akaalias/airloom/docs/designer_log.md

# Designer rounds (headless Claude)

## generation 0 (opening)
*model: claude-haiku-4-5-20251001, claude-sonnet-5*
- `89ffb906b148` — Storm-hardened stiff bruiser: wide thick arms, long wheelbase and thick carbon plates trade mass for structural robustness, targeting the storm scenario that dominates worst-case fitness.
- `7792e42599f3` — Long low-disk-loading arms at exact stock sweep with a safely-oversized plate footprint and carbon construction, targeting hot_thin efficiency without touching the plate-web failure zone.
- `59b9a52c15fa` — Compact, wide, stiff-armed storm-hardened design with a modest sweep shift and generous deck_gap/plate scale margin to clear the prior rotor-to-deck failure.
- `9f8cb660ef38` — Narrow low-drag arms with a tilted battery to cut frontal area for cold_headwind/crosswind, keeping sweep change modest and deck_gap raised for safety margin.
- `9be55419299a` — Heavy-duty ASA build with thick plates and wide arms near stock sweep for maximum stiffness/durability robustness in storm gusts, accepting a mass penalty.
- ~~rejected pre-flight (plate web too thin (plate_main 1.25 mm, stock 1.90 mm))~~ — Low-drag speed racer: long slender waisted arms and minimal-frontal-area carbon-plate build at stock sweeps to hold bolt registration while chasing the lowest steady-cruise Wh/km.
- ~~rejected pre-flight (plate web too thin (plate_main 1.07 mm, stock 1.90 mm))~~ — Ultralight hot/thin-air specialist: short thin arms and PLA+ at the minimum viable plate thickness to cut absolute mass for low-density-air scenarios.
- ~~rejected pre-flight (rotor too close to deck/battery)~~ — Wide-sweep compact X hypothesis: pushes both sweeps ~6-7 deg past stock for a tighter crosswind silhouette, growing the deck plates to protect the tongue bolts, printed in tough PA12-CF.
- ~~rejected pre-flight (plate web too thin (plate_main 1.07 mm, stock 1.90 mm))~~ — Cold-headwind glider: near-minimum sweeps (kept just off the exact minimum to dodge tongue collision) with narrow waisted arms and a steep battery wedge to minimize frontal area into a headwind, printed PETG.

## generation 3 (periodic)
*model: claude-haiku-4-5-20251001, claude-sonnet-5*
- `edbeb4914449` — Moderate-stiffness storm specialist: wider/thicker arms with less waist-narrowing and tough PA12-CF material plus generous deck_gap, betting that structural robustness (not raw mass-adding bulk like earlier failed 'storm-hardened' attempts) trims the worst-case storm penalty.
- `a76a6566ac11` — Wider front/rear sweep for a broader stance to help crosswind/storm stability, paired with generously enlarged (not merely stock) plate scales and deck_gap to safely clear the tongue-bolt and web-crush failures seen at extreme sweep.
- `4ac6230067c7` — Near-stock sweep (small deltas, clear of the tongue-collision minimum) with plate scales pushed well above the 0.95 web-crush threshold and a thicker printed PLA+ build to test a tougher, mass-tolerant alternative to carbon.
- ~~rejected pre-flight (arm tongue bolts miss the main plate)~~ — Sweep-diverged crosswind hypothesis: push rotor azimuth well past stock (front 40, rear 48) with plate scales raised ~0.15 per the coupling rule to protect the FC-stack webs, testing an unexplored rotor-placement regime for crosswind/storm gains.
- ~~rejected pre-flight (plate web too thin (plate_main 1.43 mm, stock 1.90 mm))~~ — Ultra-light short-wheelbase design: shrink arm length and deck_gap to their safe minimums with stock sweeps (avoiding the plate-web/tongue failure zone) and thinner plates, betting mass reduction beats the elites' 114-116 g on hot_thin.

## generation 6 (periodic)
*model: claude-haiku-4-5-20251001, claude-sonnet-5*
- `7b8317ed444b` — Storm-stiffness specialist: a moderately wider stance (5 deg beyond stock both sweeps, plate scales raised per the sweep-deviation rule) with less waist-narrowing and thicker arms/plates than the elites for gust stiffness, while staying on lightweight carbon to avoid the mass penalty that sank earlier 'storm bruiser' attempts.
- `ed5a193d02ea` — Storm-hardened stiff-arm design with arm_length_scale raised to 1.20 (vs the failed 0.88) to restore rotor tip clearance at a near-stock sweep, plus generous plate margins to guard the tongue-bolt/web-crush zones.
- `0744daafc6e2` — Wide-stance crosswind/storm specialist that pushes both sweeps ~6-7 deg past stock for a broader footprint, with plate_length/width_scale raised well past 1.0 (per the ~0.1-per-5-deg rule) to keep the tongue bolts seated and the plate webs thick.
- ~~rejected pre-flight (rotor disks overlap (tip clearance))~~ — Compact minimal-mass frame: shortens the wheelbase and thins arm/plate stock well below the elite cluster to shed frame mass for hot_thin/cruise efficiency, betting that the elites' long-arm strategy has more mass to give up than disk-loading penalty to pay at stock sweep.
- ~~rejected pre-flight (plate web too thin (plate_main 1.44 mm, stock 1.90 mm))~~ — Low-drag headwind/crosswind specialist: minimum arm width and waist plus an aggressive near-max battery tilt at exactly stock sweep to cut frontal/cross-sectional area, targeting the wind-facing scenarios rather than mass.

## generation 9 (periodic)
*model: claude-haiku-4-5-20251001, claude-sonnet-5*
- `8d9fd4a01c9a` — Push arm_length_scale near its max (lowers disk loading) with thin low-drag arms and deliberately cut plate_thickness_scale to 0.75 (below any elite) to shed mass for hot_thin/crosswind, keeping sweep essentially at stock so plate scales need no compensation.
- `01f642b698ee` — Isolate the effect of a genuinely wide stance (front/rear sweep pushed well past stock) from the thick-arm mass penalty that sank earlier wide-stance attempts, by pairing it with thin floor-waist arms and plate scales raised generously to keep the tongue bolts and webs safely clear.
- `2ab37da5aded` — Replaces the failed vector by raising deck_gap well past the elite range (0.034 vs 0.028) and restoring a stiffer plate_thickness_scale (1.1 vs the failed 0.9) to push the rotor disk clear of the deck/battery stack while keeping near-stock sweeps and carbon construction.
- ~~rejected pre-flight (rotor too close to deck/battery)~~ — Test whether a tough printed material (PA12-CF) at the minimum viable plate thickness can match carbon's efficiency on a lean, near-stock-sweep frame, unlike prior bulky printed-material attempts that added unnecessary mass.

## generation 12 (periodic)
*model: claude-haiku-4-5-20251001, claude-sonnet-5*
- `af1499695456` — Isolate the untested battery_wedge_deg dimension (all elites sit at 0.0) by tilting the battery 12 deg to cut frontal area for cold_headwind/crosswind, otherwise cloning the elite recipe's proven arm/plate/material values exactly.
- `ddf19b536a16` — Re-test extreme arm_length_scale (1.35 max, lower disk loading) at stock sweep, this time with plate_length/width_scale raised to 1.00/1.03 (above the elite's barely-passing 0.97/1.00) to keep the tongue-bolt web safely above the 1.90mm stock/80% floor.
- `17da73c894cb` — Re-test the raised deck_gap (0.036, well past the 0.023 FC-stack minimum) for extra rotor/deck clearance margin, again pairing stock sweep with plate_length/width_scale at 1.00/1.03 to avoid the web-crush failure that killed the prior attempt at 0.96/0.96.
- ~~rejected pre-flight (plate web too thin (plate_main 1.25 mm, stock 1.90 mm))~~ — Push arm_length_scale to its true maximum (1.35, beyond any elite's ~1.30) to further lower disk loading and hover power, while keeping arms at floor width/waist/thickness, sweeps at exact stock (zero plate-scale compensation needed), and floor plate thickness/carbon to stay in the proven low-mass recipe.
- ~~rejected pre-flight (plate web too thin (plate_main 1.25 mm, stock 1.90 mm))~~ — Isolate deck_gap as a storm-clearance lever by raising it to 0.036 (well past the elite ~0.026 and the FC-stack minimum) while holding plate_thickness_scale at the floor and sweeps at exact stock, unlike the earlier failed deck_gap attempt that confounded the effect with added plate mass.

## generation 13 (pivot)
*model: claude-haiku-4-5-20251001, claude-sonnet-5*
- `e28f02892326` — Abandon the elite family's tight-deck-gap/no-wedge/floor-thickness trait: push deck_gap near its max for maximum rotor/deck clearance, tilt the battery near its max to cut frontal area, and raise plate_thickness_scale well above the floor for a stiffer core, while holding sweep at stock and arms moderate so none of these three untested dimensions gets confounded with a sweep or mass penalty.
- `197c23808897` — Compact stiff-arm storm specialist replacing the failed short-arm attempt: arm_length_scale raised from the failed 0.78 to 1.2 (within the tip-clearance-safe range the elites themselves use) while keeping the fat, thick, low-narrowing arms and thicker plates that trade mass for storm stiffness the elite family has abandoned.
- `3844ac93fc4c` — Wide-stance crosswind/storm pivot replacing the failed extreme-sweep attempt: sweep deltas trimmed from 11.6/14 deg to a safer 6.6/8 deg past stock and plate_length/width_scale pushed to 1.10/1.15 (well beyond the ~0.1-per-5-deg rule) to keep the tongue bolts seated on the main plate.
- ~~rejected pre-flight (rotor disks overlap (tip clearance))~~ — Abandon the elite family's max-arm-length/thin-everything trait entirely: shrink to near-minimum arm length for higher disk loading but restore arm width/waist/thickness toward the middle of the range for real structural stiffness, testing whether a compact stiff core beats the plateaued long-thin-arm minimalism on storm without paying its usual mass tax.
- ~~rejected pre-flight (arm tongue bolts miss the main plate)~~ — Abandon the elite family's stock-sweep constraint: push both sweeps far beyond stock for a genuinely wide stance (unlike prior failed wide-stance attempts that piled on thick arms), while keeping arms thin/light for low drag/mass and raising plate_length/width_scale well past the web-crush floor so the tongue bolts and webs stay safely seated, isolating stance-width benefit from the mass penalty t

## generation 14 (pivot)
*model: claude-haiku-4-5-20251001, claude-sonnet-5*
- `03a2ffd572b3` — The elite family has converged on a minimum-mass/minimum-drag recipe (thin floor-thickness arms, near-stock sweep, tight deck gap, carbon) that has exhausted every free-mass knob without denting the storm/crosswind penalty, so this pivot abandons near-stock sweep for a genuinely wide stance (front 40, rear 48 deg) with plate scales grown per the sweep-deviation rule to test whether real aerodynami
- `19c8d0829c1b` — Every elite uses material near 0.0 (pure carbon) because prior non-carbon attempts bundled the material switch with a heavy 'storm bruiser' stance that ate the mass budget, so this pivot isolates the material axis alone -- keep the proven elite-shaped long-arm, low-drag, near-stock-sweep geometry intact but swap to PET-CF (0.40) with plate_thickness_scale raised to 0.90 to meet the printed-materia
- `e8b475371bd4` — Re-test the untested battery_wedge_deg=14 frontal-area-reduction dimension, fixing the rotor-tip-clearance failure by raising arm_length_scale from the failed 0.9 to a safe 1.2 while leaving sweep, plate scales and material untouched so only the battery tilt is isolated.
- ~~rejected pre-flight (rotor disks overlap (tip clearance))~~ — Every elite sits at arm_length_scale ~1.3 (low disk loading, long low-drag arms) with battery_wedge_deg untouched at 0, so this pivot flips both traits at once -- a compact, higher-disk-loading frame (arm_length_scale 0.90) paired with an aggressive 14 deg battery tilt to slash frontal area -- isolating whether a shorter/lighter airframe plus real drag-shedding tilt beats the long-arm family on co

## generation 15 (pivot)
*model: claude-haiku-4-5-20251001, claude-sonnet-5*
- `470c4fea7616` — Every elite also sits at the plate_thickness_scale floor (0.7-0.76) with a tight deck_gap (0.025-0.026) -- deck/standoff stiffness and rotor-to-deck clearance under gust loading have never been tested independently of arm geometry or a mass-adding stance change, so this pivot keeps the elite's low-drag floor-thin arms and stock sweep untouched but pushes plate_thickness_scale near its max and deck
- `a55c3afad400` — Storm-stiffness pivot away from the elite family's thin/minimum-mass arms (wide arm_width=1.4, no waist narrowing, thick arm_thickness=0.007, carbon) that failed only on rotor/deck clearance -- fixed by raising deck_gap from the failed 0.027 to 0.04, well clear of the stack.
- `4e66ffd73fcf` — Re-isolate the untested tough ASA material (0.75) against the all-carbon elite family, keeping the same generous arm geometry as the failed attempt but raising deck_gap to 0.042 and trimming plate_thickness_scale to 0.85 (still above the printed-material 0.8 floor) to clear the deck/battery stack.
- ~~rejected pre-flight (rotor too close to deck/battery)~~ — The elite family shares thin/narrow/floor-thickness arms (width 0.75-0.86, waist 0.55, thickness 0.004) with near-stock sweep -- storm has stayed pinned at 4.82-4.84 Wh/km across all of them despite every other scenario improving, suggesting arm flex under gust loading (not mass or drag) is now the binding constraint on storm; this isolates pure arm structural stiffness (max width, max waist/no-na
- ~~rejected pre-flight (rotor too close to deck/battery)~~ — Every elite and every prior material pivot has stayed at material~0.0 (carbon) because past non-carbon attempts bundled the switch with a heavy wide-stance or thin-arm combo that failed on tip deflection or web thickness; this isolates a genuinely tougher thermoplastic (PETG, 0.75) at stock sweep and elite-like plate scale, with arm width/waist pulled back from the elite's drag-optimized extremes 

## generation 16 (pivot)
*model: claude-haiku-4-5-20251001, claude-sonnet-5*
- `a072202cd3c9` — Every elite sits at the arm_waist_scale floor (0.55, maximum mid-shaft narrowing) paired with minimum width -- this pivot decouples the two, isolating waist taper as its own stiffness lever by raising arm_waist_scale to 1.10 (near-constant arm width along the shaft, no pinch point to flex/resonate under storm gusts) while keeping arm_width_scale, arm_thickness, sweep and plate geometry at the elit
- `cadb6dac34da` — Prior material pivots away from carbon always failed validity (arm tip deflection / plate-web-too-thin) because they kept the elite's thin-waist thin-arm shape unchanged for a lower-modulus polymer -- this pivot properly compensates by isolating PETG (damped, tough) with arm_thickness raised to 0.0065 and arm_waist_scale relaxed to 0.80 to prevent tip deflection, and plate_thickness_scale set to 1
- `f25111665ee7` — Replaces the failed 14-deg rear-sweep pivot: trims the deviation to 10 deg past stock and grows plate_length/width_scale to 1.22/1.25 (above the prior 1.15/1.2 that let the tongue bolts miss the main plate) while keeping the same lean thin-arm carbon build to isolate wide-stance stiffness from mass penalties.
- ~~rejected pre-flight (arm tongue bolts miss the main plate)~~ — The elite family has converged on a symmetric near-stock, minimum-everything (thin waist, thin width, floor thickness) stance that has plateaued on storm/crosswind; this pivot keeps the elite's low-mass thin arms but pushes rear_sweep_deg alone to a genuinely wide 50 deg (asymmetric DeadCat stance) with plate scales grown per the sweep-deviation rule, testing whether real aerodynamic/yaw-stability

## generation 17 (pivot)
*model: claude-haiku-4-5-20251001, claude-sonnet-5*
- `83f19dec5965` — Isolate pure aerodynamic stance from the mass penalty that sank every prior wide-sweep attempt: push both sweeps well past stock (front +12, rear +14) with plate scales grown generously (1.28/1.24) to keep the tongue bolts safely seated, while leaving the elite's thin floor-mass carbon arms completely untouched.
- `232aae2975ed` — Every prior storm-stiffness pivot added mass to the arms and made the aggregate worse, so instead stiffen the deck/standoff core (deck_gap raised to 0.040, plate_thickness_scale raised to 1.25) while keeping the proven thin-arm, stock-sweep, low-drag geometry completely unchanged, isolating core stiffness from arm stiffness for the first time.
- `41f6a5857003` — Same PLA+ stiff-arm/thick-plate pivot as the failed design, but with deck_gap raised from 0.028 to 0.04 since the thicker plate_thickness_scale=1.0 stack consumes more of the standoff and starved rotor-to-deck clearance at the smaller gap.
- ~~rejected pre-flight (rotor too close to deck/battery)~~ — Every non-carbon material pivot so far failed validity because it kept the elite's thin-waist, thin-arm, floor-thickness shape unchanged for a lower-modulus polymer; this pivot properly commits to PLA+ (damped, tough) with arm_thickness raised to 0.0065, arm_waist relaxed to 0.85, arm_width to 0.85 and plate_thickness_scale to 1.0, giving real margin above the printed-material floors instead of ch

## generation 18 (pivot)
*model: claude-haiku-4-5-20251001, claude-sonnet-5*
- `7adc86c167f8` — Stake out a genuinely wide-stance aero region by combining far-from-stock sweeps (front 43, rear 52, plate scales grown per the 0.1-per-5-deg rule) with an untested 8-deg battery wedge, isolating a combined frontal/side-profile reduction strategy for crosswind and cold_headwind that no prior single-axis sweep or wedge pivot tested together.
- `d8d770d5f10a` — Switch away from carbon to a tough, damped ASA build (material 0.9) with thickness, width and waist properly compensated (arm_thickness 0.006, waist relaxed to 0.85 to remove a pinch-point resonance node, plate_thickness_scale 1.0) to test whether damage tolerance under gust loading can genuinely cut the storm penalty that dominates the fitness function, unlike prior uncompensated material pivots 
- ~~rejected pre-flight (rotor disks overlap (tip clearance))~~ — Abandon the elite's long-thin-arm minimum-mass trait entirely by shrinking arm_length_scale to the compact end of the range (0.82) with moderately increased width/waist/thickness for tip stiffness at the shorter span, testing whether a tighter, stiffer disk-loading regime beats the long-arm low-drag strategy.
- ~~rejected pre-flight (rotor too close to deck/battery)~~ — Fixes the rotor-tip-overlap failure by raising arm_length_scale from the failed 0.82 to 1.0 (still well short of the elite's 1.27-1.31) while keeping the same stiffer wide-waist, thicker-shaft storm-specialist geometry untouched, testing a moderate-length stiff arm as a genuine pivot from the elite's thin-minimal-mass family.

## generation 19 (pivot)
*model: claude-haiku-4-5-20251001, claude-sonnet-5*
- `624da8bb96ab` — The elite family shares a floor-thickness, minimum-mass build where every attempt to add stiffness got starved by mass penalty — so isolate the opposite extreme (near-max arm width/waist/thickness plus near-max plate thickness, sweep held at stock and deck_gap generously raised for stack clearance) to see whether real structural stiffness ever pays off for storm once mass is not being traded piece
- `0e35d1c372f5` — Same combined wide-stance-plus-battery-wedge frontal-area pivot as the failed design, but grow plate_length/width_scale to 1.28/1.24 -- the pairing already proven to keep the tongue bolts seated at this exact +12.6/+14 deg sweep deviation -- instead of the too-thin 1.22/1.18 that let them miss the main plate.
- ~~rejected pre-flight (arm tongue bolts miss the main plate)~~ — Every elite sits at near-stock sweep because wide-sweep attempts keep getting offset by the plate-scale mass they require, so push sweep far past stock (front +10.6, rear +14 deg, matching the ratio of the one prior VALID wide-sweep design) combined with a near-max battery wedge and the elite's leanest arm dimensions to isolate pure frontal/side-profile reduction from any stiffness-driven mass con
- ~~rejected pre-flight (rotor disks overlap (tip clearance))~~ — Every elite also shares a near-maximum arm_length_scale (1.26-1.31) that has never been abandoned, so test a genuinely short-wheelbase/high-disk-loading stance (~30% shorter arms than any elite) with only moderate width/waist since a shorter beam needs less material to resist bending, staying at stock sweep and floor plate thickness to isolate the wheelbase axis from every other trait.
- ~~rejected pre-flight (rotor too close to deck/battery)~~ — Same contrarian pivot testing moderate arm width/waist (0.95/0.70) against the elite family's minimum-width-and-waist recipe, but raise arm_length_scale from the failed 0.92 to 1.08 to restore rotor-tip clearance while staying well below the elites' near-max 1.27-1.31 arm length.

## generation 20 (pivot)
*model: claude-haiku-4-5-20251001, claude-sonnet-5*
- `216648201249` — The elite family's floor-thickness/min-width/min-waist arms have exhausted every mass-reduction lever without denting the storm penalty; combine the two previously-isolated promising stiffness levers -- waist decoupling (arm_waist_scale=1.2, no pinch point, scored 6.630 alone) and deck/core stiffening (plate_thickness_scale=1.35, deck_gap=0.040, scored 6.504 alone) -- into one genuinely stiff-arm,
- `f45e862cd6b3` — Battery wedge is the only frontal-area lever that ever came close to the elite in isolation (wedge=14 scored 6.371) while every symmetric sweep-widening attempt lost to its own plate-mass penalty, so push wedge to its true max (15) and pair it with an asymmetric tight-nose/wide-tail sweep (front at the 30 deg floor, rear opened to 46) to shift the aerodynamic center for storm/crosswind stability i
- `cc53cd9d248e` — Every material pivot away from carbon has failed validity because it kept the elite's thin-shell dimensions unchanged; properly compensate PA12-CF's higher density and lower stiffness this time (arm_thickness raised to 0.006 to fix the repeated pa12_cf tip-deflection failure, plate_thickness_scale raised to 1.0, well above the 0.8 printed-material floor) to cleanly test whether its damage toleranc

## generation 21 (pivot)
*model: claude-haiku-4-5-20251001, claude-sonnet-5*
- `5e6a89c82c1d` — Battery wedge and deck_gap have each been isolated before (both landing worse than elite alone) but never combined; this pivot pushes both to near their maxima together -- generous deck_gap (0.043) giving the max battery tilt (15 deg) safe rotor/battery clearance -- with moderate (not elite-extreme) arm_length_scale (1.15) and stock sweep, testing whether the clearance-vs-wedge interaction unlocks
- `8b5de20a6d4e` — Same genuine wide/thick/no-pinch arm stiffness test as the failed design, but the short arm_length_scale=0.85 was shrinking motor separation enough to overlap rotor disks, so arm_length_scale is raised to 1.1 for safe tip clearance, and sweep is nudged off the tongue-collision-prone minimum (front 38/rear 44, with plate scales grown 0.1 to match) instead of sitting right near the 33/38 near-minimu
- ~~rejected pre-flight (arm tongue bolts miss the main plate)~~ — The elite family's shared trait is long arms (1.27-1.31) near stock sweep; this pivot goes to the opposite extreme -- short arm_length_scale (0.80) to cut arm mass -- compensating the resulting rotor-tip-clearance risk with far-wider-than-stock sweep (47/58 deg) and plate scales grown per the 0.1-per-5-deg rule, testing a genuinely compact-frame region no elite has explored.
- ~~rejected pre-flight (rotor disks overlap (tip clearance))~~ — Every prior max-stiffness attempt (wide width/waist/thickness) confounded the stiffness gain with the elite's long-arm mass and triggered arm-resonance-with-rotor-1P failures, so this pivot pairs near-max arm width/waist/thickness with a much SHORTER arm (0.85) instead -- shifting the natural frequency away from 1P while keeping total mass in check -- isolating real structural stiffness for the fi
- ~~rejected pre-flight (rotor too close to deck/battery)~~ — Same short-arm, wide-sweep frontal/side-profile pivot as the failed design, but trimmed to the proven-safe 43/52 deg sweep pairing (validated at plate 1.28/1.24 in a prior generation) and the waist relaxed from the max-pinch 0.55 to 0.65 so the root tongue geometry isn't over-narrowed at the more extreme rotation.

## generation 22 (pivot)
*model: claude-haiku-4-5-20251001, claude-sonnet-5*
- `8eef9a028a5b` — Prior wide-sweep-plus-wedge attempts always paired a tight front with a wide rear; the reverse asymmetry (wide front, tight rear) shifting the aero center forward, combined with max battery wedge, has never been tested and could better address crosswind/cold_headwind while keeping the proven thin-mass carbon arms untouched.
- `6e14487e2184` — Every previous ASA/PA12-CF/PET-CF/PETG pivot under-compensated on only one axis (thickness alone) and failed validity or scored worse; this fully compensates a tough, damped ASA build simultaneously across arm_thickness (near-max), waist (relaxed to remove the pinch-point resonance node), shortened arm_length (less moment arm), and plate_thickness (well above the printed floor) to give damage-tole
- `245f65ba6586` — Same short-arm, high-disk-loading pivot away from the elite family's long-arm floor-mass shape, but the rotor/deck clearance failure is fixed by raising deck_gap from 0.026 to 0.038 (well clear of the FC/battery stack) with a small plate-scale margin bump for the moderate sweep spread.
- ~~rejected pre-flight (rotor too close to deck/battery)~~ — Every elite sits at max arm_length_scale (1.26-1.31, near-maximum wheelbase/disk loading) — the opposite short-wheelbase, high-disk-loading region has never been validly tested with the elite's proven thin-shell mass floor, so this isolates wheelbase/moment-arm length as its own axis, moderating sweep off the collision-prone minimum for tongue clearance.

## generation 24 (periodic)
*model: claude-haiku-4-5-20251001, claude-sonnet-5*
- `a5e052287a6b` — Decouple root stiffness from tip drag by moderately widening only the arm root (arm_width_scale=0.95) while keeping the waist at the proven floor (0.55) for a tapered thick-root/thin-tip profile -- every prior stiffness pivot widened width AND waist together and always lost, so this isolates root-only reinforcement against storm gust torque without the uniform-width mass/drag penalty.
- `720187ca68c8` — Layer a mild, previously-untested plate_thickness_scale bump (0.85, well below the 1.25-1.35 extremes that always lost to mass penalty) onto elite frame 83's exact proven geometry, isolating whether a small core-stiffness increment trims the storm penalty without the mass cost that sank every prior aggressive core-stiffening attempt.
- `b5fd89cd1e22` — Same short-arm, high-disk-loading pivot as the failed design, but raise arm_length_scale from 0.76 to 0.83 (still shorter than every current elite's floor of 0.884) to restore rotor-tip clearance at this sweep, keeping width/waist/thickness/sweep/plate/deck_gap/material identical to isolate exactly how short the arms can go before disk overlap trumps mass savings.
- ~~rejected pre-flight (rotor disks overlap (tip clearance))~~ — Push arm_length_scale to the true genome floor (0.76), well below any elite's tested minimum (0.884), at the exact sweep/deck_gap combo already proven safe by elite frame 84 -- the g22 short-arm pivot to 6.172 hinted lower disk loading keeps paying off, so isolate the extreme low end cleanly.

## generation 26 (pivot)
*model: claude-haiku-4-5-20251001, claude-sonnet-5*
- `d1bffb1194ce` — The entire elite family shares maximal arm_length compression (0.83-0.92, far below the 1.35 ceiling) - every mass lever has been squeezed on that axis but disk-loading itself has never been isolated, so push arm_length_scale to 1.30 (longer arms only increase rotor separation, so tip-overlap risk drops rather than rises) while holding every other gene at the proven floor-mass carbon values to tes
- `6125754bf985` — Every prior waist pivot bundled the waist change with a root-width increase and always lost to the combined mass penalty or triggered resonance; this isolates the mid-shaft taper alone by keeping arm_width_scale at the elite floor (0.75) and removing the pinch (arm_waist_scale raised to 1.00, well short of the 1.2+ combos that previously failed) with only a token thickness nudge for safety, testin
- `8cfdbc772b8d` — Every material pivot away from carbon has failed validity or scored worse because each only over-compensated one axis at a time; this abandons carbon outright for PET-CF (material=0.40) while applying every lesson learned at once - thickness raised well past every previous tip-deflection failure point (0.007), waist relaxed to remove the pinch resonance node (0.85), width nudged up for margin (0.8

## generation 27 (pivot)
*model: claude-haiku-4-5-20251001, claude-sonnet-5*
- `71f4f5ad9388` — The entire elite family shares narrow near-stock sweep (36/42) paired with short arms (0.83-0.92) -- a minimum-frontal-profile, minimum-disk-loading compromise that has plateaued storm at 4.72-4.75; this pivot commits fully to the opposite side of that tradeoff by combining short arms (0.85, near the validated tip-clearance floor) with a genuinely wide splayed sweep (front 44, rear 50, plate scale
- `1b9800417e5c` — Long arm_length has only ever been tested bundled with a waist change and elite-adjacent sweep (scored worse at 6.358), never paired with genuinely tight, near-floor sweep on both axes -- this isolates true low-disk-loading, minimum-frontal-profile geometry by pushing arm_length to 1.32 while pulling sweep close to the stock minimum (32/36, with a small buffer off the true 30/34 floor to avoid ton
- `38fcbadb6e41` — Every prior material pivot bolted single-axis compensation (thickness alone, or thickness+waist) onto the elite's short-arm/near-stock-sweep carbon shape and always lost; this instead rebuilds proportions from scratch around untested PETG (material 0.75) with arms genuinely elongated (1.05, cutting disk loading) plus simultaneously widened (0.85) and de-pinched (waist 0.85) for real stiffness marg

## generation 28 (pivot)
*model: claude-haiku-4-5-20251001, claude-sonnet-5*
- `ff31eeb40243` — Every prior tough-material pivot (ASA/PA12-CF/PET-CF/PETG) kept the elite's short, near-stock-sweep arm proportions and either under-compensated or still lost, so this pivot pairs a fully committed ASA build (material 0.9, arm_thickness well past every past tip-deflection failure point, waist and width both relaxed, plate_thickness_scale at a full 1.0 margin above the printed-material floor) with 
- `029bbd037a82` — Same long-arm low-disk-loading pivot as the failed design, but instead of pairing it with a wide 42/48 sweep that missed the main plate, hold sweep at the proven-valid 36/42 elite pairing (already validated with arm_length_scale=1.30 in frame d1bffb11) and only modestly grow plate scale (1.05/1.05) to buffer the wider/de-pinched root against the width and waist stiffness increase.
- `b154ee088551` — Same max-battery-wedge frontal-area reduction test at near-stock sweep, but raise arm_length_scale from 0.85 to 1.15 (past the previously-validated clearance fix of 1.1) to restore rotor tip separation instead of letting the short arms overlap.
- ~~rejected pre-flight (arm tongue bolts miss the main plate)~~ — The elite family has plateaued because every gene sits at its mass/drag floor (short arms, floor width/waist, floor plate thickness) with zero stiffness margin against storm's gust loading, so this pivot commits to genuinely long arms (1.30, which past tests confirm increases rather than decreases rotor-tip clearance) combined -- for the first time -- with a real width/waist stiffness bump and a w
- ~~rejected pre-flight (rotor disks overlap (tip clearance))~~ — Battery wedge has only ever been tested bundled with a widened or asymmetric sweep, confounding whether the tilt itself helps; this pivot isolates the wedge's true effect by pushing it to its max (15 deg) while holding sweep near the floor (but off the exact tongue-collision minimum) and arms at the proven floor-mass, floor-width shape, with deck_gap raised generously to give the max-tilt battery 

## generation 29 (pivot)
*model: claude-haiku-4-5-20251001, claude-sonnet-5*
- `ec9339002012` — The entire elite family sits at zero battery wedge with short 0.83-0.92 arms, so the two frontal-area/induced-power levers that each hit ~6.35-6.37 in isolation have never been combined; pair long arms (1.30, previously validated for tip clearance at stock sweep) with max battery wedge (15) and the wedge-clearance deck_gap (0.043) to test whether lower disk loading plus reduced frontal area jointl
- `093c1d4d8456` — Every prior PA12-CF/PET-CF/ASA/PETG pivot stacked its material compensation onto longer or wider arms and always lost to the combined mass penalty; keep the arm at the validated short, low-moment floor (0.85) with only a moderate width/waist/thickness bump and the minimum printed-material plate floor (0.9) to test whether a genuinely short-arm PA12-CF build is the missing configuration that makes 
- `3edd371fb561` — Same splayed-sweep, short-arm frontal-area pivot, but pull both sweeps back 2 deg and add far more plate-scale margin (1.22/1.20 vs 1.15/1.12) plus trim arm_width to 0.82 to shrink the tongue footprint, since the prior attempt's margin wasn't enough to keep the tongue bolts on the main plate.
- ~~rejected pre-flight (arm tongue bolts miss the main plate)~~ — Wide splayed sweep (front 44/rear 50) has only ever been tested with floor-width arms and lost to torsional penalties in storm/crosswind; this pairs the same validated wide-sweep, tip-clearance-safe short arm (0.85) with root-only width reinforcement (0.90, waist left at the floor taper) and enough plate growth to keep the tongue bolts on the plate, isolating whether targeted root stiffness finall

## generation 30 (pivot)
*model: claude-haiku-4-5-20251001, claude-sonnet-5*
- `9f871c62ad20` — Every current elite shares floor-mass arm width/waist/thickness bundled with short arms; this pivot fully commits to the opposite corner - long arms for low disk loading plus genuinely reinforced width/waist/thickness for real gust stiffness, at the proven-safe 36/42 sweep pairing, to test whether authentic structural margin (not just arm-length) is what unlocks past the storm plateau.
- `61158ead8b8c` — Combine long-arm low disk loading with max battery wedge and max deck_gap for frontal-area reduction, plus a real deck-stiffness bump - an aero+clearance+stiffness combo never tested together (prior wedge+arm-length tests kept plate_thickness at the floor), at the same proven 36/42 sweep pairing.
- `815bffc7f216` — Every material pivot away from carbon so far paired its compensation with the elite's short-arm shape and lost; this pairs long arms (lower disk loading, more distributed load path) with real thickness/width margin for genuine PETG toughness, testing whether the material only wins in a different geometric family.
- ~~rejected pre-flight (arm tongue bolts miss the main plate)~~ — Every elite shares a near-symmetric tight sweep (36/42) that minimizes frontal area uniformly on both axes; this pivots to a genuinely untested nose-tight/tail-wide asymmetry (33 front, 54 rear) to cut frontal cross-section right at the nose where headwind/crosswind bite hardest, while letting the rear arms splay wide (clear of the flight-facing profile) for prop clearance, with plate scales grown
- ~~rejected pre-flight (arm tongue bolts miss the main plate)~~ — Long arm_length (low disk loading) and wide sweep (reduced rotor interference) have each been isolated and each lost narrowly on their own, but never combined with adequate plate-scale margin; this stacks arm_length_scale=1.30 with a genuinely wide symmetric 42/48 sweep and plate scales sized for that spread to test whether the aero/interference gains of both levers together finally outweigh their
- ~~rejected pre-flight (arm tongue bolts miss the main plate)~~ — The elite family's arm_length_scale floor (0.83) was set by rotor-tip/deck collisions, but the deck_gap used there (0.04) is well short of the 0.045 max, so it's unproven whether the binding constraint was tip overlap or deck clearance; this pivot pushes deck_gap near its ceiling (0.044) to free the deck-collision constraint and tests a shorter arm_length_scale (0.78) than any valid prior design, 

## generation 31 (pivot)
*model: claude-haiku-4-5-20251001, claude-sonnet-5*
- `15ac485d0093` — The entire elite family shares a short-arm/high-disk-loading, zero-wedge, near-stock-sweep floor-mass build that keeps storm at 4.72+; this pivot abandons short arms for a genuinely low-disk-loading long-arm geometry (1.28, validated valid territory) while simultaneously pulling both sweeps to their tightest safe margin (32/37) for minimum frontal profile and adding max battery wedge (15deg) with 
- `8180dd9759e5` — Every previous material pivot bolted heavy over-compensation (max thickness, relaxed waist, wider width) onto a material change and always lost to the mass penalty; this instead pairs PET-CF (material 0.40) with the elite's proven low-stress short-arm geometry and only minimal thickness/width/waist nudges above the printed-material validity floor, testing whether toughness alone -- without brute s
- `cbb51c89c940` — Real structural stiffness margin (width+waist+thickness raised together) and battery-wedge frontal-area reduction have each been isolated separately and both lost to a single-axis mass penalty, but never combined at the proven short-arm/stock-sweep baseline; this pivot stacks a genuine (not extreme) stiffness bump with max wedge and max deck_gap to test whether jointly attacking storm's structural

## generation 32 (pivot)
*model: claude-haiku-4-5-20251001, claude-sonnet-5*
- `396bda910391` — Isolate pure deck/stack rigidity by committing real plate_thickness_scale (1.2, still carbon) and max deck_gap while holding every arm gene at the proven elite floor and stock sweep pairing -- every prior stiffness pivot bundled arm width/waist increases with the thickness bump and lost to the combined mass penalty, so this tests whether deck stiffness alone, not arm stiffness, is what storm actua
- `e355e5e9089c` — Every prior tough-material pivot (ASA/PA12-CF/PET-CF) has been tested at zero battery wedge and every wedge pivot has been tested only with long arms, so this combines a validated ASA build (material=0.9, thickness/waist/width well past prior tip-deflection failure points, plate_thickness_scale=1.0 margin) with max battery wedge and its validated clearance deck_gap, at the safe stock-adjacent 36/4
- ~~rejected pre-flight (arm tongue bolts miss the main plate)~~ — Combine long-arm low disk loading with a wide splayed sweep for reduced frontal profile, while holding width/waist/thickness/material at the absolute floor-mass values -- every prior long-arm test paired it with stiffness/wedge additions (mass penalty) and every prior wide-splay test paired it with short arms only, so this is the first genuinely floor-mass long-arm+splay combination, testing wheth
- ~~rejected pre-flight (rotor disks overlap (tip clearance))~~ — Invert the elite family's front<rear sweep asymmetry (front pushed wide, rear tucked near stock) at the validated short-arm floor-mass geometry -- every prior sweep pivot moved both sweeps in the same direction together, so this isolates whether front-loaded splay (an untested asymmetry direction) changes gust/crosswind response without the mass cost of a symmetric wide splay.
- ~~rejected pre-flight (arm tongue bolts miss the main plate)~~ — Real structural margin (width+waist+thickness raised together) has only ever been tested bundled with battery wedge, never in isolation; this isolates genuine stiffness reinforcement against storm gust torque at carbon floor mass, paired with only a modest +2deg sweep splay beyond the elite's 36/42 (well inside the safe stock-buffer with proportional plate growth) and a slight arm-length bump for 

## generation 33 (pivot)
*model: claude-haiku-4-5-20251001, claude-sonnet-5*
- `17af4a9ef561` — Every past battery-wedge test bundled the frontal-area cut with longer arms or a material swap and lost to that confound; this applies max battery_wedge (15deg) with the wedge-clearance deck_gap (0.043) directly onto the otherwise-untouched elite floor-mass short-arm carbon baseline to finally isolate whether frontal-area reduction alone beats 6.144.
- `569ca6a7ac96` — Isolate a modest (not extreme) arm-length increase alone at the exact validated elite baseline — every prior long-arm pivot jumped straight to 1.28-1.32 and lost to the mass/moment penalty, so this tests whether a mild disk-loading reduction (1.08, still well clear of tip-overlap since longer arms only add separation) pays off without that penalty.
- `ad807299c4ea` — Isolate a moderate battery wedge alone on the exact validated elite geometry with a touch more deck_gap for wedge clearance — every prior wedge test bundled it with long arms or extra plate thickness, so this checks whether frontal-area reduction pays off on its own without that compounded mass cost.
- ~~rejected pre-flight (rotor disks overlap (tip clearance))~~ — Every past pivot only ever tested arm_length_scale longer than the elite's 0.83-0.92 band (all of which lost on induced power), never shorter; this pushes to 0.78 -- below any previously tested value -- at otherwise-identical elite floor-mass geometry to test whether further mass reduction beats the higher disk loading.
- ~~rejected pre-flight (rotor too close to deck/battery)~~ — Deck_gap has sat at 0.04-0.043 in every elite and pivot to date purely as wedge-clearance overhead, but its own mass/drag cost in isolation has never been tested; pull it to 0.028 (just above the 0.023 FC-stack floor, well clear of the 'rotor too close to deck' failure margin) at otherwise-identical elite geometry with zero wedge to isolate the standoff-length lever alone.

## generation 34 (pivot)
*model: claude-haiku-4-5-20251001, claude-sonnet-5, claude-sonnet-5*
- `32e907f6be9c` — Every symmetric wide-sweep pivot has failed either on tongue-bolt geometry or fitness, but decoupled front/rear sweep has never been tried; this keeps the front tight near true stock (32 deg, avoiding frontal-area cost) while opening only the rear sweep (48 deg) for better rear-rotor separation, with generous plate growth (1.28/1.20, well beyond the 1.15/1.13 that previously still failed at 42/48)
- `c76d7cceb5c2` — Every past pivot pushed a lever to its floor or its extreme (min-mass elite vs. maxed-out width/waist/thickness/wedge attempts) and all the extremes lost, but a uniformly moderate build across arm length, width, waist, thickness, plate margin and wedge has never been tested as a combination -- this isolates whether real-but-restrained margin on every axis at once (rather than one axis pushed hard)
- `6d24a438dc8f` — Every prior long-arm pivot kept the elite's off-stock 36/42 sweep and lost to the added mass/moment penalty; this instead pairs a moderate arm-length increase (1.15, for lower disk loading) with the true stock sweep (31.4/36) rather than the elite's swept-forward geometry, keeping width/waist/thickness and plate scale at the floor-mass carbon baseline to test whether stock sweep removes the tongue
- ~~rejected pre-flight (arm tongue bolts miss the main plate)~~ — Every prior short-arm test stopped at 0.83-0.92, never approaching the true 0.75 floor; this pushes arm_length_scale to 0.76 (below all tested elites) while opening both sweeps modestly (38/44 vs the elite's 36/42) to preserve rotor tip clearance at the shorter arm, isolating whether there is still uncaptured mass savings below the elite's tested floor.
- ~~rejected pre-flight (arm tongue bolts miss the main plate)~~ — PA12-CF has only ever been paired with either the elite's short-arm floor-thickness shape or bundled with arm-length changes; this instead pairs a moderate (not extreme) PA12-CF reinforcement with a genuinely wide splayed stance (front 42/rear 48, plate scale grown to match) to test whether toughness plus a wider structural footprint -- rather than toughness plus arm length -- is the missing combi
- ~~rejected pre-flight (plate web too thin (plate_main 1.43 mm, stock 1.90 mm))~~ — Max battery wedge has only ever been tested with long arms or extra plate thickness, and tight sweep has only been tested bundled with long arms too; this stacks max wedge (15deg) with a tight, near-stock sweep (32/37) at the validated 0.87 elite arm length to attack frontal area from wedge and silhouette simultaneously without the long-arm mass penalty that sank every prior wedge pivot.

## generation 36 (pivot)
*model: claude-haiku-4-5-20251001, claude-sonnet-5*
- `ca88346c95ae` — Every past printed-material pivot bundled the switch with heavy over-compensation (max thickness, relaxed waist/width) and lost to the mass penalty, or with long arms; this instead pairs PA12-CF (material 0.25) with the elite's exact floor-mass short-arm geometry and only the minimum thickness/width/waist margin needed to clear the pa12_cf deflection floor and the 1.6 mm plate-web requirement, iso
- ~~rejected pre-flight (plate web too thin (plate_main 1.43 mm, stock 1.90 mm))~~ — Every elite already sits near-floor on width/waist/thickness/material/wedge but still carries arm_length_scale=0.83 and 36/42 sweep with 1.02 plate scale; this pushes arm_length to near its true floor (0.76) paired with true-stock sweep (32/37, minimizing deviation) so plate scale can also drop toward its validity floor (0.97/0.97), testing the genuinely minimum-mass corner that no prior pivot has
- ~~rejected pre-flight (rotor disks overlap (tip clearance))~~ — Decoupled front/rear sweep and max battery wedge have each been tested alone (6.243 and 6.229 respectively) but never combined; pairing a tight front sweep (32 deg, minimal frontal profile) with a wide rear sweep (50 deg, better rear rotor separation) and full 15 deg wedge -- with plate scale grown enough (1.25/1.18) to keep the rear tongue bolts valid -- tests whether frontal-area and rear-separa
- ~~rejected pre-flight (rotor disks overlap (tip clearance))~~ — Retry the below-elite-footprint pivot (arm_length 0.76, tight sweep, plate 0.97) that failed on web thickness by keeping arm_length near-floor (0.80) and tight near-stock sweep (32/37), but restoring plate_length/width_scale to the elite-safe 1.02 so the FC-stack webs stay above the stock minimum instead of being crushed.
- ~~rejected pre-flight (arm tongue bolts miss the main plate)~~ — Retry the max-wedge plus wide-rear-sweep frontal-area pivot that overlapped rotor disks despite generous plate growth (tip clearance is an arm-geometry constraint, not a plate-size one) by pulling rear sweep back from 50 to 44 and growing arm_length_scale to 1.00 for genuine tip separation, while keeping width/waist/thickness at the floor and wedge maxed for the frontal-area cut.

## generation 39 (periodic)
*model: claude-haiku-4-5-20251001, claude-sonnet-5*
- `a07db56c3819` — The only material pivot that has ever matched the elite (PA12-CF at the exact floor-mass short-arm geometry, g36 ca88346c, 6.113) has never been repeated with ASA -- every ASA test so far bundled it with long arms, max wedge, or heavy over-reinforcement and lost badly (6.68-7.39); this isolates ASA at the identical proven floor-mass geometry with only the minimal arm-thickness and plate-thickness 
- `949d42134462` — Every past max-deck_gap or minimum-arm-width test was confounded with battery wedge, long arms, or full waist relaxation; this pushes arm_width_scale to its absolute floor (0.75, maximum root drag/mass cut) with a compensating waist bump for tip stiffness and pairs it with max deck_gap (0.045) for unobstructed prop wash under the deck -- a joint minimum-frontal-arm-section plus max-clearance combo
- `ba3335941d8f` — Retry the decoupled-rear-sweep widening (front held at 36 near-stock, rear now only +3 deg past the validated 42-deg elite rather than +4 past it, at 46) with plate_length_scale and plate_width_scale both raised well past the elite's 1.03 baseline (to 1.15) so the tongue bolts stay clear of the main plate edge this time.
- ~~rejected pre-flight (arm tongue bolts miss the main plate)~~ — Every prior decoupled-sweep test used a large delta (32/48) that broke tongue-bolt plate geometry or lost on fitness, and every sweep change has kept the front/rear pair locked together; this widens only the rear sweep by a modest 4 deg beyond the elite's 42 (for better rear-rotor wake separation in storm/crosswind) while holding the front at the proven 36, with just enough plate-scale growth on t

## generation 42 (periodic)
*model: claude-haiku-4-5-20251001, claude-sonnet-5*
- `dbcbc5511a2c` — Every past arm_waist change was bundled with width/thickness bumps for stiffness or with wedge/long-arm pivots and lost, so this isolates a genuine further mid-shaft narrowing (0.58->0.48) at the exact elite floor-mass geometry, with only a minimal thickness bump (0.0042->0.0046) to cover the pa12_cf deflection floor, to test whether mid-arm drag cut alone pays off without a confounding lever.
- `95e920477f01` — The pa12_cf elite family only won by being lighter than carbon at a thickness margin forced up to the printed-material 0.8 floor, but carbon plate has no such floor and is stiffer per unit thickness, so this switches to carbon (material 0.08) at the identical elite geometry while cutting plate_thickness_scale to 0.62 and arm_thickness to 0.0038 to test whether carbon's higher stiffness lets it und
- `ef6352398ebc` — Same PA12-CF short-arm/36-42-sweep design as the failed attempt, but restore plate_length_scale/plate_width_scale to the validated ~1.03/1.02 elite range instead of shrinking them to 0.97/0.96, since the failure was a too-thin main-plate web from under-scaled plates, not the arm or material genes.
- ~~rejected pre-flight (plate web too thin (plate_main 1.25 mm, stock 1.90 mm))~~ — Every previous plate-scale test only ever raised plate_length/width_scale for margin or sweep clearance, never lowered it, but the elite's sweep is only mildly off-stock (4.6/6.1 deg) so this pushes plate_length_scale/plate_width_scale down toward the ~0.95 web-crush floor (0.97/0.96) at the unchanged elite arm and sweep geometry to directly test whether the extra plate margin the elite carries is

## generation 43 (pivot)
*model: claude-haiku-4-5-20251001, claude-sonnet-5*
- `2870779c5946` — Every prior long-arm pivot paired the lower disk loading with either a printed-material thickness floor or extra width/waist stiffness margin and lost to the combined mass tax, but carbon's superior stiffness-per-mass has never been paired with genuinely long arms and truly minimal thickness/plate mass, testing whether it lets long arms finally pay off.
- `52d0f02aaee2` — Every past max-wedge test held sweep near stock and every open-rear-sweep test used minimal-margin materials, so this stacks max battery wedge (frontal-area cut) with a genuinely opened rear sweep (prop-wash separation for storm gusts) and tough ASA with real plate stiffness, none of which has been combined before.
- `b060e8d5d1be` — Every past stiffness pivot bundled width AND thickness increases together, conflating frontal-drag-adding width with drag-neutral through-thickness bending stiffness, so this isolates a thin-narrow-but-maximally-thick carbon arm cross-section (min width, low waist, max thickness) to test whether out-of-plane stiffness alone -- without added frontal profile -- cracks the storm plateau.

## generation 44 (pivot)
*model: claude-haiku-4-5-20251001, claude-sonnet-5*
- `044e16447b73` — The plateau is built entirely on floor-mass PA12-CF short arms (0.79-0.81) with minimal stiffness margin -- storm is stuck at 4.63-4.64 across every elite variant, so this pivots to carbon (no printed-material thickness floor) with genuinely long arms (1.22, lower disk loading and more prop-wash separation) plus real width/waist/thickness stiffness margin and a moderate 8deg wedge, at the proven-s
- `5bc6b43ed5d9` — Every past stiffness pivot either isolated one axis (thickness alone failed on arm resonance) or bundled stiffness with a mass-cutting confound and lost; this abandons mass optimization entirely for a storm-hardened build -- wide arms (1.1), minimal waist narrowing (1.1), thick shafts (0.0075) and thick ASA plates (1.1x) at stock geometry and zero wedge -- to test whether committing real structura
- `72423ad99024` — Max battery wedge has only ever been tested with short printed-material arms or bundled with sweep changes that broke tongue geometry; this instead pairs carbon (dodging the printed-material floor to keep mass low) with a genuinely narrow arm cross-section (0.6 width, real drag cut) and a longer arm (1.1) at the untouched stock sweep, stacking frontal-area reduction from both the wedge and the arm
- ~~rejected pre-flight (plate web too thin (plate_main 1.44 mm, stock 1.90 mm))~~ — Every prior aero pivot attacked frontal area (wedge) or mass separately at the elite's short-arm geometry, but never combined max wedge with a genuinely narrower side profile (plate_width_scale near the web-crush floor) on unlimited-thickness carbon, so this tests whether cutting BOTH frontal and side silhouette at once -- rather than cutting mass -- is what storm and crosswind actually want.
- ~~rejected pre-flight (arm tongue bolts miss the main plate)~~ — Past long-arm pivots (up to 1.28) always lost to the mass/moment penalty while still carrying pa12_cf's thickness floor or extra width/waist margin, and past wide-rear-sweep pivots never used carbon's floor-free thin plates, so this pushes arm length further (1.25) with asymmetric sweep for rear-rotor wake separation on a genuinely thin carbon build with the plate growth the wide sweep actually re
- ~~rejected pre-flight (arm tongue bolts miss the main plate)~~ — Every past tough-material pivot bundled the switch with either the elite's minimal-margin short-arm geometry (and failed deflection checks) or a maximalist every-lever-up build (and lost to combined mass), so this pairs ASA's stress headroom with a genuinely opened symmetric sweep for real rotor-wake separation and the plate growth it needs, while keeping arm length short and wedge at zero to isol

## generation 45 (pivot)
*model: claude-haiku-4-5-20251001, claude-sonnet-5*
- `f7d5fe1f41a0` — Every elite is built on floor-mass PA12-CF short arms with zero battery wedge, and storm is stuck at 4.63-4.64 across the entire family; this abandons that trait entirely for carbon (no printed-material thickness floor) at true stock sweep/plate scale with real width/waist/thickness stiffness margin, generous deck_gap for wedge clearance, and a moderate 10deg wedge to finally cut frontal area on a
- `052b89f9a696` — PETG has never been validly flown (every prior attempt used a different tough material or insufficient stiffness margin and hit arm tip deflection), and max battery wedge has never been paired with a genuinely reinforced arm cross-section at safe stock geometry; this isolates full 15deg wedge frontal-area cut with PETG at true stock sweep/plate scale, thick arm shafts and above-floor plate thickne
- `a8588e061d40` — Every decoupled-sweep pivot so far only opened the rear for prop-wash separation; this instead widens only the front sweep (for better front-rotor separation against gusts/crosswind) while holding rear near stock, pairs it with carbon so plate/arm mass stays low despite the much larger plate growth (1.25/1.18, well beyond the 1.13/1.12 that already failed on tongue bolts at a smaller sweep offset)
- ~~rejected pre-flight (plates too thin for cf_plate (1.0 < 1.2 mm))~~ — Every carbon test so far only partially escaped PA12-CF's forced 0.8 thickness floor (stopping at plate=0.62/arm=0.0038, losing by 0.08), so this pushes plate_thickness_scale and arm_thickness all the way to their true carbon-enabled floor at the identical validated elite geometry, to see if the full stiffness-per-mass advantage finally overtakes the printed-material plateau -- since storm is batt
- ~~rejected pre-flight (rotor too close to deck/battery)~~ — Deck_gap has only ever been tested at its maximum (bundled with minimum arm width) or left at the elite's ~0.0385 -- reducing the standoff length alone, isolated on the exact validated elite geometry, cuts hardware mass through a completely untested lever rather than another arm/material/sweep tweak, while staying comfortably clear of both the FC-stack and rotor-clearance failure floors.
- ~~rejected pre-flight (arm tongue bolts miss the main plate)~~ — Every past rear-sweep-opening attempt (for better rear-rotor prop-wash separation) paid the plate-growth mass tax on top of PA12-CF's forced 0.8 thickness floor and lost; carbon has no such floor, so this pairs the same rear-sweep opening (+4.5 deg past the elite, held safely by growing plate_length/width to 1.13/1.12) with carbon at only a moderate thickness cut, isolating whether removing the pr

## generation 46 (pivot)
*model: claude-haiku-4-5-20251001, claude-sonnet-5*
- `c74adfc408f7` — Every past wide-sweep test paired the extra rotor separation with either long arms or insufficient plate growth and lost; this keeps the elite's short, floor-mass wheelbase (0.80) but genuinely opens both front and rear sweep together (43/50, well past the elite's 35.5/42.7) with carbon and plate scales grown to the proven-safe 1.28/1.22 to test whether storm-scenario prop-wash separation pays off
- `eaa63dd47dd7` — PET-CF has only ever been tried with insufficient margin and failed on arm tip deflection every time -- this transplants the exact proven PA12-CF floor-mass elite geometry to PET-CF with a genuine stiffness margin (arm_thickness 0.0048, plate_thickness_scale 0.85, both above the printed-material floor) to test whether this untested material family beats PA12-CF's density/stiffness trade at the sam
- ~~rejected pre-flight (arm tongue bolts miss the main plate)~~ — Every prior pivot kept arm_length_scale at or above the elite's 0.79-0.81 mass floor -- this pushes genuinely below it (0.78) paired with carbon's floor-free thinness (plate 0.60, no printed-material 0.8 tax) to test whether an even lower wheelbase/mass regime pays off, with a small sweep bump (37/43.5) purely for rotor-tip clearance safety at the shorter arm.
- ~~rejected pre-flight (rotor too close to deck/battery)~~ — Same narrow-arm carbon isolation as the failed vector (0.78 length, 0.7 width, 0.55 waist, 37/43.5 sweep) but with plate_length_scale/plate_width_scale grown to 1.10/1.08 (per the ~0.1-per-5deg coupling rule) so the tongue bolts land back on the main plate instead of missing its edge.

## generation 46 (pivot)
*model: claude-haiku-4-5-20251001, claude-sonnet-5*
- ~~rejected pre-flight (plate web too thin (plate_main 1.43 mm, stock 1.90 mm))~~ — Every pa12_cf elite sits at the forced 0.8 printed-material thickness floor while the one carbon variant tried (g42 95e92047, 6.104) only pushed plate_thickness_scale to 0.62 and kept the elite's 1.03/1.01 plate footprint -- this pushes carbon further along its own (unfloored) thickness axis and shrinks the plate footprint toward the 0.95 web-crush limit, since carbon needs neither the print floor
- ~~rejected pre-flight (plates too thin for cf_plate (1.1 < 1.2 mm))~~ — Every long-arm pivot so far went to extreme arm_length_scale (1.1-1.22) and paid a heavy mass tax that lost badly; this instead tests a genuinely moderate disk-loading cut (1.00) at true stock sweep (avoiding tongue-bolt risk and extra plate growth) with carbon's unfloored thin plates, to see if a smaller, cheaper step toward lower disk loading can finally out-trade the short-arm floor-mass family
- ~~rejected pre-flight (arm tongue bolts miss the main plate)~~ — Decoupled rear-sweep widening for prop-wash separation has only ever been tested at a modest +3 deg past the elite (ba333594, 6.195) and always with a printed material paying the thickness-floor tax; this opens the rear sweep much further (50 deg, +14 past true stock) while holding front near stock, grows the plates enough to keep tongue bolts seated, and uses carbon to absorb that extra plate mas
- ~~rejected pre-flight (rotor disks overlap (tip clearance))~~ — Every past pure-stiffness isolation either bundled thin/narrow arms with max thickness (triggering resonance) or paired real width/waist margin with long arms and wedge (mass tax); this isolates a moderate width/waist/thickness stiffness bump (0.90/0.85/0.0055) on carbon at near-stock short arms and stock-adjacent sweep (34/40, untouched plate scale) to test whether arm stiffness alone -- without 
- ~~rejected pre-flight (rotor disks overlap (tip clearance))~~ — Every past wedge+narrow-width combo paired it with longer arms or a printed-material mass floor and lost; this pairs max battery wedge (15deg, frontal-area cut) with a genuinely narrow arm (0.65 width) at the elite's floor-mass short-arm length and true stock sweep, using carbon with high waist retention (0.90) and a thicker shaft (0.006) to supply the stiffness margin narrow arms need without a m
- ~~rejected pre-flight (rotor disks overlap (tip clearance))~~ — The one prior asymmetric-sweep pivot that opened the rear sweep with adequately scaled plates (1.28/1.20) scored 6.441 but ran on a printed-mass-floor material; this repeats a properly scaled rear-only sweep opening (32/48, plate 1.22/1.15 per the +0.1-per-5-deg rule) on carbon instead, testing whether shedding the printed-material mass floor finally lets genuine rear-rotor separation pay off for 

## generation 47 (pivot)
*model: claude-haiku-4-5-20251001, claude-sonnet-5*
- `ba60c54f7292` — Every long-arm pivot so far paired moderate arm length with either extra stiffness overhead or a wedge confound and lost; this pushes arm length near its max for genuinely low disk loading, opens both sweeps for real rotor separation against storm gusts, and uses carbon (no printed-material thickness floor) with proportionally grown plates so the swept tongue bolts stay seated.
- `30ebf3478949` — Every ASA/PETG attempt used minimal stiffness margin at floor mass and failed on arm-tip deflection before the aero benefit could even be assessed, and every max-wedge test bundled it with long arms or narrow sweep changes; this isolates the full 15deg wedge frontal-area cut on ASA at moderate stock-ish geometry with genuine (not floor) width/thickness margin so the material can actually survive t
- ~~rejected pre-flight (plate web too thin (plate_main 1.43 mm, stock 1.90 mm))~~ — Every elite narrows the arm waist hard (~0.56) for mid-shaft drag cut with stiffness held at the ends; this instead goes to floor arm length with an even narrower width but an inverted, nearly-uncinched waist (stiffness distributed through the mid-shaft rather than tapered) on PET-CF, a printed material never tested at this floor-mass short-arm geometry.
- ~~rejected pre-flight (rotor disks overlap (tip clearance))~~ — Same pivot intent (floor-width, waist-stiffened arm paired with pet_cf near stock sweep) but with plate_length/width_scale raised from 0.97 to 1.05/1.04 so the pinned FC-stack holes leave a thick-enough main-plate web this time, since 0.97 crushed it to 1.43 mm against the 1.90 mm stock target.

## generation 48 (pivot)
*model: claude-haiku-4-5-20251001, claude-sonnet-5*
- `79ec1e75661b` — The entire elite family is floor-mass PA12-CF at short arms with minimal stiffness margin and storm is stuck at 4.62-4.64 across all of them; this abandons that trait for carbon (no printed-material thickness floor) at genuinely long arms with real width/thickness stiffness margin instead of a thickness-floor minimum, and holds sweep close to stock with zero wedge so long-arm disk-loading reductio
- `b799a97f0f2e` — Full battery wedge for frontal-area cut has only ever been validly flown on floor-margin printed materials that then failed arm tip deflection, or bundled with long arms/sweep changes; this pairs the full 15 deg wedge with carbon (dodging the printed-material thickness floor) and genuine, not minimal, arm/plate stiffness margin at near-stock sweep so the frame can actually survive long enough to t
- `f947db579640` — Same wide-arm/thick-shaft storm-hardened carbon build as the failed attempt, but with reduced sweep offsets (38/45 instead of 41/49) and correspondingly larger plate scales (1.2/1.18 instead of 1.15/1.15) so the swept tongue bolts stay seated on the main plate per the offset-to-plate-growth coupling.
- ~~rejected pre-flight (arm tongue bolts miss the main plate)~~ — Past decoupled-sweep pivots only ever opened one side while holding the other near stock; this opens both front and rear sweep well past stock together for genuine rotor-wash separation against storm gusts, grows the plates enough (1.15/1.15, beyond the ~0.1-per-5deg rule) to keep the tongue bolts seated at this much larger offset, and uses carbon plus a narrow low-waist arm cross-section to avoid

## generation 49 (pivot)
*model: claude-haiku-4-5-20251001, claude-sonnet-5*
- `83c3edff6103` — The entire elite family is PA12-CF held right at the printed-material thickness floor with minimal stiffness margin, so mass is already at its practical minimum for that material and storm sits flat at 4.62 regardless of small gene tweaks; this pivots to PET-CF (never validly flown per the failure histogram) at genuine, not floor, stiffness margin with true stock sweep and moderate arm length, iso
- `b5073af91061` — The rear-sweep-opening pivot failed prescreen because rear sweep 50deg (+14 past the 36deg stock reference) was paired with only 1.16/1.05 plate growth -- well under the ~0.1-per-5deg rule for a 14deg offset -- so this keeps the same storm-gust rear-separation idea but grows plate_length_scale/plate_width_scale to 1.28/1.18 to keep the tongue bolts seated, lengthens the arm to 1.05 (rather than sh
- `98d59d775c85` — The wide-arm/narrow-waist storm-hardened build failed prescreen on rotor disk overlap because it stacked short arm_length_scale (0.85) with max width (1.15) and an aggressive waist cut (0.45) at narrow sweep, so this keeps the genuinely-wide, real-stiffness ASA arm concept but lengthens the arm to 1.1 for disk clearance, eases width/waist to 1.05/0.6, and holds both sweeps near stock so no plate-s
- ~~rejected pre-flight (arm tongue bolts miss the main plate)~~ — Every past sweep pivot opened front and rear together, conflating cruise-drag effects with storm-specific rotor wake interactions; this decouples them by holding front sweep at true stock (for calm/headwind/thin-air efficiency) while opening only the rear to 50deg for rear-rotor wake separation in storm gusts, at moderate (not floor) PA12-CF stiffness margin with plate scales grown proportionally 
- ~~rejected pre-flight (rotor disks overlap (tip clearance))~~ — The elite arm cross-section is a uniform moderate width with moderate waist narrowing; no design has tested an hourglass shape -- a wide root for bolt/stiffness margin paired with an aggressively pinched mid-shaft waist for drag -- combined with a material tough enough (ASA) to carry it at genuine, non-floor margin, so this isolates that arm-shape axis at true stock sweep and zero wedge.

## generation 50 (pivot)
*model: claude-haiku-4-5-20251001, claude-sonnet-5*
- ~~rejected pre-flight (rotor disks overlap (tip clearance))~~ — Every ASA attempt so far bundled it with an extreme confound (full wedge, max width, or thickness-only isolation) and failed arm-tip deflection before the material's aero/mass benefit could be judged, so this flies ASA at short elite-like arms and near-stock sweep with genuine (not floor, not extreme) width/thickness margin and zero wedge to finally get a clean, valid read on whether ASA can compe
- ~~rejected pre-flight (plate web too thin (plate_main 1.08 mm, stock 1.90 mm))~~ — Deck_gap has sat frozen near 0.039 across every elite and every past proposal despite a 0.02-0.045 range, and plate aspect ratio has only ever been scaled symmetrically, so this holds the proven pa12_cf floor-mass short-arm geometry fixed but pushes deck_gap to near-max for prop-deck clearance and narrows plate_width_scale to its enforced floor (0.95) for a slimmer deck cross-section, isolating tw
- ~~rejected pre-flight (rotor disks overlap (tip clearance))~~ — Every carbon pivot so far either scraped floor thickness at elite-length arms (lost to under-margin, 6.10) or paired carbon's mass freedom with genuinely long arms that got progressively worse the longer they got (6.24 to 7.27 as length rose), so this tests the untried middle: carbon at arms shorter than the current elite with real, non-floor width/thickness stiffness margin and sweep pulled back 
- ~~rejected pre-flight (plates too thin for cf_plate (1.1 < 1.2 mm))~~ — The whole elite family (and every failed pivot) treated storm as the thing to harden against via extra mass/stiffness, but storm is pack-limited so frame changes barely move it -- this instead doubles down on the opposite, untried direction: push arm_length_scale to the short end (0.76, below the elite's 0.80) with carbon (no printed-material thickness floor) so both arm and plate mass fall well p
- ~~rejected pre-flight (rotor disks overlap (tip clearance))~~ — PET-CF at genuine (not floor) stiffness margin and true stock sweep was the closest a pivot has come to the PA12-CF elite (6.402), but it has never been paired with battery wedge; since storm won't punish the frontal-area cut and every past wedge test was confounded with carbon/ASA/long-arm changes, this isolates a moderate 6deg wedge on that near-miss recipe to see if it closes the gap on cold_he
- ~~rejected pre-flight (arm tongue bolts miss the main plate)~~ — Past sweep pivots always opened only one sweep or bundled both-open with a carbon/long-arm mass confound and lost by 800+; this isolates a genuinely opened front+rear sweep (40/48 vs the elite's 35.3/42.5) at the proven floor-mass PA12-CF geometry with plate scales grown per the offset-to-plate-growth rule, testing whether the wider prop-wash separation and smaller crosswind side-profile pay off o

## generation 51 (pivot)
*model: claude-haiku-4-5-20251001, claude-sonnet-5*
- `8b0b576d82a5` — Every long-arm pivot so far (g43/g44/g47/g48) switched to carbon to dodge the printed-material thickness floor and still lost by 0.2-1.3 Wh/km-agg, which points at carbon itself -- not the disk-loading lever -- as the losing variable, so this tests genuinely long arms (1.10, well beyond elite's 0.80) for lower induced power on PA12-CF, the material that's actually winning, with a moderate width/th
- `4981aebc08f0` — Both prescreen failures held arm_length_scale at the floor-mass 0.8 elite value while perturbing width/waist/sweep, so this pivots to genuinely long carbon arms (1.2, well clear of any tip-overlap margin) at true stock-ish sweep and zero wedge to isolate whether lower disk loading alone -- with no printed-material thickness floor -- beats the plateaued short-arm family.
- `ec33a483fc3f` — The failed batch tried sweep/width tweaks at short 0.8 arms and clipped rotor tip clearance, so this instead lengthens the arms to 1.05 for real radial margin while genuinely opening both sweeps for storm-gust rotor separation, growing plate_length/width by ~0.22 per the offset-to-plate-growth rule so the swept tongue bolts stay seated, on never-validly-flown PET-CF at real stiffness margin.
- ~~rejected pre-flight (rotor disks overlap (tip clearance))~~ — Storm is pack-limited (flat 4.60-4.64 across the entire elite family regardless of stiffness tweaks), so mass/drag cuts on the other five scenarios are the real lever, and no prior test has cleanly isolated a real drag-focused narrow arm from a stiffness confound: the one min-width+max-thickness attempt also minimized waist and hit rotor-1P resonance, so this keeps PA12-CF and near-stock sweep but
- ~~rejected pre-flight (rotor disks overlap (tip clearance))~~ — Every battery-wedge test has bundled the tilt with a material switch or long-arm/wide-sweep change and failed either structurally or on fitness, so no one has cleanly isolated a modest (not max) wedge plus a real opened front sweep for prop-wash separation against gusts on the proven-safe PA12-CF short-arm geometry, and since storm won't move much regardless (pack-limited), this bets the frontal-a

## generation 52 (pivot)
*model: claude-haiku-4-5-20251001, claude-sonnet-5*
- `e44921a649f0` — PLA+ has only ever been flown once (at insufficient margin, failing arm tip deflection) and never isolated with real stiffness margin, so this pairs it with a thick low-taper arm cross-section (0.9 waist = minimal narrowing, 0.0065 thickness) at moderate length and true stock-ish sweep/plate scale to test whether the material itself -- not just PA12-CF's floor-mass recipe -- can survive and compet
- `1633db9fe7be` — Every prior max-wedge attempt on ASA/PETG/PLA+ carried insufficient arm margin and failed on tip deflection before the frontal-area benefit could even be measured; this stacks near-max wedge (14deg) with a deliberately over-built ASA arm (1.1 width, 0.9 waist, 0.008 thickness -- well past anything previously tried) at true stock sweep/plate scale so no other confound can explain a loss if wedge st
- ~~rejected pre-flight (plate web too thin (plate_main 1.43 mm, stock 1.90 mm))~~ — Every elite and every pivot has sat deck_gap near its max (~0.039) for stack clearance and never tested the low end; this pairs a near-floor deck_gap (0.025, minimal standoff/prop-wash coupling in storm) with a genuinely narrow, thickness-compensated PA12-CF arm cross-section (0.65 width, 0.007 thickness) for a small-profile crosswind/gust build, isolating the deck_gap variable on the one material
- ~~rejected pre-flight (rotor too close to deck/battery)~~ — Same short-arm narrow-cross-section carbon-adjacent PA12-CF concept that failed only on plate_main web thickness at 0.97 plate scale (below the safe margin above the pinned FC-stack holes), so this keeps every other gene identical and simply raises plate_length_scale/plate_width_scale to 1.05/1.04 to restore adequate web material around the pinned holes.

## generation 53 (pivot)
*model: claude-haiku-4-5-20251001, claude-sonnet-5*
- `4157bc775f7f` — Storm is pack-limited for every frame in this family so the entire plateau is the mean of the other five scenarios at PA12-CF's forced 1.6mm plate floor; this keeps the elite's exact winning short-arm/stock-sweep geometry but switches to carbon (no printed-material thickness floor) with plate_thickness_scale pushed to 0.60, a genuinely unexplored sub-floor mass region since every past carbon attem
- `a83de3206020` — Every past battery-wedge test used either the extreme 15deg (which repeatedly failed on arm tip deflection) or bundled the wedge with long arms/sweep confounds, so this isolates a moderate 7deg wedge for real frontal-area cut on cold_headwind/crosswind, paired with carbon (dodging the printed floor) and a modest thickness/margin bump plus slightly longer arm to keep tip deflection safe under the a
- `776438abb5f9` — The one isolated stiffness pivot that failed did so on arm resonance with rotor 1P (short arm + min width + max thickness), not deflection, so this tests further arm narrowing for drag/mass on the winning PA12-CF short-arm family but lengthens the arm to 0.95 to shift the natural frequency away from that resonance point while holding sweep, plates, and material at the elite family's proven values 
- ~~rejected pre-flight (rotor disks overlap (tip clearance))~~ — Every carbon pivot so far bundled it with long arms or wedge and lost by 0.6-1.3 Wh/km-agg, while deck_gap has sat parked near its 0.039 max untested near the floor across the entire elite family; this isolates carbon's mass benefit at the proven short-arm/stock-sweep geometry with deck_gap cut to 0.027 (well clear of the 0.023 stack-collision floor) and thinner plates (no printed-material floor),
- ~~rejected pre-flight (rotor disks overlap (tip clearance))~~ — Every past width/waist cut on the winning PA12-CF short-arm recipe stayed near the elite's 0.78-0.83 width because narrower arms risked tip deflection; this pushes width down to near-floor 0.60 for a genuine frontal-area cut and moves the stiffness reserve into the plates (1.15x, well above elite's 0.80x) instead of the arm, testing whether trading plate mass for arm drag reduction beats the untou
- ~~rejected pre-flight (rotor disks overlap (tip clearance))~~ — PETG has only ever been tested with insufficient stiffness margin (failing arm tip deflection) or bundled with a wedge/sweep confound; this pairs it with the exact short-arm, stock-sweep geometry that wins for PA12-CF plus genuine (not floor) width/thickness margin, isolating whether the material itself competes once it's actually allowed to fly.

## generation 53 (pivot)
*model: claude-haiku-4-5-20251001, claude-sonnet-5*
- `5780394b9274` — Carbon has been tested many times but always bundled with long arms, max wedge, or opened sweep, so it has never been isolated at the exact geometry that is actually winning (short 0.80 arm, narrow 0.78/0.56 width/waist, near-zero wedge, near-stock sweep); this transplants the winning PA12-CF recipe onto cf_plate unchanged except for exploiting carbon's freedom from the 0.8 printed-material thickn
- `8d850bc7ddca` — The one clean PA12-CF long-arm attempt (g51, 1.10 scale) failed on arm tip deflection from insufficient stiffness margin, and every other long-arm test switched to carbon to dodge the thickness floor and lost by 0.5-1.3 Wh/km-agg anyway, so material was never cleared as the losing variable; this pairs a moderate-long arm (1.05, well short of the failed 1.10) with genuinely reinforced width/waist/t
- `e83b6dd5a943` — The prescreen failure was caused by the reduced arm_length_scale (0.76, below the elite's 0.797) creating rotor tip overlap, not by the deck_gap push -- so this restores the exact elite arm_length_scale while keeping deck_gap at its 0.045 max to still test whether the current winning family has unexploited standoff headroom.
- ~~rejected pre-flight (rotor disks overlap (tip clearance))~~ — Across the top 5 elites deck_gap has crept up from 0.039 to 0.0398 (within 0.005 of the 0.045 max) while arm_length_scale sits flat at 0.797-0.799, only 0.047 above the 0.75 floor -- both untested at their true extreme within the actual winning PA12-CF recipe (every prior arm-length push toward either bound bundled in a material or wedge change that independently lost), so this holds the elite's w

## generation 54 (pivot)
*model: claude-haiku-4-5-20251001, claude-sonnet-5*
- `6cac436f3769` — The elite family is pinned simultaneously against the rotor-overlap arm-length floor, the web-crush plate-scale floor, and the printed-material thickness floor, but arm_width_scale sits at 0.78 while its bound is 0.55 and no earlier proposal isolated a width cut in this exact winning geometry, so this pushes width down to 0.62 with waist relief and added thickness as compensating stiffness margin 
- `345feac125e3` — The long-arm carbon build for lower disk loading failed because its 7deg rear-sweep offset from stock outgrew the unchanged 1.0 plate scale and dropped the tongue bolts off the plate, so this keeps the same long-arm/opened-sweep concept but grows plate_length_scale/plate_width_scale to 1.12/1.10 per the offset-to-plate-growth rule to keep the bolts seated.
- ~~rejected pre-flight (plate web too thin (plate_main 1.07 mm, stock 1.90 mm))~~ — Every sweep experiment on record has only widened the arms outward from stock (31.4/36.0) and lost, but nobody has tried narrowing below stock toward the true minimums (30/34), which per the known coupling is only dangerous with wide arms -- so this pairs near-minimum sweeps with the winning family's narrow arm cross-section (avoiding the tongue-collision failure mode) and lets plate scales shrink
- ~~rejected pre-flight (arm tongue bolts miss the main plate)~~ — Every prior long-arm pivot for lower disk loading paired the extra length with either a wide/thick-margin cross-section (adding mass back) or insufficient stiffness on PA12-CF and failed deflection, so this tests a genuinely narrow arm cross-section at long length (1.15) on carbon plate -- which has no thickness floor and better stiffness-to-mass, letting the reinforcement needed for tip deflectio
- ~~rejected pre-flight (arm root tongues collide on the main plate)~~ — The short/narrow-arm, near-stock-sweep recipe crushed the main-plate web at exactly the 0.95 plate-scale boundary even with the printed-material thickness floor, so this keeps the identical short-arm/narrow-width/small-wedge PA12-CF concept but raises plate_length_scale/plate_width_scale to 1.0 and plate_thickness_scale to 0.85 for real web margin.

## generation 55 (pivot)
*model: claude-haiku-4-5-20251001, claude-sonnet-5*
- `b8d03e1498b5` — Storm sits pack-limited and flat (4.59-4.60) across the entire elite family, so remaining gains must come from cutting the other five scenarios' drag rather than mass, and battery_wedge_deg is an almost entirely unexploited gene bound (elite sits at 0.23-0.35 of a 0-15 range) that was never cleanly tested on the exact winning short-arm PA12-CF geometry (every prior wedge test bundled it with a wea
- `34b022298ce5` — Every elite and nearly every prior pivot has stiffened the arm the same way -- moderate thickness plus a strong mid-shaft taper (waist ~0.55) -- and mass has stalled at the 65g floor for that recipe; this abandons the taper strategy entirely for a thin, narrow, untapered shaft (waist pushed to 0.95, near no narrowing) that relies on constant cross-section rather than thickness or taper for stiffne
- `75e5d886f9df` — The one prior width-cut attempt (g54, width 0.62) changed width, waist, and thickness together and lost, so the width-vs-drag trade was never isolated; this holds arm_length, waist, sweep, plate scale, deck_gap, wedge, and material exactly at elite values and changes only width (down to 0.60, well below elite's 0.77) paired with a large thickness increase (0.0062) as pure cross-section stiffness c

## generation 56 (pivot)
*model: claude-haiku-4-5-20251001, claude-sonnet-5*
- `5ed32770104b` — Every stiffening attempt so far leaned on mid-shaft taper plus thickness and the one no-taper test (g55) failed tip deflection because it didn't compensate with real width, so this pivots to a wide, untapered 'ribbon' arm (width pushed to 1.20, waist relieved to 1.05 for near-constant cross-section) carrying stiffness through width instead of thickness, letting arm_thickness drop to 0.0030 while k
- `d3f2fb06f1ad` — Every prior carbon test just transplanted the pa12_cf floor-thickness recipe onto carbon and lost by a wide margin, never exploiting carbon's actual two advantages -- no printed-material thickness floor and a better stiffness-to-weight ratio -- so this pivots to genuinely thin (0.0026 m) carbon arms near the true minimum, aggressively tapered (waist 0.45) with moderate width (0.95) for root streng
- `f8b8a58e8a20` — The failed vector was the current top elite's exact geometry with deck_gap cut to 0.027, which put the rotor disk too close to the deck/battery stack; restoring deck_gap to the elite's proven 0.0381 while keeping every other gene identical removes that single constraint violation without touching the validated aerodynamic/mass tradeoffs.
- ~~rejected pre-flight (rotor too close to deck/battery)~~ — Every deck_gap test so far pushed toward the 0.045 max and lost narrowly (standoff mass/drag with no clearance benefit), but nobody has tested the low side near the hard 0.023 FC-stack floor, so this clones the top elite exactly and cuts deck_gap to 0.027 to bank the standoff-mass savings that direction was never actually checked for.

## generation 57 (pivot)
*model: claude-haiku-4-5-20251001, claude-sonnet-5*
- `dd8058c94bc8` — Every prior sweep-opening test bundled it with longer arms and lost, so sweep was never isolated on the actual winning short-arm geometry; this holds arm_length/width/waist/thickness/material/deck_gap/wedge exactly at elite values and opens front/rear sweep to 42/48 deg (offsets of +10.6/+12 from stock) with plate_length/width grown to 1.22/1.24 per the offset-to-plate-growth rule, testing whether
- `d5b8430e6524` — arm_waist_scale has sat frozen at ~0.556 across every elite for the entire plateau despite a floor of 0.4, meaning the mid-shaft taper lever was never actually pushed -- this keeps the exact winning PA12-CF short-arm geometry unchanged except deepening the waist cut to 0.42 (near its bound) with a compensating thickness bump to 0.0050 to hold stiffness margin, isolating unexploited drag headroom r
- `de6b8ddc7117` — The failure was rotor-disk tip overlap from pairing near-stock arm_length_scale (0.8) with a wide, untapered arm (width 1.0, waist 0.75) that pushes prop tips outward without added radial reach, so this keeps the wide/untapered-arm stiffness concept and PETG material but lengthens the arm to 1.0 for genuine tip clearance and nudges rear sweep/plate scale slightly to stay within the offset-to-plate
- ~~rejected pre-flight (rotor disks overlap (tip clearance))~~ — Every material besides PA12-CF has only ever been flown at insufficient stiffness margin (PETG failed tip deflection 8 times) so the material lever itself was never cleared as a loser; this isolates PETG with genuinely reinforced width/waist/thickness (1.0/0.75/0.0058, well past any prior PETG attempt) at the exact winning short-arm length and stock-ish sweep so a loss can only be blamed on the ma

## generation 58 (pivot)
*model: claude-haiku-4-5-20251001, claude-sonnet-5*
- `e09e735ba529` — The winning family has always bought arm stiffness margin by thickening the arm itself while plate_thickness_scale sits pinned at pa12_cf's 0.80 floor with 0.5-1.6 of headroom never touched -- this keeps the exact winning short-arm geometry but shifts the stiffness budget to the deck plates (1.15) so the arm can go thinner (0.0035) with a touch less taper (waist 0.58) for a net mass/drag win untes
- ~~rejected pre-flight (plates too thin for cf_plate (1.1 < 1.2 mm))~~ — Every carbon test so far either transplanted the pa12_cf recipe unchanged (g53, lost by only 0.15) or went to long arms (lost by 0.2-1.3), so carbon's real advantages -- no 1.6mm printed floor and better stiffness-to-weight -- were never used to reoptimize width and thickness together on the SAME short-arm geometry that's winning; this cuts arm width to 0.62, thickness to 0.0030, and plate thickne
- ~~rejected pre-flight (arm tongue bolts miss the main plate)~~ — Every prior sweep pivot opened BOTH sweeps symmetrically and lost, but no one has tried the asymmetric case -- front held near true stock (32deg, minimizing frontal area for headwind/crosswind) while rear is pushed hard toward its 62deg bound for genuine prop-wake separation -- so this tests that untried topology on the winning arm/material recipe with arm length nudged to 0.85 for tip clearance a
- ~~rejected pre-flight (plate web too thin (plate_main 1.43 mm, stock 1.90 mm))~~ — The width-cut-on-carbon test failed only on cf_plate's harder minimum web thickness (1.2mm, not the printed-material 1.6mm floor) at plate_thickness_scale 0.55, so this keeps the aggressive arm_width_scale=0.62 cut and thin carbon plates but raises plate_thickness_scale to 0.65 (1.3mm, clears the cf_plate floor with margin) and nudges plate_length/width to 0.97 to stay off the web-crush floor, iso
- ~~rejected pre-flight (rotor too close to deck/battery)~~ — The rear-sweep-opening vector failed because a 22deg rear offset from stock needed roughly 1.32 plate scale by the offset-to-plate-growth rule but only got 1.18, and sweep-opening has lost every time it's been tried anyway, so this replacement instead isolates deck_gap in the untested downward direction -- holding the exact winning elite geometry fixed and cutting the standoff from 0.038 to 0.027,

## generation 59 (pivot)
*model: claude-haiku-4-5-20251001, claude-sonnet-5*
- `e584eb50dfe2` — Every past width change moved only one direction (down, to 0.60-0.62) and always lost 0.19 Wh/km-agg, while the two attempts to raise width instead confounded it with an untapered waist and extreme 1.2 scale and failed on tip deflection -- this isolates a moderate width increase (0.92, well short of that failed 1.2 extreme) with the elite's own proven taper (waist 0.54) unchanged, using the added 
- `acb487769a3a` — PET-CF has only ever been flown bundled with long arms (g51 1.05 scale, g53 1.05 scale), both of which lost by 0.6-0.7 Wh/km-agg and left material itself unjudged, exactly the confound that cf_plate isolation cleared in g53; this transplants the unchanged winning short-arm pa12_cf recipe onto pet_cf (material 0.40) with plate_thickness_scale held at the elite's already-compliant 0.8238, testing pe
- `939e58c18328` — The rejected carbon-plate design was sound except plate_thickness_scale 0.55 produced 1.1mm webs against carbon's 1.2mm floor, so this raises plate_thickness_scale to 0.65 (real margin above the failing point) while holding every other gene -- including the untested low-taper arm and near-stock sweep -- exactly as designed.
- ~~rejected pre-flight (plates too thin for cf_plate (1.1 < 1.2 mm))~~ — Every carbon test so far varied only one structural axis at a time (g53 transplanted the pa12_cf recipe unchanged and lost 0.13, g56 thinned the arm alone to 0.0026 and closed the gap to 0.08) but none has ever also cut plate_thickness_scale below the 0.8 floor that only printed materials are bound by, leaving cf_plate's second real advantage untouched; this pairs a thin tapered arm (0.0028, waist

## generation 60 (periodic)
*model: claude-haiku-4-5-20251001, claude-sonnet-5*
- `ac35c1dcb265` — Width cuts to 0.60-0.62 always lost on printed materials and the one aggressive width+waist combo on pa12_cf failed tip deflection, but that confound was never isolated on cf_plate, which has a strictly better stiffness-to-weight ratio; this cuts width to 0.65 while relieving the taper (waist 0.60) and adding a modest thickness bump for margin, testing whether carbon alone can survive the narrow-a
- `11a813e12658` — Battery_wedge_deg has sat almost untouched (0.23-0.35 of a 0-15 range) and every prior clean wedge attempt was bundled with a weaker arm or run on pa12_cf, never on the actual current cf_plate champion recipe; this holds the winning geometry exactly and pushes wedge to a moderate 6deg to isolate whether reduced frontal area beats the added CG-shift cost on the family that is actually winning.
- ~~rejected pre-flight (plate web too thin (plate_main 1.25 mm, stock 1.90 mm))~~ — Every sweep test so far opened the angle further from stock and lost; nobody has tried tightening sweep back toward stock on the winning cf_plate geometry, which lets plate_length/width_scale shrink toward the 0.95 crush floor for less material and a smaller side/frontal profile without violating the tongue-bolt-on-plate rule.
- ~~rejected pre-flight (rotor disks overlap (tip clearance))~~ — The failure was a plate_main web crush (1.25mm vs 1.90mm stock) from plate_length/width_scale sitting at/below the 0.95 danger threshold while plate_thickness_scale (0.65) exactly matches the proven top elite -- so this keeps the arm geometry, thickness, sweep, and material unchanged and just grows plate_length_scale/plate_width_scale to 1.00/1.02 (above the elite's own 0.97/1.00) to restore web m

## generation 63 (periodic)
*model: claude-haiku-4-5-20251001, claude-sonnet-5*
- ~~rejected pre-flight (arm tongue bolts miss the main plate)~~ — Every long-arm attempt so far used a printed material (pa12_cf/pet_cf/petg) and failed on tip deflection, or bundled sweep changes that crushed the plate webs, so carbon's actual stiffness-to-weight advantage at lower disk loading has never been cleanly isolated; this stretches the arm to 1.05 with matched width/waist/thickness margin and grown plate scale for tongue safety, testing whether reduce
- ~~rejected pre-flight (plate web too thin (plate_main 1.07 mm, stock 1.90 mm))~~ — The deck-plate mass budget has only ever been probed at the champion's own 0.968/1.0 plate scale and 0.65 thickness, with the one aggressive thickness cut (0.55) failing carbon's ~1.2mm web floor and no test of the untried middle ground; this holds the winning arm geometry exactly and trims plate_width_scale to 0.95 with thickness at 0.60 to see if there is genuine unexploited mass headroom in the
- ~~rejected pre-flight (rotor disks overlap (tip clearance))~~ — Battery_wedge (tested alone at 6deg) and opened front sweep (tested alone at 42deg) both lost individually at full dose, but a moderate combined dose -- a small 3deg wedge plus front sweep pulled toward stock (33.5 vs the elite's 36) to shrink the prop-arc frontal silhouette -- was never tried together, so this isolates whether a lighter combined frontal-area cut beats what the two full-strength s
- ~~rejected pre-flight (plate web too thin (plate_main 1.07 mm, stock 1.90 mm))~~ — The one clean web-crush failure paired plate_width_scale 0.95 with a low plate_thickness_scale (0.6) so the crosswind-favorable narrow-deck idea was never tested with real thickness margin; this keeps the exact winning cf_plate short-arm geometry but narrows plate_width_scale to 0.95 while raising plate_thickness_scale to 0.85 (well above the 0.65 elite and the 0.6 failure point) to shrink side pr
- ~~rejected pre-flight (rotor disks overlap (tip clearance))~~ — Every elite and every prior sweep test has kept or opened the rear sweep further from stock than the front (currently 43.5 vs 36), but since the mission flies north then south the arms alternate which end leads into the wind, so the wide rear sweep pays a structural-mass cost without a matching aerodynamic benefit; this pulls rear_sweep_deg back to 37, near-symmetric with the front, to test whethe
- ~~rejected pre-flight (plates too thin for cf_plate (1.1 < 1.2 mm))~~ — The g59 test proved plate_thickness_scale 0.55 fails web-crush at the elite's ~1.0 plate_width_scale, but no test has compensated for the thinner plate by growing plate_width_scale instead of thickness; this grows plate_length/width_scale to 1.0/1.10 for extra web margin and drops plate_thickness_scale to 0.55 to chase the lowest possible frame mass for the mass-rewarded hot_thin scenario.

## generation 0 (opening)
*model: claude-haiku-4-5-20251001, claude-sonnet-5*
- `3167e5636862` — Wide-sweep PETG storm tank: sweeps pushed ~9-10deg past stock with plates grown to match, wide uniform-thickness arms and no cutouts for max stiffness against gusts.
- `8f6678aeb7c0` — Long, uniform-thickness flex arms on a PLA+ frame with generously scaled plates (1.1) to keep the FC web safe while carrying enough plate thickness for a printed material.
- ~~rejected pre-flight (plate web too thin (plate_main 1.07 mm, stock 1.90 mm))~~ — Stock-sweep carbon-plate baseline: minimal drag and lightening, testing whether carbon's strength-to-weight lets thin plates and moderate arms win outright.
- ~~rejected pre-flight (plate web too thin (plate_main 1.08 mm, stock 1.90 mm))~~ — Long, narrow-waisted carbon glider stretching the wheelbase and slimming the shaft to chase low frontal drag for cold_headwind and low disk loading generally.
- ~~rejected pre-flight (plate web too thin (plate_main 1.07 mm, stock 1.90 mm))~~ — Ultralight PA12-CF hot-and-high build: short thin arms with moderate lightening holes to minimize mass for the thin-air scenario without stacking cutouts on a deep tip dip.
- ~~rejected pre-flight (plate web too thin (plate_main 1.07 mm, stock 1.90 mm))~~ — Compact stiff-waisted PLA+ frame probing a high battery-tilt angle to see whether the frontal-area cost is worth any downstream benefit, isolating the unexplored battery_wedge_deg gene.
- ~~rejected pre-flight (rotor too close to deck/battery)~~ — Near-stock sweeps with plate scales pushed to 1.05 (well above the 0.95 that crushed the FC web) for a stiff, thin carbon-plate speed racer.
- ~~rejected pre-flight (rotor too close to deck/battery)~~ — Wide-sweep low-profile crosswind specialist; sweeps pushed well past stock (front 40, rear 48) so plate scales are grown to near-max (1.3/1.25) to preserve the FC web per the coupling rule.
- ~~rejected pre-flight (rotor disks overlap (tip clearance))~~ — Lightweight hot-thin specialist with thin, cutout-lightened arms but plate scales held at a safe 1.05 and printed-material plate thickness at 0.85 to avoid the prior web-crush failures.

## generation 3 (periodic)
*model: claude-haiku-4-5-20251001, claude-sonnet-5*
- `f5e5015de631` — Push the winning cf_plate recipe further by stretching the wheelbase for lower disk loading, adding root thickness and a shallower mid-shaft dip to keep the longer arm safe, with plates grown slightly beyond the current best to match the small extra sweep.
- `f809db629048` — Stock-geometry PA12-CF compact frame kept intact but with deck_gap raised well past the clearance failure and battery tilt zeroed to free up vertical space under the props.
- ~~rejected pre-flight (rotor too close to deck/battery)~~ — Test a tougher PA12-CF build with a conservative, stout arm (thick root, near-uniform thickness, low cutout, sweeps close to stock) to sidestep the overstress/tip-deflection failures printed materials have hit so far.
- ~~rejected pre-flight (plate web too thin (plate_main 1.25 mm, stock 1.90 mm))~~ — Chase a minimum-mass, low-frontal-area cf_plate design with near-stock sweeps (so plates can stay lean), narrow uniform-thickness arms and a flat battery for crosswind/cold_headwind/hot_thin gains, accepting a possible storm-scenario tradeoff.
- ~~rejected pre-flight (rotor disks overlap (tip clearance))~~ — Minimal-mass cf_plate frame with the same short/narrow arm shape as before, but deck plates grown to 1.08x so the FC-stack web clears the min-thickness check with margin.

## generation 63 (periodic)
*model: claude-haiku-4-5-20251001, claude-sonnet-5*
- `58619732be87` — arm_cutout_scale has sat at 0.0 through the entire cf_plate elite lineage despite carbon's superior stiffness-to-weight ratio giving it the most margin to absorb stress risers, so this adds three moderate lightening holes (0.28, safely below the ~0.4 stress-concentration danger zone) to the exact winning short-arm geometry with a small thickness bump (0.0026->0.0030) for margin, leaving the taper 
- `6a61b37c4864` — tip_thickness_scale has also sat frozen at 1.0 (no mid-shaft dip) through the entire elite lineage even though bending stress is lowest at mid-shaft, so this pushes it to 0.62 to trim mass where it costs least structurally, compensates with a thicker root (0.0026->0.0032) for margin at the tongue/motor-mount stations, and relieves the waist (0.4725->0.65) so the narrowing and thinning levers don't
- `0a85bf0a63b2` — if cutout holes and a mid-shaft taper each cut mass in isolation, combining mild versions of both on the winning geometry should compound the hot_thin/mass gain further than either alone, so this pairs cutout_scale 0.15 with tip_thickness_scale 0.85 (both moderate, not pushed toward their individual extremes) plus a relieved waist (0.55) and a thickness bump (0.0029) specifically to dodge the flag

## generation 65 (pivot)
*model: claude-haiku-4-5-20251001, claude-sonnet-5*
- `40a793713f44` — Every current elite and nearly every prior test relies on the same stiffening trick -- aggressive mid-shaft taper (waist ~0.47-0.60) on a near-floor-thickness shaft -- and every attempt to relax that taper without heavy compensation has failed tip deflection, so this abandons taper entirely (waist 0.95, effectively untapered) and instead buys stiffness from a wider, thicker 'stout beam' cross-sect
- `e8accf0753fd` — The first failure was driven by arm length outgrowing the plate, not sweep (sweep matched the elite's near-stock values) -- this keeps the exact long-arm/lower-disk-loading concept but grows plate_length_scale/plate_width_scale further (to 1.18/1.15, beyond the prior 1.05/1.03) to match arm_length_scale's own offset from stock, not just the sweep offset, so the tongue bolts stay seated.
- ~~rejected pre-flight (arm tongue bolts miss the main plate)~~ — Every prior long-arm attempt confounded arm_length with a simultaneous sweep change and lost (or failed on tongue/plate geometry), so arm_length has never been tested alone as the pivot variable with proper independent stiffness compensation -- this holds sweep exactly at the elite's proven values and isolates a genuine low-disk-loading long-arm region (1.15, well off the short-arm floor the elite
- ~~rejected pre-flight (rotor disks overlap (tip clearance))~~ — Every sweep test so far has moved front and rear together (either near stock or opened together to 42/48, which lost), leaving the asymmetric case totally unexplored even though cold_headwind and crosswind -- the two worst non-storm scenarios -- respond to frontal area and side profile differently, so this pushes front_sweep toward its max (48) to shrink frontal area in headwind while pulling rear
- ~~rejected pre-flight (arm tongue bolts miss the main plate)~~ — The second failure opened front_sweep far from stock (48deg) while rear_sweep sat pinned near its own floor (36deg), collapsing the front-rear angular separation between same-side arms enough to overlap rotor disks even with a short arm; this moderates the sweep split (40/46, keeping both offsets under ~9deg instead of one extreme +16.6deg) and adds arm-length radial margin (0.92 vs 0.85) so reduc

## generation 66 (periodic)
*model: claude-haiku-4-5-20251001, claude-sonnet-5*
- `92aee5230f2c` — Every prior width cut spent its compensation budget on arm thickness or taper and lost, but plate_thickness_scale has 0.5-1.6 of headroom that was only ever tested paired with a weaker pa12_cf arm; this cuts width more aggressively (0.92->0.78) than any surviving test while relieving the taper and instead buying the missing stiffness margin from a real plate_thickness_scale bump (0.66->0.85) on th
- ~~rejected pre-flight (rotor disks overlap (tip clearance))~~ — Every arm_length test has sat at 0.78-0.82 near the floor and shorter arms deflect far less under load (deflection scales with length cubed), so this pushes length to the true floor (0.75) and reallocates that extra stiffness margin into a meaningful width cut (0.92->0.85) that prior width-cut attempts could never afford at longer arm lengths.
- ~~rejected pre-flight (rotor disks overlap (tip clearance))~~ — Every cutout attempt so far (g63) stacked the holes onto the current 0.78-0.82 arm length and lost, but a floor-length 0.75 arm carries much lower bending stress per unit length, so this pairs the untested length floor with a moderate cutout (0.25) and a small thickness/taper relief for margin, testing whether the length-driven stiffness surplus is what was missing for lightening holes to pay off.
- ~~rejected pre-flight (rotor disks overlap (tip clearance))~~ — Both prescreen failures paired the width/cutout experiment with arm_length_scale cut to 0.75, which crosses the tip-clearance line at these sweeps (the top elite itself sits at 0.78 and clears fine); this restores arm_length_scale to the proven 0.78 floor and isolates a moderate width cut (0.85, well short of the 0.60-0.62 values that always failed on printed materials) with waist/cutout held at e
- ~~rejected pre-flight (rotor disks overlap (tip clearance))~~ — Same tip-clearance fix applied to the second failed vector: keep arm_length_scale at the elite's safe 0.78 instead of 0.75, restore width to the elite's proven 0.9211, and relieve the waist slightly (0.50) with a thickness bump (0.0027) to give the 0.25 cutout holes stress margin, isolating whether moderate lightening holes cut mass without the confound of a too-short arm.

## generation 69 (periodic)
*model: claude-haiku-4-5-20251001, claude-sonnet-5*
- `eedcf2616432` — cf_plate's plate_thickness_scale has huge untouched headroom (elite sits at 0.66 of a 1.6 cap) and has never been used to fund BOTH mass-cutting arm levers at once, so this bumps plate_thickness_scale to 1.05 to buy structural margin for a real cutout (0.32) plus a real mid-shaft taper (tip_thickness_scale 0.70) simultaneously, relieving waist to 0.65 so the taper/holes/narrowing don't stack in th
- `001d6d39ba52` — The plate-width shrink failed on web thickness at 0.95, so this replaces it with an orthogonal mass-cut on the exact winning geometry -- moderate lightening holes (cutout 0.18, safely below the ~0.4 stress-riser zone) with a small thickness bump for margin -- while plates stay pinned at the elite's proven 0.9425/0.9959.
- `099a8e466c32` — The prior front-sweep cut to 33deg overlapped rotor disks because the short/wide arm gave no extra radial clearance, so this takes a smaller sweep step (34.5deg) and pairs it with a longer arm (0.85 scale) plus grown plate scales (0.98/1.02) for the tip clearance and tongue-bolt seating that were missing before.
- ~~rejected pre-flight (plate web too thin (plate_main 1.07 mm, stock 1.90 mm))~~ — plate_width_scale has sat pinned near 1.0 through the entire elite lineage despite a legal floor of 0.95 for web integrity, so this cuts it to exactly 0.95 on the unchanged winning geometry to shrink the crosswind side profile -- a plate lever that's never been isolated even though crosswind explicitly rewards a small side profile.
- ~~rejected pre-flight (rotor disks overlap (tip clearance))~~ — every prior sweep test moved sweeps OUTWARD from stock and lost, but no test has isolated moving front_sweep_deg back IN toward stock (31.4) alone while holding rear sweep at its elite value, so this drops front_sweep to 33.0 -- still needing no plate growth since it's moving toward stock, not away -- to test whether a slimmer nose profile cuts cold_headwind drag without the plate/tongue risk that

## generation 72 (periodic)
*model: claude-haiku-4-5-20251001, claude-sonnet-5*
- `7abd5ff3fb98` — Every past cutout/taper combo stacked holes into an already-narrowed waist and lost, so this instead relieves the waist to near-neutral (0.95) and widens the root slightly (1.05) to give the shaft full cross-section margin, letting three moderate lightening holes (0.22) do the mass-cutting work in isolation without compounding stress concentration with a taper.
- `c1f4b5cb356e` — Battery_wedge_deg has only ever been isolated-tested at 6deg on an older, weaker geometry, leaving the 6-15deg band untouched on the actual current champion recipe, so this pushes wedge to 9.5deg on the unchanged winning geometry to see if cutting frontal area for cold_headwind/crosswind now outweighs the CG-shift cost on the family that's actually winning.
- `1f59e66ff16e` — The only deck_gap cut ever tried (0.027) jumped straight past the real boundary and failed on rotor/deck clearance, leaving the whole 0.027-0.037 band unsampled, so this tests a moderate 0.032 on the unchanged winning geometry to find real standoff-mass savings without repeating the known failure point.

## generation 75 (periodic)
*model: claude-haiku-4-5-20251001, claude-sonnet-5*
- `d63f41b20cc5` — Every past cutout test confounded the mass cut by relieving the waist taper (0.55-0.65) as compensation, so the true effect of holes on the actual winning aggressive-taper geometry (waist 0.4452) has never been isolated; this adds a mild cutout (0.12, well below the ~0.4 stress-riser zone) with only a token thickness bump (0.0028) for margin, holding waist, width, sweeps, plates and everything els
- `318f5b17dcdb` — Battery_wedge_deg has only ever been pushed upward from the elite's near-zero value (6deg, 9.5deg), both losing to the CG-shift cost, but the opposite direction -- a fully flat battery -- has never been isolated on the actual winning geometry, so this zeroes wedge while holding every other gene exactly at the elite's values to test whether the small existing tilt is itself a net cost rather than a
- `a979213f29d7` — Arm_thickness has sat pinned at the absolute floor (0.0025) through the entire elite lineage and every attempt to touch it was bundled with waist or width changes that failed for unrelated reasons, so this isolates a modest stiffness bump (0.0025->0.0033) with every other gene held exactly at elite values, testing whether the added storm-scenario stiffness margin outweighs its small mass/hot_thin 

## generation 78 (pivot)
*model: claude-haiku-4-5-20251001, claude-sonnet-5*
- `69d334abfd4a` — Every elite across the last 18 generations has frozen front/rear sweep within a ~1deg band near 37/44deg and every non-sweep lever (waist, width, thickness, cutout, tip-taper, wedge, deck_gap-down) has already been isolated and lost, so this abandons the frozen near-stock sweep entirely for a genuinely wide symmetric DeadCat splay (46/55deg, deep into unsampled territory) with plate_length/width_s
- `6c3742252189` — Every historical deck_gap experiment (0.027 failed on rotor/deck clearance, 0.032 tested worse at 5.787) only ever probed downward from the elite's 0.0315, leaving the entire upper half of the 0.02-0.045 range genuinely untested despite the elite geometry never actually resting against that bound's failure mode in that direction, so this holds the exact current champion recipe fixed and pushes dec
- `052f1fa949b5` — The original wide-sweep pivot failed on rotor tip clearance because a short 0.8-scale arm combined with front sweep pushed to 49deg (17.6deg off stock) left too little radial spacing between prop disks; this fixes it by lengthening the arm to 1.15 for real radial clearance and pulling front sweep back to 40deg (rear to 40deg) so both sweeps sit close to stock while plate scales grow to keep the to
- ~~rejected pre-flight (rotor disks overlap (tip clearance))~~ — Every design ever sampled -- elite or pivot alike -- keeps rear_sweep_deg greater than front_sweep_deg (the conventional DeadCat splay direction), a topology never once inverted in the run's history, so this flips it (front 49deg > rear 38deg) with plate_length/width_scale grown to 1.25/1.2 to keep the far-forward tongues seated, testing whether the opposite front/rear moment-arm and prop-wash dis

## generation 79 (pivot)
*model: claude-haiku-4-5-20251001, claude-sonnet-5*
- ~~rejected pre-flight (plates too thin for cf_plate (1.1 < 1.2 mm))~~ — Genome bounds were widened downward today and the elite family already jumped past the OLD plate_thickness_scale floor (0.7) to sit at 0.60-0.63, but no isolated test has pushed it toward the NEW floor (0.5) on the untouched winning geometry, so this holds every other gene exactly at the top elite's values and drops plate_thickness_scale to 0.53 to claim that unexploited headroom.
- ~~rejected pre-flight (rotor disks overlap (tip clearance))~~ — Every elite for 19 generations buys its stiffness-per-mass from an aggressive mid-shaft taper on a floor-thickness shaft, and the one time taper was abandoned for a stout uniform beam it was bundled with a LONG arm and lost badly (6.415), so this tests the opposite combination never tried: keep the arm at its true floor length (0.75, minimum bending moment) but drop the taper entirely (waist 1.0, 
- ~~rejected pre-flight (plate web too thin (plate_main 1.06 mm, stock 1.90 mm))~~ — Every current elite shares a moderate sweep growth (37/44 vs the real V6's stock 31.4/36.0) paired with plate scales grown to accommodate it, but that combination has never been reverted to pure stock sweep with the freed plate-scale budget reclaimed as mass savings instead, so this holds the winning arm cross-section exactly and pulls both sweeps back to true stock while trimming plate_length_sca
- ~~rejected pre-flight (rotor disks overlap (tip clearance))~~ — arm_length_scale has sat within ~3.7% of its 0.75 floor through the entire elite lineage while every other mass-cutting lever (thickness, cutout, tip-taper) already converged onto its own hard boundary, so this holds the exact winning recipe and drops arm_length_scale to the literal minimum to claim the one remaining unexploited direct mass/moment reduction, isolated from every prior confounded le
- ~~rejected pre-flight (arm tongue bolts miss the main plate)~~ — Every prior long-arm/low-disk-loading attempt (g65 e8accf07, g69 099a8e46, g78 052f1fa9) lost because it bundled the length increase with an under-compensated or unrelieved beam, so this abandons the short-arm family deliberately -- arm_length_scale pushed to 1.15 with width neutralized to 1.0, waist relieved to 0.75, and a real thickness margin (0.0032) to survive the longer beam's higher bending
- ~~rejected pre-flight (arm tongue bolts miss the main plate)~~ — The one wide-sweep pivot that actually survived structurally (g78 69d334ab, 46/55deg) confounded the sweep change with an abandoned taper and lost, so this isolates sweep alone -- keeping the exact proven light structure (short arm, narrow waist, floor thickness, uniform tip) but pushing front/rear sweep further out (43/50deg) than the frozen elite band, with plate_length/width_scale grown to 1.05
