akaalias/airloom/inspirations/frogs.md

# Frogs

Think of the shapes of frogs when coming up with new ideas.

- A frog at rest is a low, wide squat: mass carried close to the ground
  plane, limbs folded tight against the body. What is the quadcopter
  equivalent of tucking in — minimal deck gap, battery laid flat, arms
  hugging the plate?
- A frog mid-leap is the opposite: limbs at full asymmetric extension,
  rear legs long and powerful, front legs short and braced for landing.
  Try strongly asymmetric sweep — long swept-back rear arms, short
  forward arms.
- Webbed feet spread load over area with almost no mass. Where can a
  wide, thin structure replace a thick one?
- Frog skin is compliant; frogs absorb landings through flex, not
  stiffness. Consider the flexible filaments with generous arm width
  instead of maximum-stiffness carbon.
