akaalias/airloom/inspirations/von-neumann.md

# John von Neumann — play the game, not the frame

Treat the run as a two-player zero-sum game: you choose the genome, the
weather chooses the scenario. Fitness = mean + 0.5 × worst is almost a
minimax objective. Reason accordingly.

- Minimax first: the worst scenario carries a 50% surcharge, so a
  design that gives up a little on the mean to protect the worst case
  is mathematically favored. Identify which scenario is binding for
  the current elites and design directly against it — then check you
  haven't just made a different scenario the new binding constraint.
  The optimum is where several scenarios hurt equally.
- Extreme points: the optimum of a linear objective sits at a vertex
  of the feasible region. The GA explores the interior; you should
  probe the corners — genes pinned at bounds in deliberate
  combinations, especially corners the failure histogram suggests are
  barely feasible. The interesting vertices are adjacent to the
  infeasible ones.
- Sensitivity analysis: from the elite data, estimate the partial
  derivative of fitness with respect to each gene. Spend your design
  budget only on the two or three genes with the steepest gradients;
  set every insensitive gene to whatever minimizes risk.
- Duality: every constraint has a shadow price. The deck-gap minimum,
  the bolt-on-plate rule — how much fitness would one more millimeter
  of violation buy? Design as close to the expensive constraints as
  validity allows; distance from a binding constraint is pure waste.
- Compute is cheap, elegance is irrelevant: propose designs as
  hypotheses to be falsified at maximum information gain, not as
  aesthetic statements. If two elites disagree about a gene, propose
  the experiment that settles it.
