akaalias/airloom/docs/leaderboard.md

# Leaderboard — top 10

| rank | hash | gen | operator | material | frame g | agg Wh/km | mean | worst | calm_warm | cold_headwind | storm | crosswind | gusty_light | hot_thin |
|---|---|---|---|---|---|---|---|---|---|---|---|---|---|---|
| 1 | `4553a646ccc2` | 79 | crossover | cf_plate | 55.7 | 5.763 | 3.553 | 4.421 | 3.056 | 3.648 | 4.421 | 3.526 | 3.405 | 3.260 |
| 2 | `a47fba69d402` | 79 | crossover | cf_plate | 55.4 | 5.764 | 3.553 | 4.421 | 3.059 | 3.647 | 4.421 | 3.525 | 3.405 | 3.262 |
| 3 | `222e0e2cc59f` | 79 | pivot | cf_plate | 55.5 | 5.767 | 3.555 | 4.424 | 3.058 | 3.651 | 4.424 | 3.526 | 3.407 | 3.262 |
| 4 | `faeb6f8edb27` | 77 | crossover | cf_plate | 55.6 | 5.767 | 3.555 | 4.423 | 3.062 | 3.651 | 4.423 | 3.525 | 3.407 | 3.264 |
| 5 | `81837e8357bb` | 77 | crossover | cf_plate | 55.6 | 5.767 | 3.556 | 4.424 | 3.060 | 3.649 | 4.424 | 3.528 | 3.408 | 3.264 |
| 6 | `bf7d9ddf87f6` | 78 | crossover | cf_plate | 55.5 | 5.768 | 3.555 | 4.425 | 3.059 | 3.651 | 4.425 | 3.527 | 3.408 | 3.262 |
| 7 | `6c1c1963d383` | 76 | crossover | cf_plate | 55.5 | 5.768 | 3.556 | 4.425 | 3.059 | 3.651 | 4.425 | 3.528 | 3.408 | 3.263 |
| 8 | `bd90782a3b54` | 76 | crossover | cf_plate | 55.0 | 5.769 | 3.556 | 4.424 | 3.062 | 3.650 | 4.424 | 3.529 | 3.409 | 3.264 |
| 9 | `520b5f07c877` | 79 | crossover | cf_plate | 55.5 | 5.769 | 3.556 | 4.426 | 3.059 | 3.652 | 4.426 | 3.528 | 3.408 | 3.263 |
| 10 | `3ea600b4fceb` | 75 | crossover | cf_plate | 55.7 | 5.769 | 3.556 | 4.425 | 3.062 | 3.652 | 4.425 | 3.526 | 3.408 | 3.265 |
