akaalias/airloom/docs/convergence.png

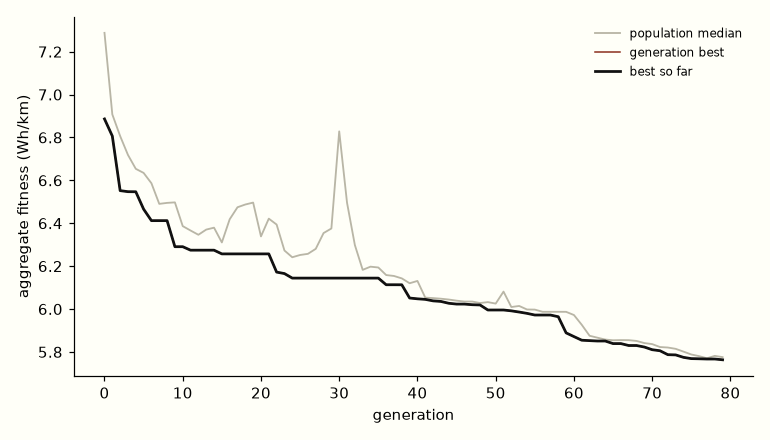
docs/convergence.png
