akaalias/airloom/docs/frames/gen_0000/7792e42599f3_bottom.png

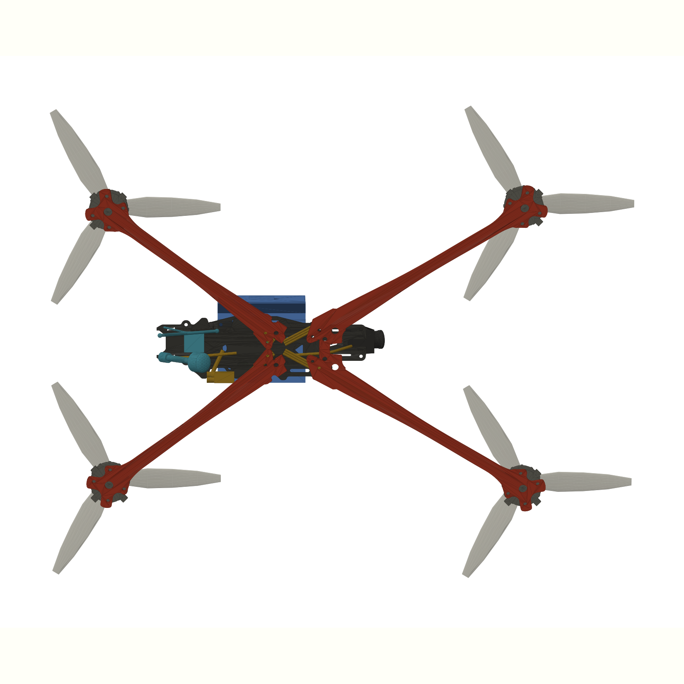
docs/frames/gen_0000/7792e42599f3_bottom.png
