akaalias/airloom/docs/frames/gen_0000/ac6152897717_bottom.png

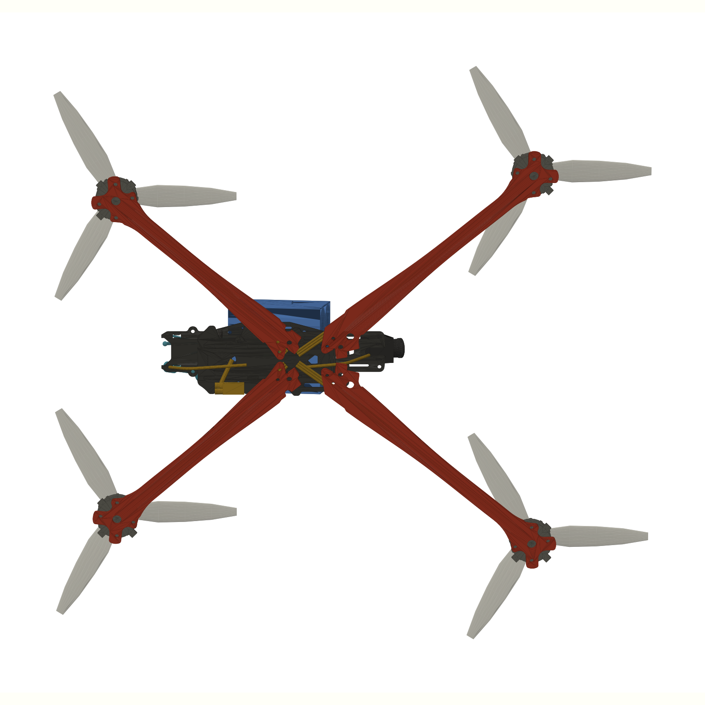
docs/frames/gen_0000/ac6152897717_bottom.png
