akaalias/airloom/docs/frames/gen_0001/8647cb40064a_bottom.png

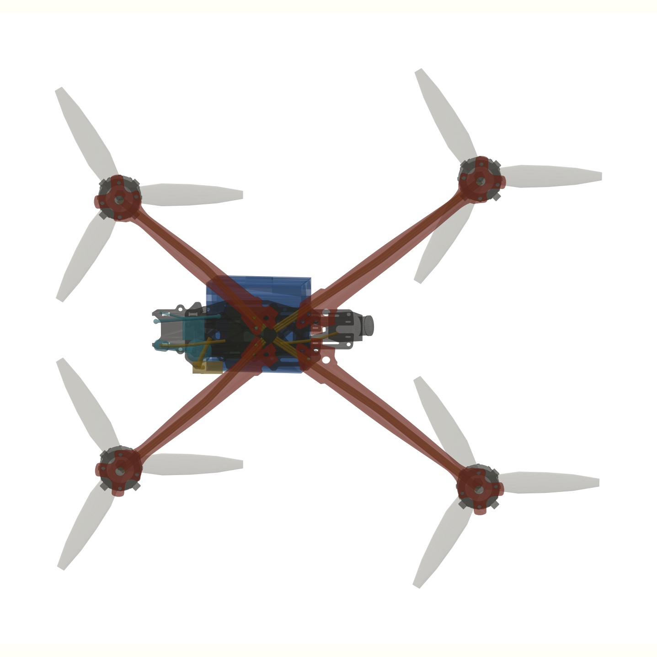
docs/frames/gen_0001/8647cb40064a_bottom.png
