akaalias/airloom/docs/frames/gen_0001/4775089f5490.png

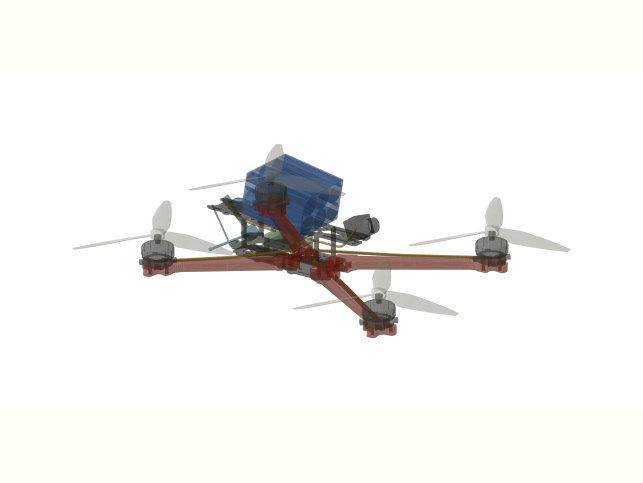
docs/frames/gen_0001/4775089f5490.png
