akaalias/airloom/docs/frames/gen_0002/5ed287457f78_bottom.png

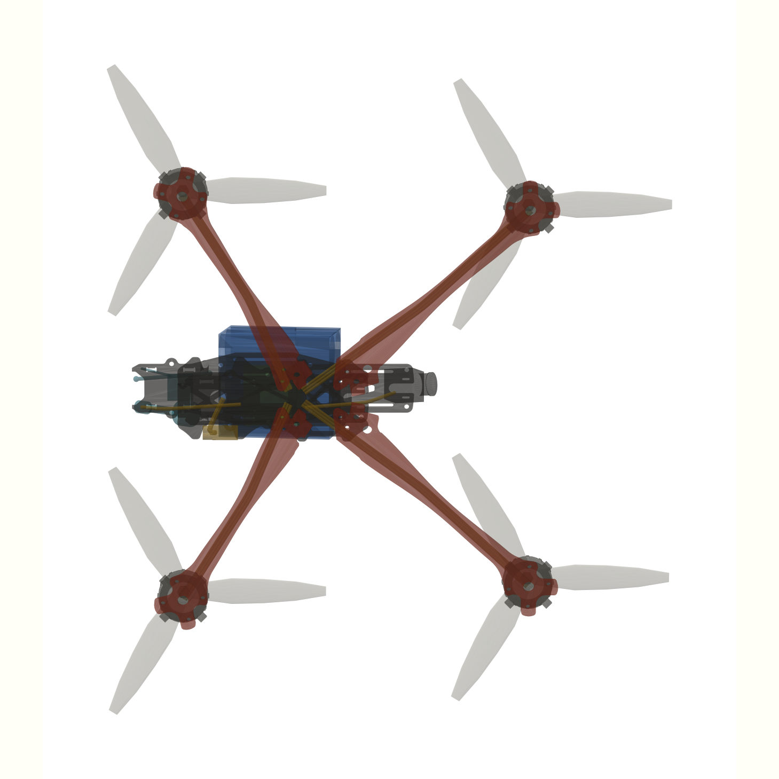
docs/frames/gen_0002/5ed287457f78_bottom.png
