akaalias/airloom/docs/frames/gen_0003/3edb9219bf87_bottom.png

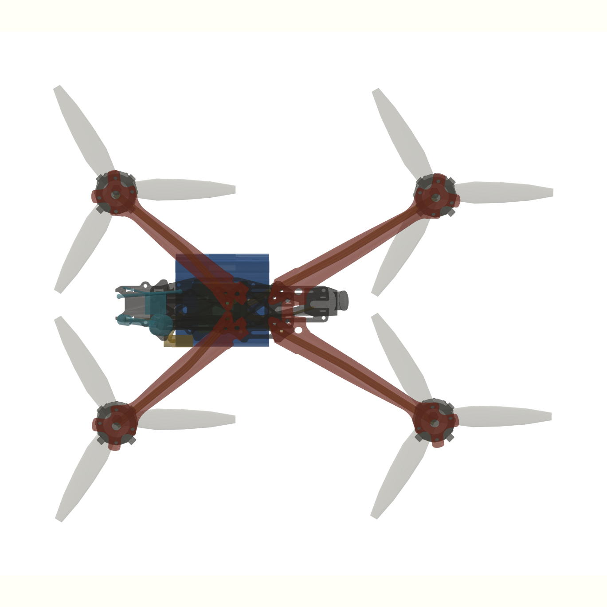
docs/frames/gen_0003/3edb9219bf87_bottom.png
