akaalias/airloom/docs/frames/gen_0007/558b1a7ddb64.png

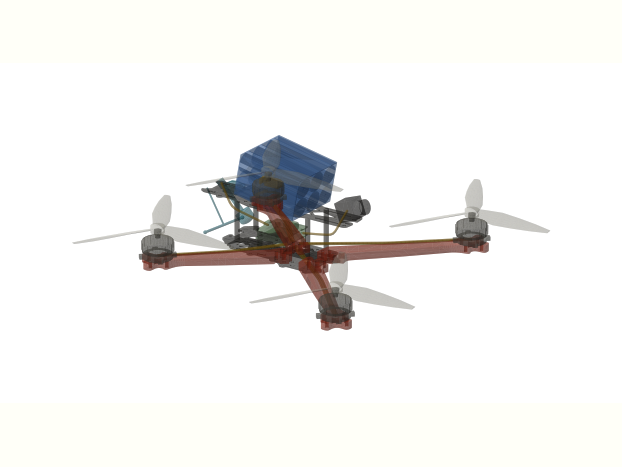
docs/frames/gen_0007/558b1a7ddb64.png
