akaalias/airloom/docs/frames/gen_0008/b39589cfab1f_bottom.png

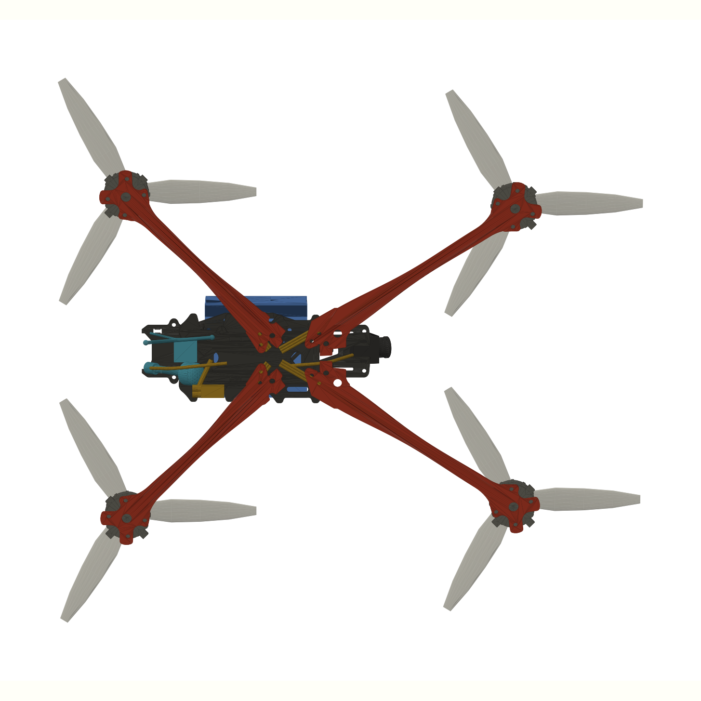
docs/frames/gen_0008/b39589cfab1f_bottom.png
