akaalias/airloom/docs/frames/gen_0009/f210f6970d00_bottom.png

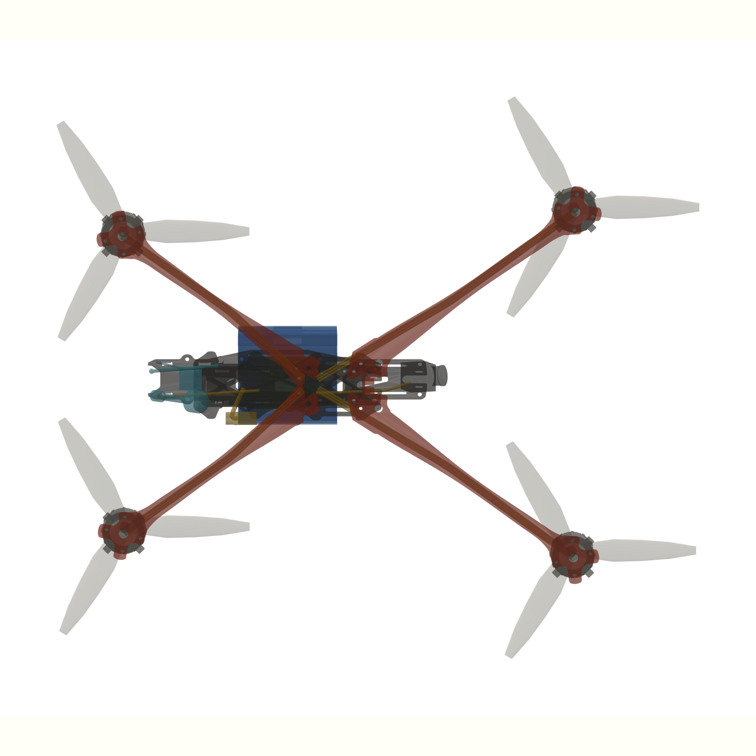
docs/frames/gen_0009/f210f6970d00_bottom.png
