akaalias/airloom/docs/frames/gen_0012/65e6a5f0f3b8_bottom.png

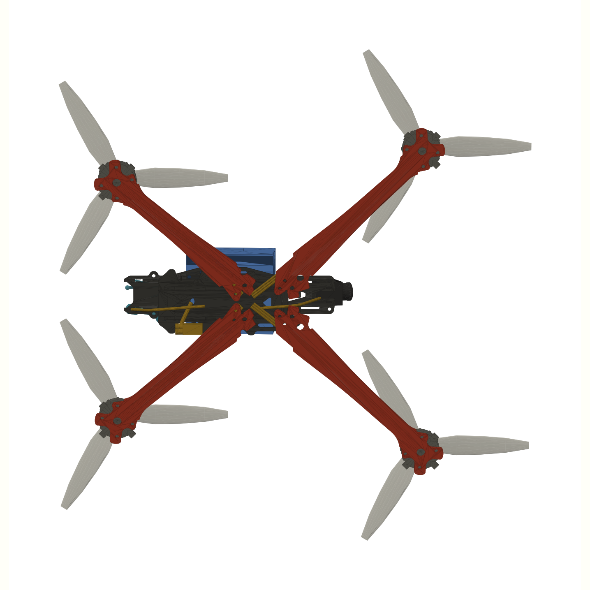
docs/frames/gen_0012/65e6a5f0f3b8_bottom.png
