akaalias/airloom/docs/frames/gen_0016/37eb0ed73f7e_bottom.png

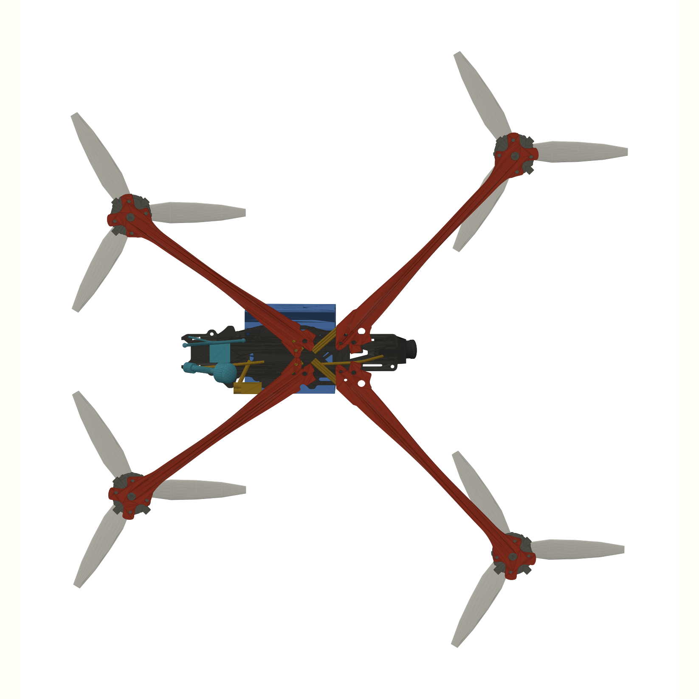
docs/frames/gen_0016/37eb0ed73f7e_bottom.png
