akaalias/airloom/docs/frames/gen_0016/b3aaaeaeec58.png

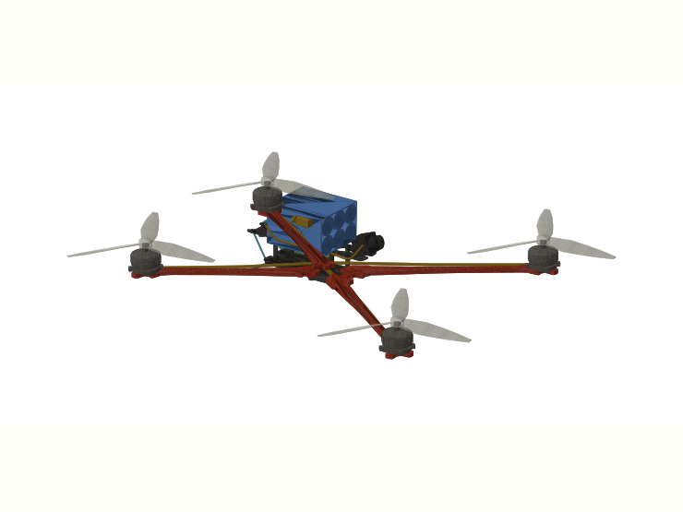
docs/frames/gen_0016/b3aaaeaeec58.png
