akaalias/airloom/docs/frames/gen_0017/83f19dec5965_bottom.png

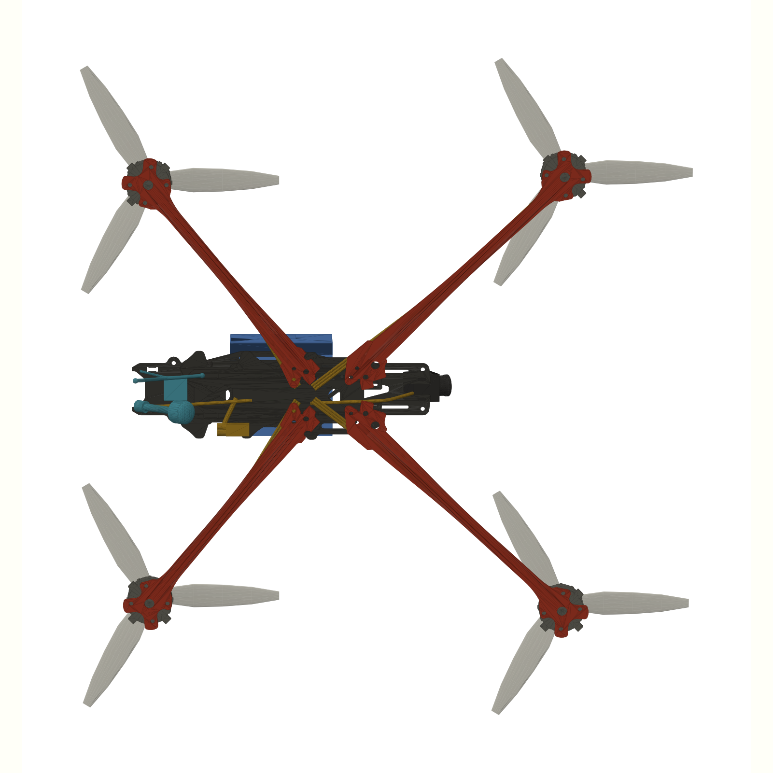
docs/frames/gen_0017/83f19dec5965_bottom.png
