akaalias/airloom/docs/frames/gen_0018/82e4f3f643e4_bottom.png

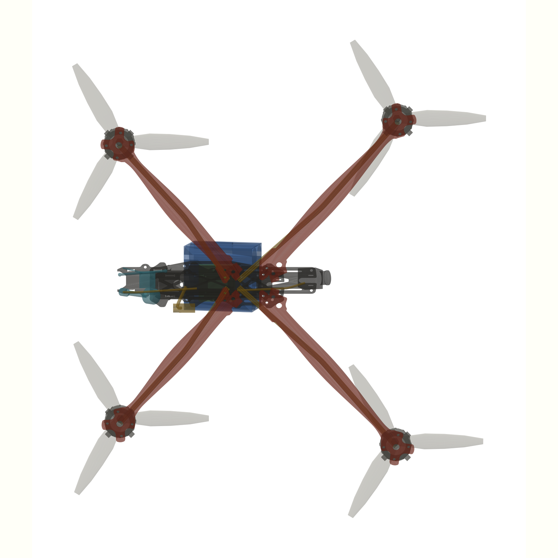
docs/frames/gen_0018/82e4f3f643e4_bottom.png
