akaalias/airloom/docs/frames/gen_0019/28ee1aea28cb.png

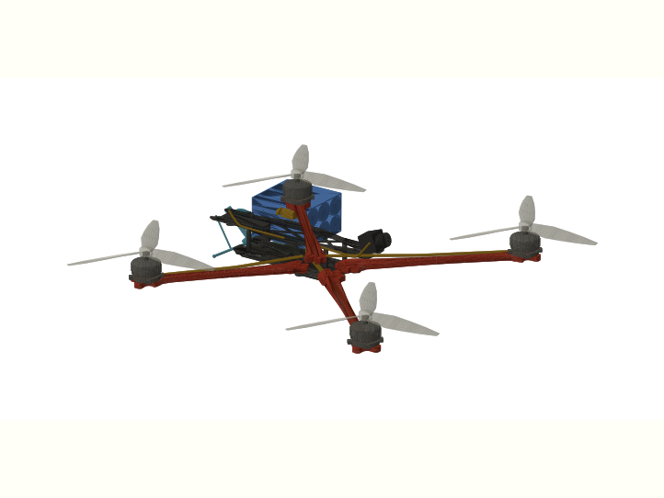
docs/frames/gen_0019/28ee1aea28cb.png
