akaalias/airloom/docs/frames/gen_0021/827158d42c32_bottom.png

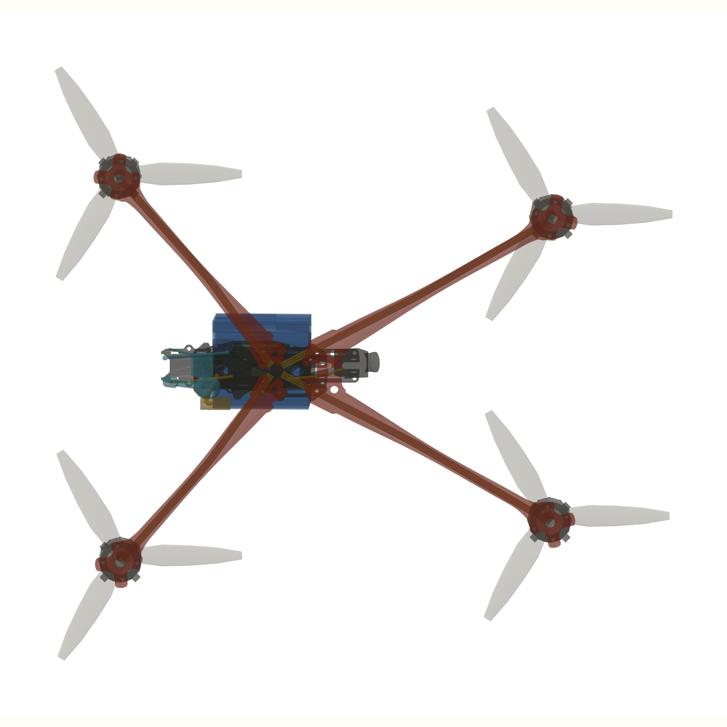
docs/frames/gen_0021/827158d42c32_bottom.png
