akaalias/airloom/docs/frames/gen_0022/f1ed396d782b_bottom.png

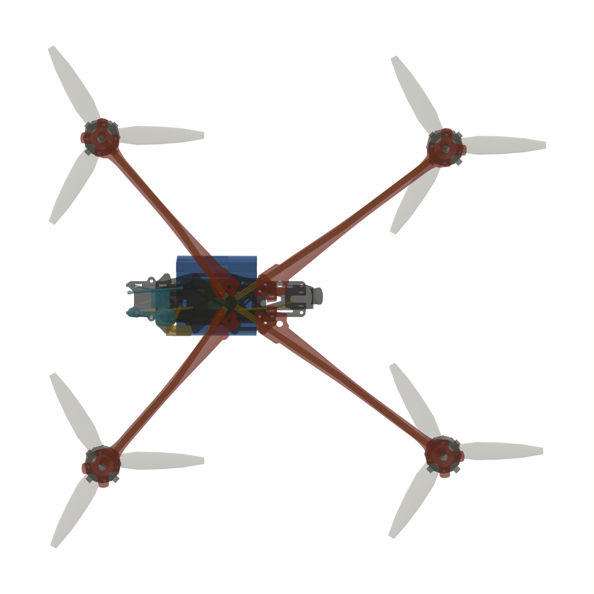
docs/frames/gen_0022/f1ed396d782b_bottom.png
