akaalias/airloom/docs/frames/gen_0025/80f9d365c89e_bottom.png

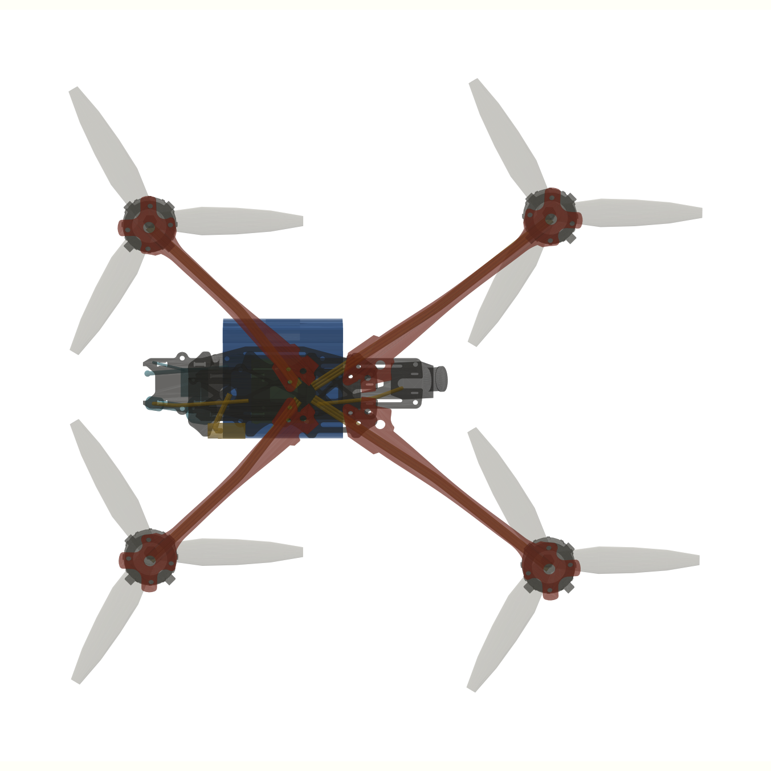
docs/frames/gen_0025/80f9d365c89e_bottom.png
