akaalias/airloom/docs/frames/gen_0030/1af27a90ed91_bottom.png

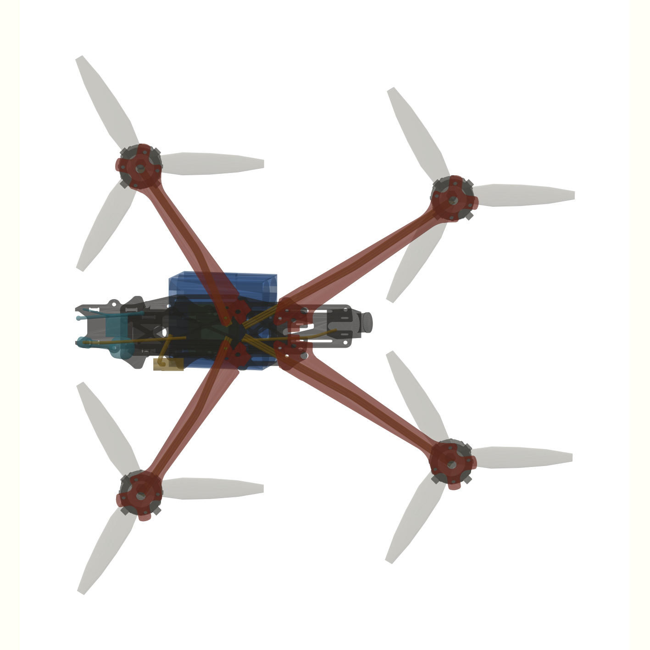
docs/frames/gen_0030/1af27a90ed91_bottom.png
