akaalias/airloom/docs/frames/gen_0035/828eaefbfeb7_bottom.png

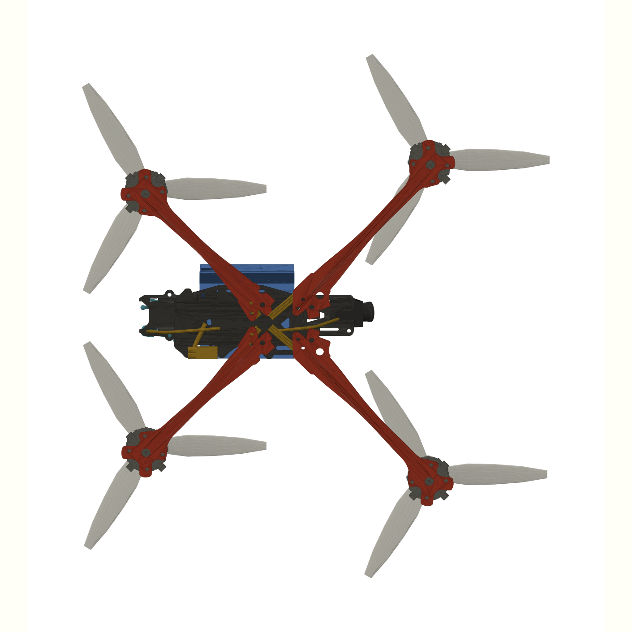
docs/frames/gen_0035/828eaefbfeb7_bottom.png
