akaalias/airloom/docs/frames/gen_0038/16ea95b31b16_bottom.png

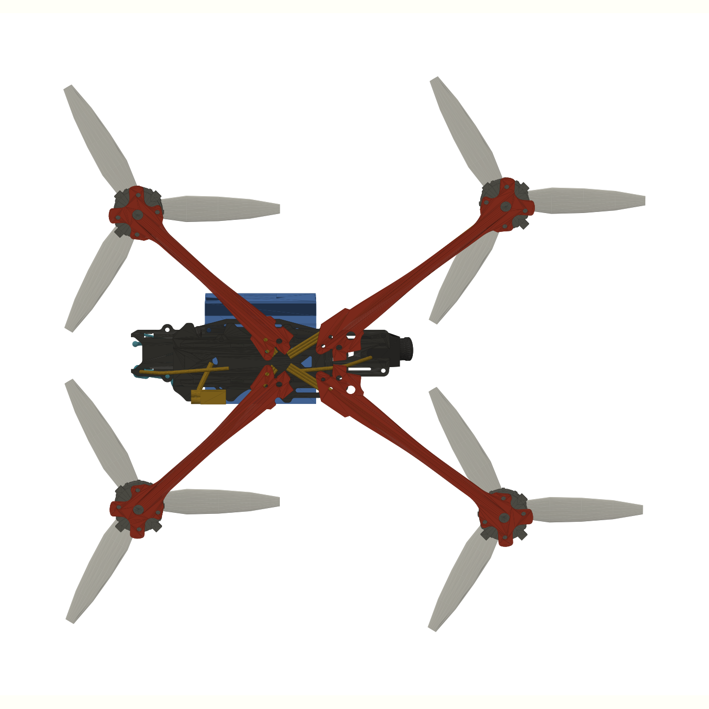
docs/frames/gen_0038/16ea95b31b16_bottom.png
