akaalias/airloom/docs/frames/gen_0042/7a3f2120adc9_bottom.png

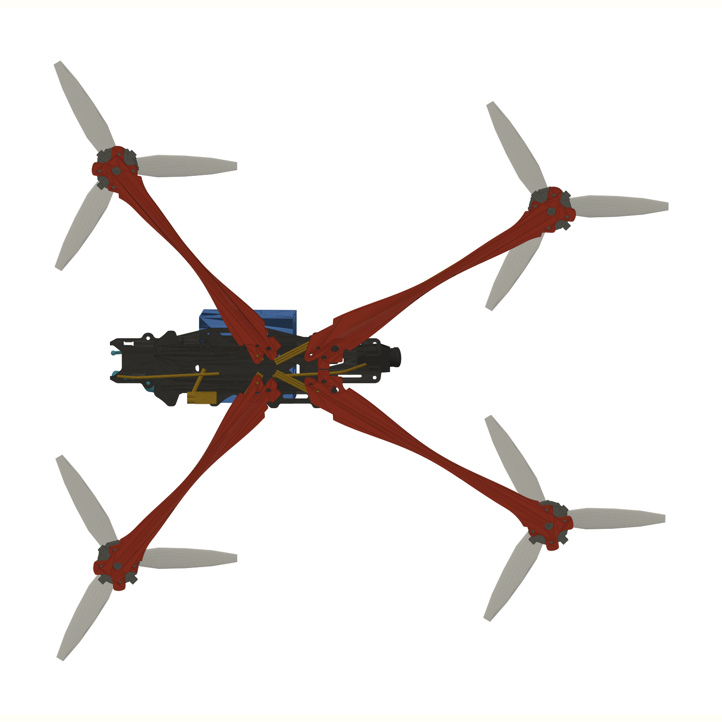
docs/frames/gen_0042/7a3f2120adc9_bottom.png
