akaalias/airloom/docs/frames/gen_0055/ae3c1d08a7a0_bottom.png

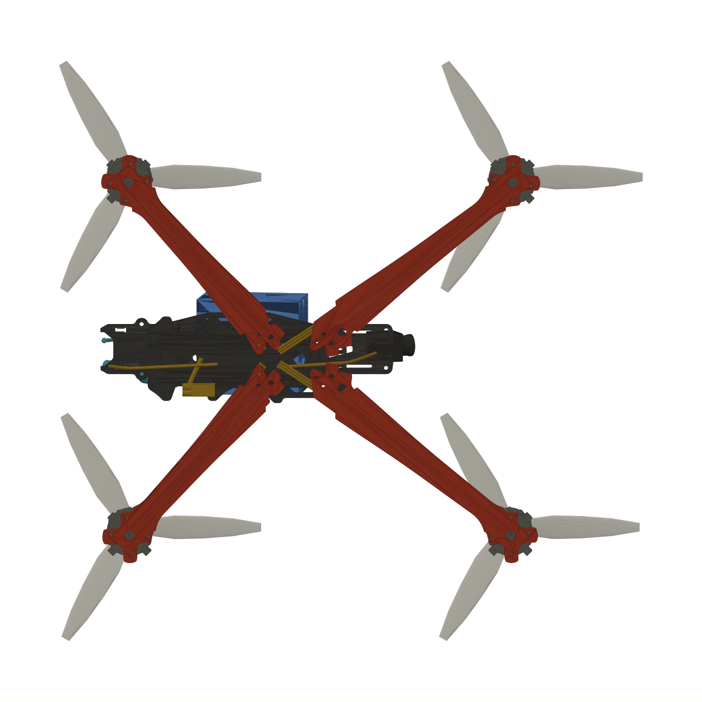
docs/frames/gen_0055/ae3c1d08a7a0_bottom.png
