akaalias/airloom/docs/frames/gen_0056/e8bf781f6fd4_bottom.png

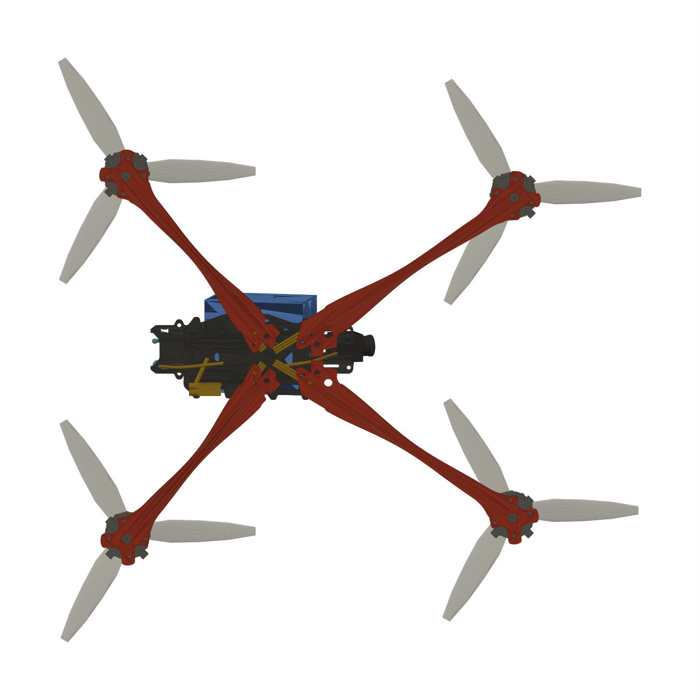
docs/frames/gen_0056/e8bf781f6fd4_bottom.png
