akaalias/airloom/docs/frames/gen_0055/16463dd9e9f5.parts/frame_assembled.stl

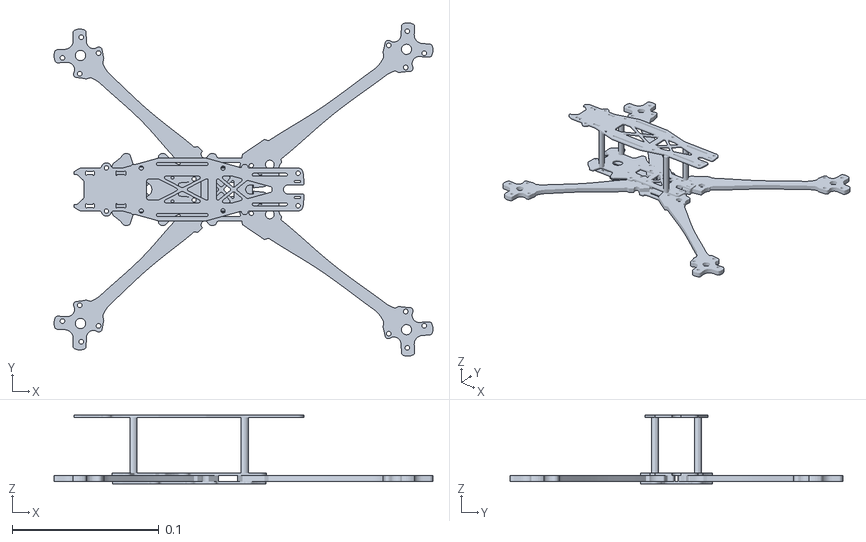
[picture p26: CAD file, 2026-07-24]
docs/frames/gen_0055/16463dd9e9f5.parts/frame_assembled.stl
0.259 x 0.227 x 0.0471
