akaalias/airloom/docs/frames/gen_0060/d773d9589e16.parts/frame_assembled.stl

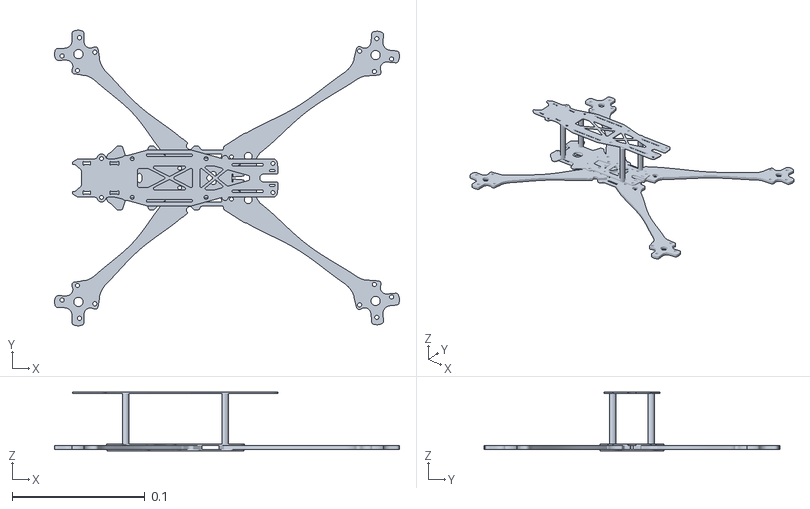
[picture p27: CAD file, 2026-07-24]
docs/frames/gen_0060/d773d9589e16.parts/frame_assembled.stl
0.26 x 0.223 x 0.0445
