akaalias/airloom/docs/frames/gen_0067/70471228a0b9.parts/frame_assembled.stl

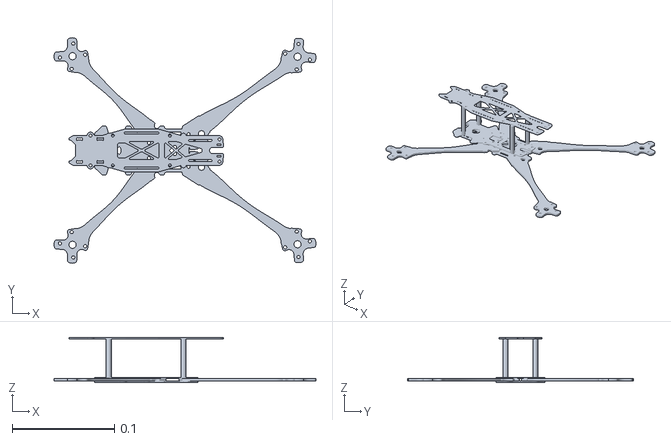
[picture p28: CAD file, 2026-07-24]
docs/frames/gen_0067/70471228a0b9.parts/frame_assembled.stl
0.256 x 0.22 x 0.0441
