akaalias/airloom/docs/frames/gen_0071/b0f1891a8f78.parts/frame_assembled.stl

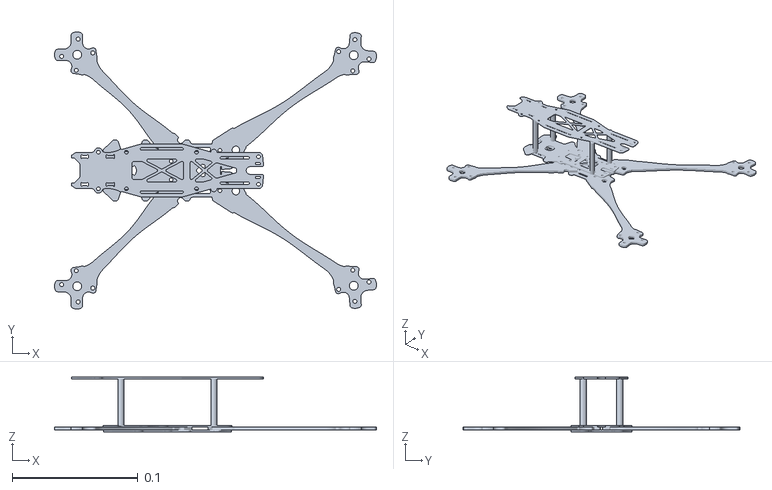
[picture p29: CAD file, 2026-07-24]
docs/frames/gen_0071/b0f1891a8f78.parts/frame_assembled.stl
0.256 x 0.22 x 0.0434
