akaalias/airloom/docs/frames/gen_0049/ecf9c2cbfabb.parts/frame_assembled.stl

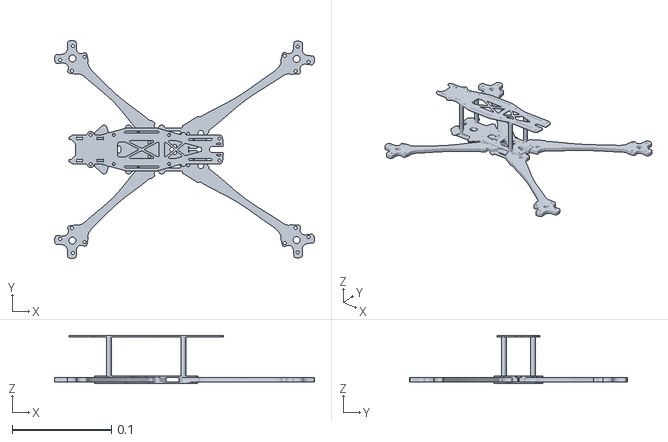
[picture p30: CAD file, 2026-07-24]
docs/frames/gen_0049/ecf9c2cbfabb.parts/frame_assembled.stl
0.262 x 0.22 x 0.0486
