akaalias/airloom/docs/frames/gen_0052/7cb5e0fb0f54.parts/frame_assembled.stl

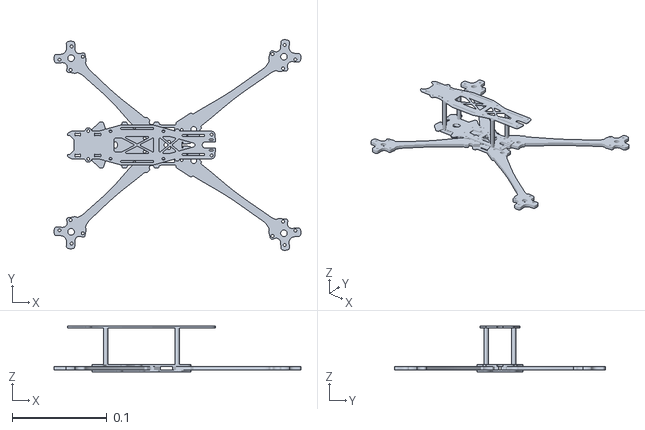
[picture p31: CAD file, 2026-07-24]
docs/frames/gen_0052/7cb5e0fb0f54.parts/frame_assembled.stl
0.261 x 0.222 x 0.0481
