akaalias/airloom/docs/frames/gen_0053/6c89b6db1b4e.parts/frame_assembled.stl

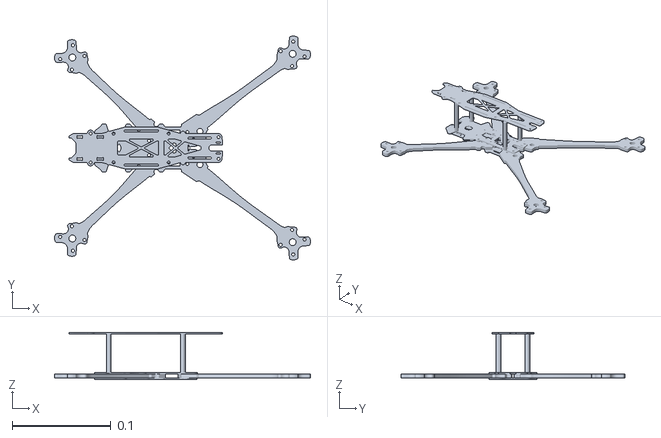
[picture p32: CAD file, 2026-07-24]
docs/frames/gen_0053/6c89b6db1b4e.parts/frame_assembled.stl
0.259 x 0.227 x 0.0481
