akaalias/airloom/docs/frames/gen_0061/7b72828ca192.parts/frame_assembled.stl

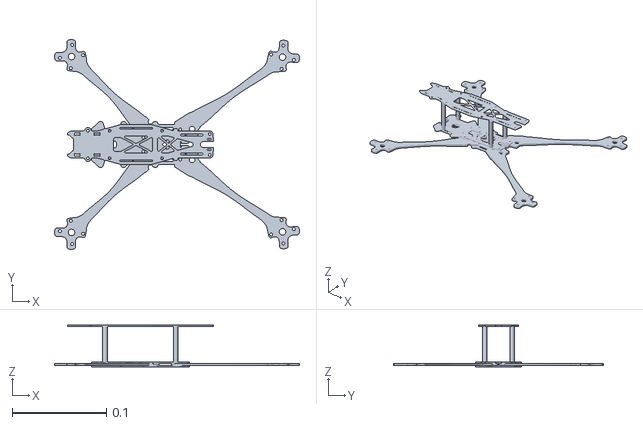
[picture p33: CAD file, 2026-07-24]
docs/frames/gen_0061/7b72828ca192.parts/frame_assembled.stl
0.26 x 0.223 x 0.0445
