akaalias/airloom/docs/frames/gen_0002/d2d88e31f0a9.parts/plate_main.stl

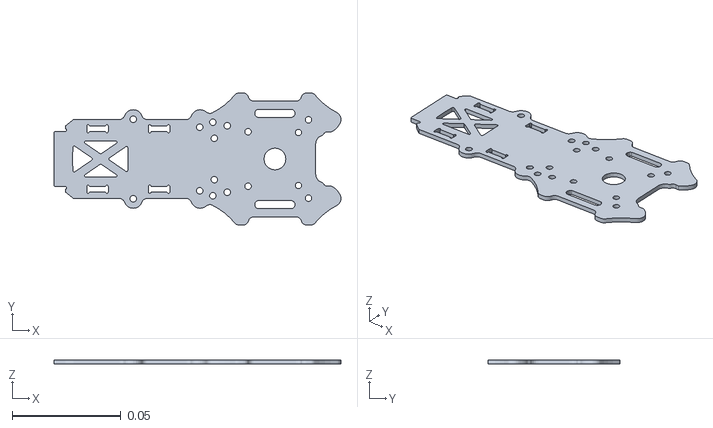
[picture p34: CAD file, 2026-07-25]
docs/frames/gen_0002/d2d88e31f0a9.parts/plate_main.stl
0.132 x 0.0606 x 0.00197
