akaalias/airloom/docs/frames/gen_0042/ef6352398ebc.parts/frame_assembled.stl

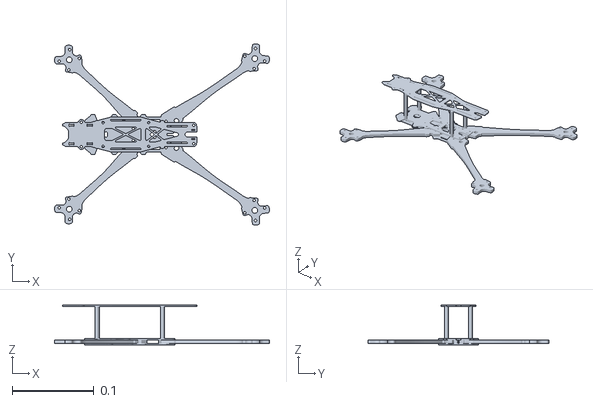
[picture p35: CAD file, 2026-07-24]
docs/frames/gen_0042/ef6352398ebc.parts/frame_assembled.stl
0.263 x 0.222 x 0.0489
