akaalias/airloom/docs/frames/gen_0074/8dff7a249bfd.parts/frame_assembled.stl

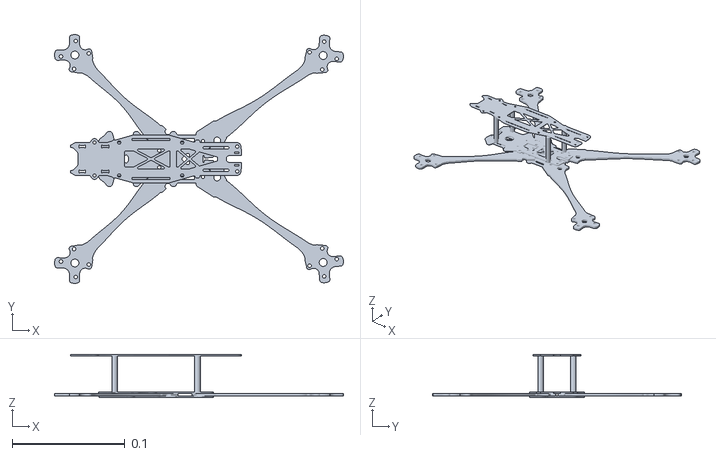
[picture p36: CAD file, 2026-07-24]
docs/frames/gen_0074/8dff7a249bfd.parts/frame_assembled.stl
0.256 x 0.22 x 0.0381
