akaalias/airloom/docs/frames/gen_0075/3ea600b4fceb.parts/frame_assembled.stl

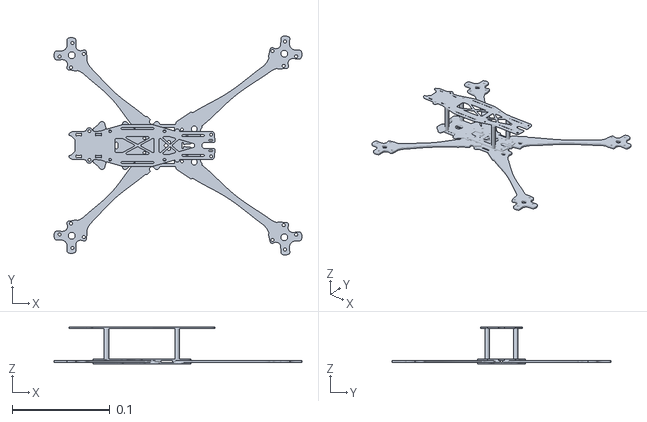
[picture p37: CAD file, 2026-07-24]
docs/frames/gen_0075/3ea600b4fceb.parts/frame_assembled.stl
0.253 x 0.224 x 0.0378
