akaalias/airloom/docs/frames/gen_0044/c742abdca96a.parts/frame_assembled.stl

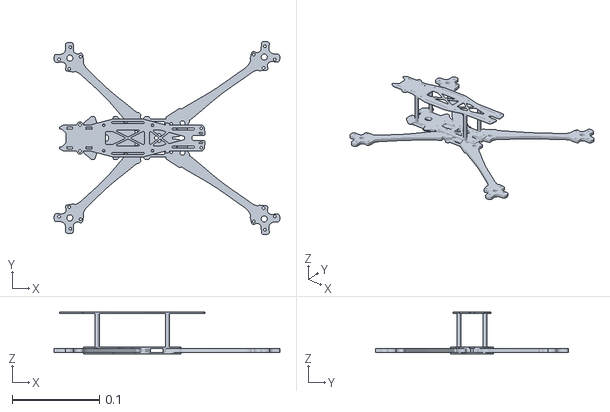
[picture p38: CAD file, 2026-07-24]
docs/frames/gen_0044/c742abdca96a.parts/frame_assembled.stl
0.259 x 0.221 x 0.0477
