akaalias/airloom/docs/frames/gen_0045/71bd5aa15020.parts/frame_assembled.stl

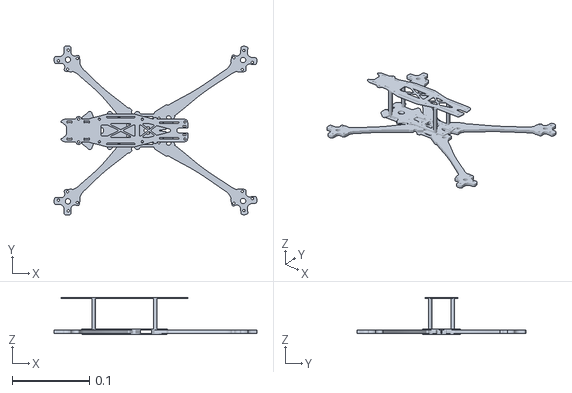
[picture p39: CAD file, 2026-07-24]
docs/frames/gen_0045/71bd5aa15020.parts/frame_assembled.stl
0.263 x 0.22 x 0.0485
