akaalias/airloom/docs/frames/gen_0070/ad8871a2dc40.parts/frame_assembled.stl

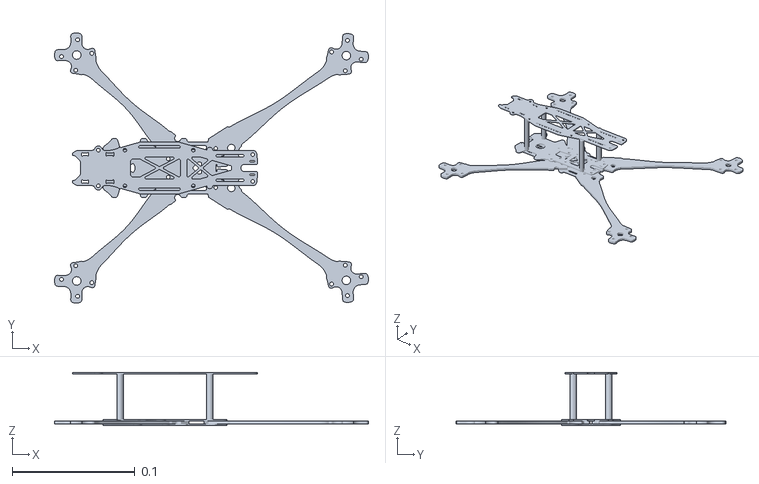
[picture p40: CAD file, 2026-07-24]
docs/frames/gen_0070/ad8871a2dc40.parts/frame_assembled.stl
0.256 x 0.22 x 0.0436
