akaalias/airloom/docs/frames/gen_0076/6c1c1963d383.parts/frame_assembled.stl

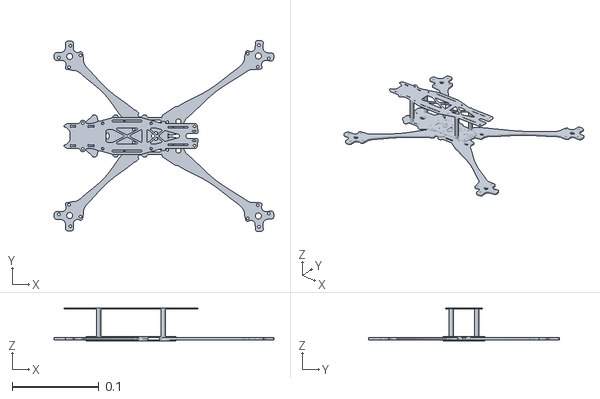
[picture p41: CAD file, 2026-07-24]
docs/frames/gen_0076/6c1c1963d383.parts/frame_assembled.stl
0.253 x 0.22 x 0.0376
