akaalias/airloom/docs/frames/gen_0079/4553a646ccc2.parts/frame_assembled.stl

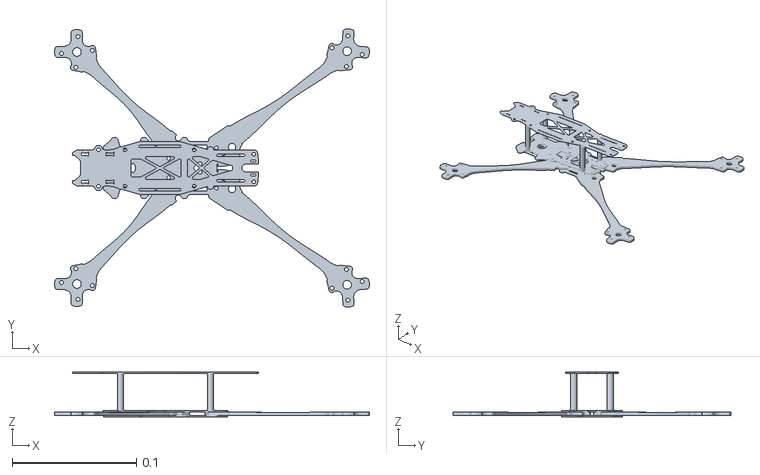
[picture p42: CAD file, 2026-07-24]
docs/frames/gen_0079/4553a646ccc2.parts/frame_assembled.stl
0.254 x 0.224 x 0.0361
