akaalias/airloom/data/source_one/SO1-V6-O4-Cam-Mount.stl

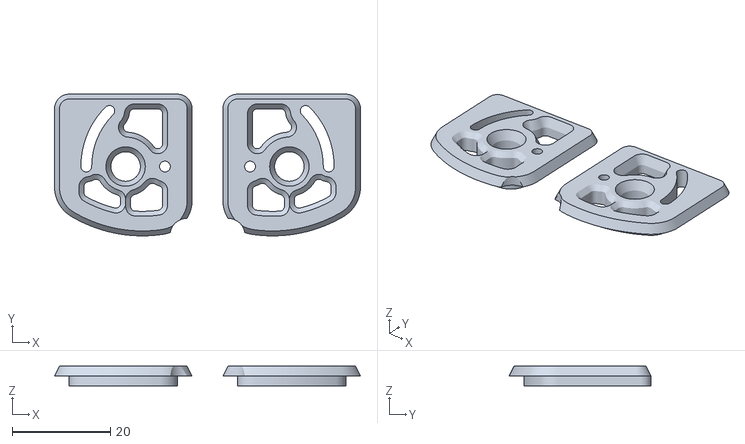
[picture p43: CAD file, 2026-07-13]
data/source_one/SO1-V6-O4-Cam-Mount.stl
62.3 x 28.8 x 4.00
