akaalias/airloom/data/source_one/SO1-V6-GoPro-Mount.stl

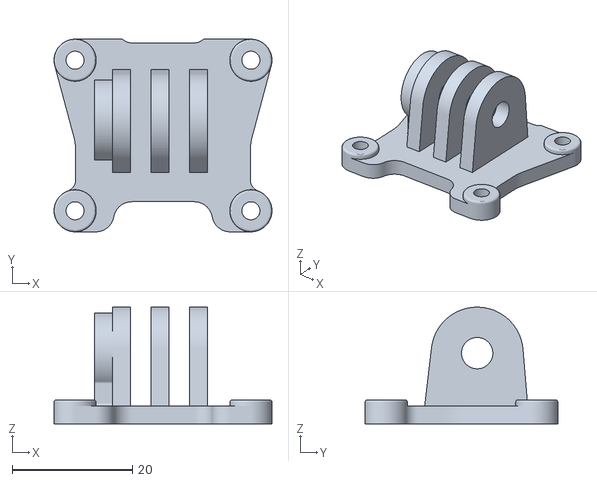
[picture p45: CAD file, 2026-07-13]
data/source_one/SO1-V6-GoPro-Mount.stl
36.2 x 32.0 x 19.4
