akaalias/airloom/docs/frames/gen_0002/d2d88e31f0a9.parts/arm_front.stl

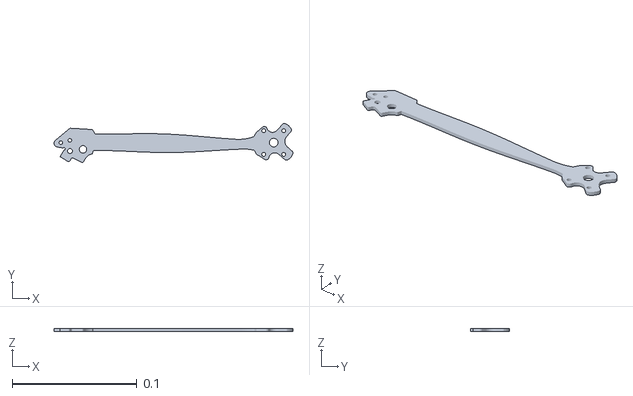
[picture p46: CAD file, 2026-07-25]
docs/frames/gen_0002/d2d88e31f0a9.parts/arm_front.stl
0.191 x 0.0313 x 0.0025
