akaalias/airloom/data/source_one/SO1-V6-ImT-Mount.stl

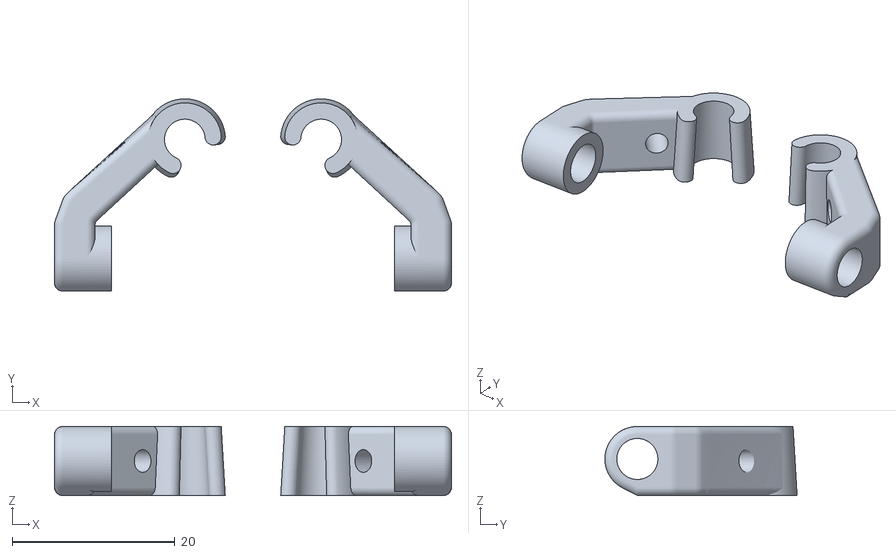
[picture p47: CAD file, 2026-07-13]
data/source_one/SO1-V6-ImT-Mount.stl
48.9 x 23.7 x 8.50
