akaalias/airloom/data/source_one/SO1-V6-O4-Antenna-Mount.stl

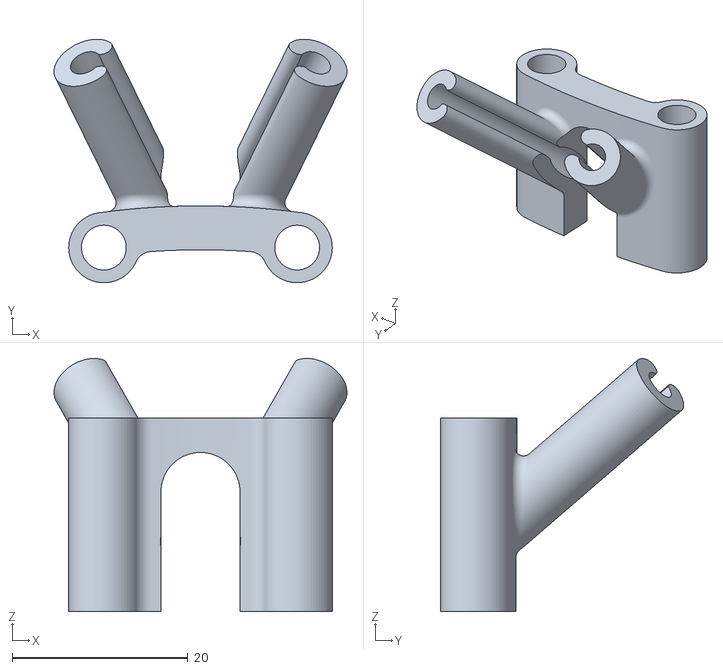
[picture p48: CAD file, 2026-07-13]
data/source_one/SO1-V6-O4-Antenna-Mount.stl
33.3 x 27.7 x 28.8
