akaalias/airloom/docs/frames/gen_0002/d2d88e31f0a9.parts/plate_top.stl

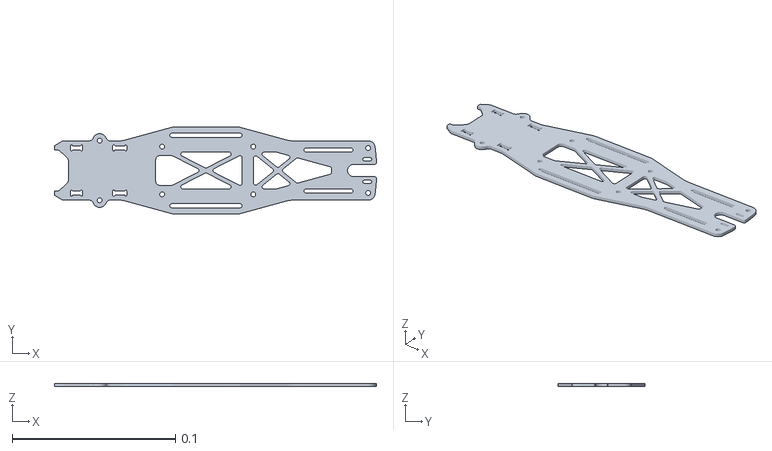
[picture p49: CAD file, 2026-07-25]
docs/frames/gen_0002/d2d88e31f0a9.parts/plate_top.stl
0.197 x 0.0531 x 0.00197
