akaalias/airloom/data/source_one/SO1-V6-AN-Cam-Mount.stl

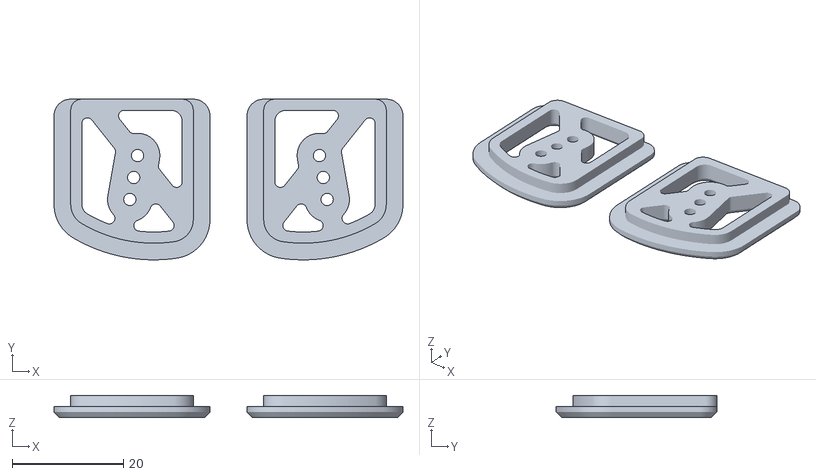
[picture p50: CAD file, 2026-07-13]
data/source_one/SO1-V6-AN-Cam-Mount.stl
62.6 x 28.8 x 4.00
