akaalias/airloom/docs/frames/gen_0002/d2d88e31f0a9.parts/arm_rear.stl

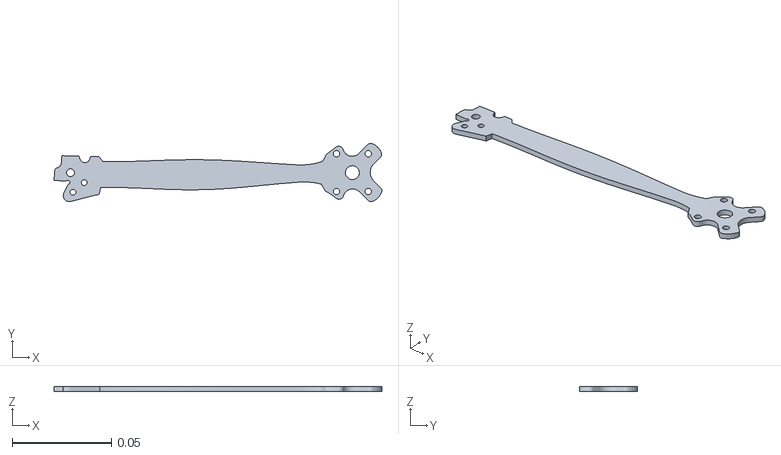
[picture p51: CAD file, 2026-07-25]
docs/frames/gen_0002/d2d88e31f0a9.parts/arm_rear.stl
0.165 x 0.0294 x 0.0025
