akaalias/airloom/data/source_one/So1-V6-2025-SMA-mount.stl

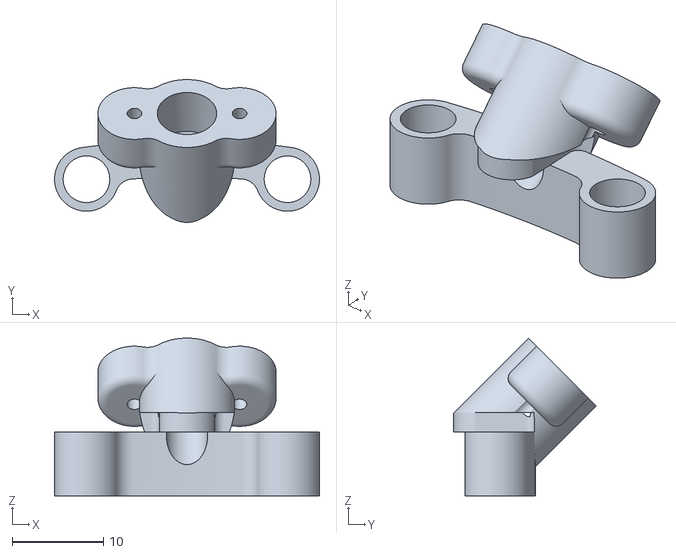
[picture p52: CAD file, 2026-07-13]
data/source_one/So1-V6-2025-SMA-mount.stl
29.0 x 15.6 x 17.3
