akaalias/airloom/(list of files, cad)

Other CAD files:
docs/frames/gen_0063/13cc64e0b6dc.parts/frame_assembled.stl
docs/frames/gen_0065/ec53169beaa7.parts/frame_assembled.stl
docs/frames/gen_0048/e7bb72f4bb57.parts/frame_assembled.stl
docs/frames/gen_0054/3f4703e7772e.parts/frame_assembled.stl
docs/frames/gen_0077/faeb6f8edb27.parts/frame_assembled.stl
docs/frames/gen_0046/8a8504d81e28.parts/frame_assembled.stl
docs/frames/gen_0059/939e58c18328.parts/frame_assembled.stl
docs/frames/gen_0072/1f59e66ff16e.parts/frame_assembled.stl
docs/frames/gen_0041/2991738d5132.parts/frame_assembled.stl
docs/frames/gen_0043/42b2f05c7846.parts/frame_assembled.stl
docs/frames/gen_0047/6a56f2c2924b.parts/frame_assembled.stl
docs/frames/gen_0040/b26f1effed24.parts/frame_assembled.stl
docs/frames/gen_0058/edfd1f91cfd1.parts/frame_assembled.stl
docs/frames/gen_0062/6f34a6d8b8a0.parts/frame_assembled.stl
docs/frames/gen_0069/e5b4e85a44a9.parts/frame_assembled.stl
docs/frames/gen_0073/87c8fa55a889.parts/frame_assembled.stl
docs/frames/gen_0039/913f15a5a9be.parts/arm_front.stl
docs/frames/gen_0039/913f15a5a9be.parts/arm_rear.stl
docs/frames/gen_0039/913f15a5a9be.parts/frame_assembled.stl
docs/frames/gen_0039/913f15a5a9be.parts/plate_main.stl
docs/frames/gen_0039/913f15a5a9be.parts/plate_mid.stl
docs/frames/gen_0039/913f15a5a9be.parts/plate_top.stl
docs/frames/gen_0040/b26f1effed24.parts/arm_front.stl
docs/frames/gen_0040/b26f1effed24.parts/arm_rear.stl
docs/frames/gen_0040/b26f1effed24.parts/plate_main.stl
docs/frames/gen_0040/b26f1effed24.parts/plate_mid.stl
docs/frames/gen_0040/b26f1effed24.parts/plate_top.stl
docs/frames/gen_0041/2991738d5132.parts/arm_front.stl
docs/frames/gen_0041/2991738d5132.parts/arm_rear.stl
docs/frames/gen_0041/2991738d5132.parts/plate_main.stl
docs/frames/gen_0041/2991738d5132.parts/plate_mid.stl
docs/frames/gen_0041/2991738d5132.parts/plate_top.stl
docs/frames/gen_0042/ef6352398ebc.parts/arm_front.stl
docs/frames/gen_0042/ef6352398ebc.parts/arm_rear.stl
docs/frames/gen_0042/ef6352398ebc.parts/plate_main.stl
docs/frames/gen_0042/ef6352398ebc.parts/plate_mid.stl
docs/frames/gen_0042/ef6352398ebc.parts/plate_top.stl
docs/frames/gen_0043/42b2f05c7846.parts/arm_front.stl
docs/frames/gen_0043/42b2f05c7846.parts/arm_rear.stl
docs/frames/gen_0043/42b2f05c7846.parts/plate_main.stl
docs/frames/gen_0043/42b2f05c7846.parts/plate_mid.stl
docs/frames/gen_0043/42b2f05c7846.parts/plate_top.stl
docs/frames/gen_0044/c742abdca96a.parts/arm_front.stl
docs/frames/gen_0044/c742abdca96a.parts/arm_rear.stl
docs/frames/gen_0044/c742abdca96a.parts/plate_main.stl
docs/frames/gen_0044/c742abdca96a.parts/plate_mid.stl
docs/frames/gen_0044/c742abdca96a.parts/plate_top.stl
docs/frames/gen_0045/71bd5aa15020.parts/arm_front.stl
docs/frames/gen_0045/71bd5aa15020.parts/arm_rear.stl
docs/frames/gen_0045/71bd5aa15020.parts/plate_main.stl
docs/frames/gen_0045/71bd5aa15020.parts/plate_mid.stl
docs/frames/gen_0045/71bd5aa15020.parts/plate_top.stl
docs/frames/gen_0046/8a8504d81e28.parts/arm_front.stl
docs/frames/gen_0046/8a8504d81e28.parts/arm_rear.stl
docs/frames/gen_0046/8a8504d81e28.parts/plate_main.stl
docs/frames/gen_0046/8a8504d81e28.parts/plate_mid.stl
docs/frames/gen_0046/8a8504d81e28.parts/plate_top.stl
docs/frames/gen_0047/6a56f2c2924b.parts/arm_front.stl
docs/frames/gen_0047/6a56f2c2924b.parts/arm_rear.stl
docs/frames/gen_0047/6a56f2c2924b.parts/plate_main.stl
docs/frames/gen_0047/6a56f2c2924b.parts/plate_mid.stl
docs/frames/gen_0047/6a56f2c2924b.parts/plate_top.stl
docs/frames/gen_0048/e7bb72f4bb57.parts/arm_front.stl
docs/frames/gen_0048/e7bb72f4bb57.parts/arm_rear.stl
docs/frames/gen_0048/e7bb72f4bb57.parts/plate_main.stl
docs/frames/gen_0048/e7bb72f4bb57.parts/plate_mid.stl
docs/frames/gen_0048/e7bb72f4bb57.parts/plate_top.stl
docs/frames/gen_0049/ecf9c2cbfabb.parts/arm_front.stl
docs/frames/gen_0049/ecf9c2cbfabb.parts/arm_rear.stl
docs/frames/gen_0049/ecf9c2cbfabb.parts/plate_main.stl
docs/frames/gen_0049/ecf9c2cbfabb.parts/plate_mid.stl
docs/frames/gen_0049/ecf9c2cbfabb.parts/plate_top.stl
docs/frames/gen_0052/7cb5e0fb0f54.parts/arm_front.stl
docs/frames/gen_0052/7cb5e0fb0f54.parts/arm_rear.stl
docs/frames/gen_0052/7cb5e0fb0f54.parts/plate_main.stl
docs/frames/gen_0052/7cb5e0fb0f54.parts/plate_mid.stl
docs/frames/gen_0052/7cb5e0fb0f54.parts/plate_top.stl
docs/frames/gen_0053/6c89b6db1b4e.parts/arm_front.stl
docs/frames/gen_0053/6c89b6db1b4e.parts/arm_rear.stl
docs/frames/gen_0053/6c89b6db1b4e.parts/plate_main.stl
docs/frames/gen_0053/6c89b6db1b4e.parts/plate_mid.stl
docs/frames/gen_0053/6c89b6db1b4e.parts/plate_top.stl
docs/frames/gen_0054/3f4703e7772e.parts/arm_front.stl
docs/frames/gen_0054/3f4703e7772e.parts/arm_rear.stl
docs/frames/gen_0054/3f4703e7772e.parts/plate_main.stl
docs/frames/gen_0054/3f4703e7772e.parts/plate_mid.stl
docs/frames/gen_0054/3f4703e7772e.parts/plate_top.stl
docs/frames/gen_0055/16463dd9e9f5.parts/arm_front.stl
docs/frames/gen_0055/16463dd9e9f5.parts/arm_rear.stl
docs/frames/gen_0055/16463dd9e9f5.parts/plate_main.stl
docs/frames/gen_0055/16463dd9e9f5.parts/plate_mid.stl
docs/frames/gen_0055/16463dd9e9f5.parts/plate_top.stl
docs/frames/gen_0058/edfd1f91cfd1.parts/arm_front.stl
docs/frames/gen_0058/edfd1f91cfd1.parts/arm_rear.stl
docs/frames/gen_0058/edfd1f91cfd1.parts/plate_main.stl
docs/frames/gen_0058/edfd1f91cfd1.parts/plate_mid.stl
docs/frames/gen_0058/edfd1f91cfd1.parts/plate_top.stl
docs/frames/gen_0059/939e58c18328.parts/arm_front.stl
docs/frames/gen_0059/939e58c18328.parts/arm_rear.stl
docs/frames/gen_0059/939e58c18328.parts/plate_main.stl
docs/frames/gen_0059/939e58c18328.parts/plate_mid.stl
docs/frames/gen_0059/939e58c18328.parts/plate_top.stl
docs/frames/gen_0060/d773d9589e16.parts/arm_front.stl
docs/frames/gen_0060/d773d9589e16.parts/arm_rear.stl
docs/frames/gen_0060/d773d9589e16.parts/plate_main.stl
docs/frames/gen_0060/d773d9589e16.parts/plate_mid.stl
docs/frames/gen_0060/d773d9589e16.parts/plate_top.stl
docs/frames/gen_0061/7b72828ca192.parts/arm_front.stl
docs/frames/gen_0061/7b72828ca192.parts/arm_rear.stl
docs/frames/gen_0061/7b72828ca192.parts/plate_main.stl
docs/frames/gen_0061/7b72828ca192.parts/plate_mid.stl
docs/frames/gen_0061/7b72828ca192.parts/plate_top.stl
docs/frames/gen_0062/6f34a6d8b8a0.parts/arm_front.stl
docs/frames/gen_0062/6f34a6d8b8a0.parts/arm_rear.stl
docs/frames/gen_0062/6f34a6d8b8a0.parts/plate_main.stl
docs/frames/gen_0062/6f34a6d8b8a0.parts/plate_mid.stl
docs/frames/gen_0062/6f34a6d8b8a0.parts/plate_top.stl
docs/frames/gen_0063/13cc64e0b6dc.parts/arm_front.stl
docs/frames/gen_0063/13cc64e0b6dc.parts/arm_rear.stl
docs/frames/gen_0063/13cc64e0b6dc.parts/plate_main.stl
docs/frames/gen_0063/13cc64e0b6dc.parts/plate_mid.stl
docs/frames/gen_0063/13cc64e0b6dc.parts/plate_top.stl
docs/frames/gen_0065/ec53169beaa7.parts/arm_front.stl
docs/frames/gen_0065/ec53169beaa7.parts/arm_rear.stl
docs/frames/gen_0065/ec53169beaa7.parts/plate_main.stl
docs/frames/gen_0065/ec53169beaa7.parts/plate_mid.stl
docs/frames/gen_0065/ec53169beaa7.parts/plate_top.stl
docs/frames/gen_0067/70471228a0b9.parts/arm_front.stl
docs/frames/gen_0067/70471228a0b9.parts/arm_rear.stl
docs/frames/gen_0067/70471228a0b9.parts/plate_main.stl
docs/frames/gen_0067/70471228a0b9.parts/plate_mid.stl
docs/frames/gen_0067/70471228a0b9.parts/plate_top.stl
docs/frames/gen_0069/e5b4e85a44a9.parts/arm_front.stl
docs/frames/gen_0069/e5b4e85a44a9.parts/arm_rear.stl
docs/frames/gen_0069/e5b4e85a44a9.parts/plate_main.stl
docs/frames/gen_0069/e5b4e85a44a9.parts/plate_mid.stl
docs/frames/gen_0069/e5b4e85a44a9.parts/plate_top.stl
docs/frames/gen_0070/ad8871a2dc40.parts/arm_front.stl
docs/frames/gen_0070/ad8871a2dc40.parts/arm_rear.stl
docs/frames/gen_0070/ad8871a2dc40.parts/plate_main.stl
docs/frames/gen_0070/ad8871a2dc40.parts/plate_mid.stl
docs/frames/gen_0070/ad8871a2dc40.parts/plate_top.stl
docs/frames/gen_0071/b0f1891a8f78.parts/arm_front.stl
docs/frames/gen_0071/b0f1891a8f78.parts/arm_rear.stl
docs/frames/gen_0071/b0f1891a8f78.parts/plate_main.stl
docs/frames/gen_0071/b0f1891a8f78.parts/plate_mid.stl
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
