akaalias/airloom/results/gallery.html

# frame evolution — run run_20260713_143716

0 generation(s) · 0 candidates (0 valid) · family tree · glossary · regenerated 14:38:15, refreshes every 30 s

candidatebest so far×invalid (design fail)g ⟳pivot generation (patience exhausted)aggregate Wh/km, lower is better

evolved:armsdeck plates + standoffsfixed kit:batteryFC/ESC stackwiring/XT60motorsprop disks

## candidate details & parentage

click a model to open it full-screen: tab 1 is the interactive 3D model, tab 2 compares it side-by-side with the oldest ancestor of its lineage, rotating in sync (available for the top candidates, improvement-setters and recent generations)

3d modelcompare with oldest ancestorchanged parts×

drag to rotate · scroll to zoom · double-click resets · esc closes

oldest ancestor

this candidate

the two models rotate and zoom in sync

evolved frame diff solid color = this candidate · gray ghost = oldest ancestor · fixed kit hidden

only the parts evolution changes are shown, superimposed
