akaalias/airloom/config/platform.yaml

# Fixed platform. Never varied by the optimizer.
#
# Matched to the official DroneAid Collective (drone-aid.de) workshop kit,
# a 7-inch long-range build in the TBS-Source-One plate-frame style
# (GPLv3, github.com/tbs-trappy/source_one):
#   - CNC carbon plate kit: two deck plates + standoffs, four flat plate
#     arms sandwiched at the center (the geometry we evolve)
#   - 4x 2806-class brushless motors with 7x4 3-blade props
#   - self-built 6S1P Li-Ion pack from single 21700 cells + XT60/BEC board,
#     strapped on top of the deck
#   - 30.5 mm Betaflight FC + 4-in-1 ESC stack between the plates
#   - micro FPV camera, video transmitter + antenna, ELRS receiver

battery:
  # 6S1P 21700 Li-Ion (Molicel P42A class), 2x3 brick, on the top plate.
  cells: 6
  capacity_mah: 4200
  voltage_nominal: 22.2    # V
  mass_kg: 0.470           # 6 cells + nickel strip, BEC board, XT60, wrap
  # Pack electrical limits (the "can the pack actually deliver this" model):
  # terminal voltage sags as V = V0 - I*R; the sim solves pack current from
  # demanded motor power each step. P42A-class DC IR ~22 mOhm/cell warm,
  # plus nickel strip / XT60 / wiring -> ~0.15 Ohm for the 6S1P pack.
  # Max deliverable power = V0^2/(4R) ~ 820 W; at the 45 A cell rating the
  # pack sags to ~15.5 V (~2.6 V/cell), consistent with P42A discharge curves.
  internal_resistance_ohm: 0.15
  max_current_a: 45.0
  # rigid rectangular block, meters (L x W x H)
  size_m: [0.070, 0.066, 0.044]
  fit_clearance_m: 0.001
  # the deck's top plate must carry the pack: plate length/width may be no
  # smaller than this fraction of the battery footprint (strap overhang OK)
  support_frac: 0.55

propulsion:
  # 4x 2806-class ~1300KV brushless with 7-inch props on 6S.
  # Ground truth: UIUC Propeller Database volume 1, Master Airscrew GF 7x4
  # (static + 4 dynamic RPM sweeps), cached in data/uiuc/ -- the closest
  # measured dataset to the kit's 7x4-class propeller (2-blade vs the kit's
  # 3-blade: see README limitations).
  prop_name: "Master Airscrew GF 7x4 (UIUC volume-1)"
  prop_diameter_m: 0.1778
  prop_pitch_m: 0.1016
  n_rotors: 4
  motor_mass_kg: 0.043          # 2806.5 class, each
  motor_esc_efficiency: 0.85    # combined motor + ESC, electrical->shaft
  max_rpm: 22000                # ~1300KV on 6S, loaded ceiling
  max_motor_power_w: 500        # per motor, electrical
  uiuc_data_dir: "data/uiuc"
  uiuc_static_file: "magf_7x4_static_2911cm.txt"
  uiuc_dynamic_files:
    - "magf_7x4_2912cm_4014.txt"
    - "magf_7x4_2913cm_5015.txt"
    - "magf_7x4_2914cm_6020.txt"
    - "magf_7x4_2915cm_6998.txt"

flight_controller:
  mount_pattern_m: 0.0305       # 30.5 x 30.5 mm hole pattern, between plates
  mount_flat_m: 0.0365          # required flat square on the plates
  stack_height_m: 0.020         # FC + 4-in-1 ESC stack: minimum deck gap
  mass_kg: 0.015
  # camera 9 g, VTX + antenna 38 g, ELRS RX + dipole 5 g, props 4x8 g,
  # straps/screws/wiring 42 g
  wiring_receiver_mass_kg: 0.126

# 3D-print / plate material library: the LAST genome gene selects one of
# these for the whole frame (plates + arms). Values are typical
# datasheet/XY-direction numbers; printed parts are weaker across layers
# (see README limitations). Ordered stiffest -> softest so neighboring gene
# values mean similar materials.
# as_built_strength_frac: what fraction of the datasheet tensile strength an
# as-printed/as-cut part actually delivers in bending (perimeter seams, layer
# adhesion, moisture, print defects). Used only by the champion verification
# report (airloom verify-champions), NOT by the in-loop constraint.
materials:
  - name: cf_plate        # CNC-cut quasi-isotropic carbon laminate (not printed)
    density_kg_m3: 1600.0
    tensile_strength_pa: 600.0e6
    youngs_modulus_pa: 70.0e9
    min_plate_thickness_m: 0.0012
    as_built_strength_frac: 1.0
  - name: pa12_cf         # carbon-fiber nylon (PA12-CF / PAHT-CF class)
    density_kg_m3: 1170.0
    tensile_strength_pa: 110.0e6
    youngs_modulus_pa: 7.6e9
    min_plate_thickness_m: 0.0016
    as_built_strength_frac: 0.65
  - name: pet_cf          # carbon-fiber PET
    density_kg_m3: 1310.0
    tensile_strength_pa: 90.0e6
    youngs_modulus_pa: 6.2e9
    min_plate_thickness_m: 0.0016
    as_built_strength_frac: 0.65
  - name: pla_plus
    density_kg_m3: 1240.0
    tensile_strength_pa: 60.0e6
    youngs_modulus_pa: 3.6e9
    min_plate_thickness_m: 0.0016
    as_built_strength_frac: 0.60
  - name: petg
    density_kg_m3: 1270.0
    tensile_strength_pa: 50.0e6
    youngs_modulus_pa: 2.1e9
    min_plate_thickness_m: 0.0016
    as_built_strength_frac: 0.60
  - name: asa
    density_kg_m3: 1070.0
    tensile_strength_pa: 40.0e6
    youngs_modulus_pa: 2.0e9
    min_plate_thickness_m: 0.0016
    as_built_strength_frac: 0.60

structure:
  safety_factor: 1.5
  max_tip_deflection_frac: 0.05   # of arm length
  resonance_band_frac: 0.15       # reject f1 within +-15% of hover rotor freq (1P)
  plate_base_m: 0.002             # deck plate thickness, scaled by thickness_scale
  standoff_radius_m: 0.0025       # M3-ish deck standoffs
  standoff_mass_per_m: 0.055      # kg per meter of standoff (x4)

geometry:
  rotor_tip_clearance_m: 0.005    # rotor to frame and rotor to rotor
  motor_pad_radius_m: 0.0135      # 2806 mount footprint
  motor_pad_height_m: 0.005
  motor_body_radius_m: 0.0155     # visual model of the fixed motor can
  motor_body_height_m: 0.019
