akaalias/airloom/(commit log)

2026-07-12 First run
    [1656909eb120.stl, 2c2caf129043.stl, 3e76ba7af4b9.stl, 465130b73e42.stl, 4c3859fd829a.stl, 4e5823e8e691.stl, 51a25179d9e3_INVALID.stl, 54c6f324e24d.stl]
2026-07-12 framevo: evolutionary quadcopter frame optimization for Wh/km
    Phase A complete: DXF-calibrated DroneAid 7-inch kit platform, 14-gene
    genome incl. print material, six-scenario portfolio with seeded Dryden
    turbulence, GA with full lineage, SQLite persistence with resume,
    Tufte gallery with WebGL viewers, progress chart with class benchmark,
    printable per-part STL export.
    [gen_0000_best.stl, gen_0001_best.stl, gen_0002_best.stl]
2026-07-12 Patience: plateau detection + far-parent pivot generations
    6 gens without >=0.5% best-so-far improvement triggers a pivot: half the
    non-elite slots bred from (tournament winner) x (most distant decent
    candidate in run history) with boosted sigma; escalates to random far
    parents. Resume-safe (derived from DB). Teal pivot markers in chart and
    family tree. Grounded in run data: healthy improvement gaps are 1-4 gens,
    plateaus coincide with diversity collapse below ~0.1.
    [gen_0000_best.stl, gen_0001_best.stl, gen_0002_best.stl]
2026-07-12 Density-adaptive progress chart for 100+ generation runs
    Generation labels thin to a ~36px-spaced subset; every pivot generation
    keeps a teal axis tick regardless. Invalid marks switch from x glyphs to
    a barcode of thin ticks past 400 candidates, candidate dots shrink with
    count, and best-so-far hash labels skip when they would overlap.
2026-07-13 Real-geometry core: official SO V6 outlines as the genome substrate
    Extract arms/plates with holes+cutouts from the official DXF (arc-flattened),
    zone-preserving morphs, bolt-registered front anchors + best-fit rear anchors,
    mirrored arm chirality, real component library (cells/stack/motors/3-blade
    props/camera/antennas/routed wiring), z-aware rotor clearances, frame mass
    from real volumes. Baseline reproduces the real V6 7in DC (144 g frame).
    [SO1-V6-AN-Cam-Mount.stl, SO1-V6-GoPro-Mount.stl, SO1-V6-ImT-Mount.stl, SO1-V6-O4-Antenna-Mount.stl, SO1-V6-O4-Cam-Mount.stl, So1-V6-2025-SMA-mount.stl]
2026-07-13 Headless-Claude designer rounds + real-genome tests and docs
    [gen_0000_best.stl, gen_0001_best.stl, gen_0002_best.stl]
2026-07-13 Viewer blob decimation, designer brief constraint couplings, real-genome docs
    End-to-end validated: 8-gen run on the real geometry with a live headless-
    Claude designer round at gen 6 (3 reasoned proposals injected and logged).
2026-07-13 framevo run resumes the latest run by default (--fresh for a new one)
    Auto-resume picks the newest run when its genome spec matches, updates the
    generations target, and refuses politely when the target is already met.
2026-07-13 Lab-notebook narrator + gallery clarity pass
    - narrator.py: one headless-Claude call per generation writes a
    hypothesis / method / result note for every new candidate (rule-based
    fallback), stored via additive column migration -- shown in detail
    blocks and family-tree hover cards; invalid candidates get their
    constraint explained in the result
    - detail headline in plain language (energy score + definition) with
    run-champion / new-best badges
    - chart markers hoverable + click-to-jump to the detail card
    - best-so-far setters share the chart's visual language (ink cards)
    - overlay: third tab with a 3D diff of the evolved parts (candidate
    solid, oldest ancestor as gray ghost, fixed k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
    [evolution.yaml]
2026-07-13 Async narrator (off the critical path) + metric/value header table
    Rule-based notes are written instantly; the headless-Claude enrichment
    runs on a background thread with its own DB connection and upgrades the
    notes in place, joined before the run finishes. Detail headers are now a
    clean metric/value table (formula note dropped); invalid candidates show
    status + reason as the first row.
2026-07-13 Snapshot results/ into a nested repo before every run; --fresh now clears
    Each framevo run commits the current results folder into results/.git
    (invisible to the project repo, which ignores results/) before extending
    or clearing it. --fresh actually empties the folder afterwards; any past
    state restores via git -C results checkout <hash> -- .
2026-07-13 Gallery viewer fit-to-viewport defaults + detail card polish
    - 3D overlay: per-model projected extents (computed at decode time)
    drive a fit factor so every model starts zoomed to fill the canvas
    at the tilted-down default pitch, on all three tabs; diff tab fits
    its deck+arms subset and keeps its top-down pitch through reset
    - Detail cards: hypothesis/method/result labels are block headings;
    new "scenario results & genome" section heading above the tables
    - Champion/setter detail rows invert to ink-on-dark like the grid cards
    - Emit <!doctype html> (quirks mode blocked color inheritance in tables)
2026-07-13 Gallery header/legend restyle + infinity row polish on the chart
    - invalid-X strip floats higher above the finite scale and gets an
    infinity symbol as its own y-axis label, matching the grid cards
    - gallery header matches the lineage page: centered title and stats,
    a centered prose intro explaining how to read the chart
    - legend rebuilt in the lineage page's language: centered rows with
    hover tooltips explaining every mark and part color
2026-07-13 Gallery candidate UI polish
    - grid cards: drop the operator/material line under the hash
    - invalid candidates: red diagonal cross over the render, in both the
    grid cards and the detail rows
    - detail rows: "candidate <hash>" header above the three columns,
    16px spacer between rows (inverted bands no longer fuse together)
    - tables heading restyled (larger, ink) so it reads as a section
    header, says just "genome" for invalids, and the dead scenario
    table is gone for candidates that never flew
    - chart: every marker (dots, off-scale, invalid x's) clicks through
    to its detail card; pivots draw a full-height teal dashed marker
    that survives label thinning
    - parts-color legend moved out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
2026-07-13 3D overlay: inverted bar for setters, richer title, pan + view presets
    - opening a setter/champion keeps its inverted color scheme in the
    overlay tab bar and parts-legend row
    - tab-row title reads "candidate <hash> · <fit> Wh/km" instead of the
    bare hash-dot-number
    - cmd/ctrl-drag pans the model (new uPn shader uniform); pan clears on
    reset/double-click and is mentioned in the corner hint
    - corner buttons snap to fit / front / top / bottom / left / right /
    default on whichever tab is active, calibrated so the FPV-camera
    nose faces the viewer in front view and up in the plan views
    - glossary overlay entry updated for the new controls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
2026-07-13 Overlay fit fix, invalid viewers persist, lineage card aligned
    - fit button now computes the zoom that fits the CURRENT orientation
    (the draw-time fit factor is anchored at base pitch, so after
    rotating the old zoom=1 was a no-op); on compare it fits both panes
    - mesh blobs are embedded by priority (champion/setters, recent
    generations, top hundred, then everything else newest-first,
    invalids included) under a 64MB budget, so failed candidates no
    longer lose their click-to-3D once they age out of the last three
    generations; only very long runs shed their oldest, weakest models
    - lineage hover card aligned with the gallery detail language:
    "candidate <hash>" header, bold Wh/km l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
2026-07-13 Launch-time CLI flags + honest viewer meshes for evolved parts
    - framevo run gains --claude-model / --designer-model /
    --narrator-model, --designer-every, --designer-candidates,
    --no-designer, --no-narrator, --patience, --lambda-worst; plumbed
    through load_config overrides (tuning knobs stay YAML-only)
    - viewer decimation budgets for the evolved parts raised (deck
    3200->12000, arms 2200->7000 faces): the old budgets warped thin
    truss webs into false spikes on screen
2026-07-13 Hard constraints: plate web width and printed plate thickness
    Evolution was exploiting unmodeled plate structure: the FC-stack holes
    stay pinned while plates scale, so shrinking plates slid cutouts into
    the holes and collapsed material webs to slivers (a champion reached
    0.06 mm), and plate thickness dropped to 1.4 mm with no check at all
    (the structural checks cover arms only).
    - realgeo.min_web_width(): narrowest material web between a plate's
    holes, cutouts and outer edge (2D shapely, cheap)
    - build_frame rejects plates whose narrowest web falls below 80% of
    the stock part's ("plate web too thin"), in the mesh-free pre-screen
    path so designer proposals are caught pre-flight too
    - p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
    [platform.yaml]
2026-07-13 Shared top navigation + lineage walkthrough stepper with cross-fade
    - nav_html()/NAV_CSS: one topnav (gallery / family tree / glossary)
    across all three result pages
    - viewer gains a per-model fade uniform and a walkthrough stepper in
    the overlay for stepping along a candidate's lineage
2026-07-13 Replay timeline with autoplay + longer cross-fades; rejected genes kept
    The replay tab gains a scrubbable timeline docked above the view
    controls: one thumbnail per lineage step (generation label, hash and
    fitness on hover), oldest selected by default. Clicking a thumbnail
    cross-fades straight to that step; the play button auto-steps every
    1.6s and any manual input pauses it. Transitions lengthened to 950ms.
    Designer rounds now keep rejected proposals' genes in the round log,
    making it self-contained since rejects are never persisted as
    candidates.
2026-07-13 Full-ancestry replay/trail chains; Sonnet 5 default for LLM calls
    The replay timeline and lineage trail now walk BOTH parents to collect
    a candidate's full ancestry (a primary-line walk dead-ends when
    parent_a is a parentless designer/immigrant while the deep lineage runs
    through parent_b), ordered oldest generation first. _oldest_ancestor
    gets the same fix, so "vs oldest ancestor" and "net change" compare
    against the true earliest-born ancestor. Ancestors whose 3D blob was
    shed by the embed budget appear as dimmed timeline thumbnails.
    Designer and narrator rounds now default to claude-sonnet-5 for speed.
    [evolution.yaml]
2026-07-13 GPLv3 license; docs/ as standing GitHub Pages target for the report
    Going public as free software: GNU GPL v3 or later (LICENSE, pyproject,
    README), matching the Source One heritage the frame geometry derives
    from.
    The gallery artifact is renamed gallery.html -> index.html and docs/ is
    now the standing publish target, not an afterthought: every artifact
    refresh (each generation in a live run, and `framevo gallery`) mirrors
    the report pages, charts, and render stills into docs/ via
    publish_docs(), ready for GitHub Pages from main:/docs. Mesh blobs stay
    out (embedded in the HTML). The 30s auto-reload now runs only on
    file:///localhost - the published copy is a frozen report.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
2026-07-13 Phase B milestone 1: OpenFOAM drag-calibration harness
    framevo cfd-calibrate writes 12 runnable cases under cfd/ (4 geometries x
    3 tilt angles at cruise speed): baseline arms alone, deck/kit alone, full
    assembly, and a contrasting genome's full assembly. Arms/body cases
    calibrate CD_ARM/CD_BODY (the robustness sweep flagged CD_ARM as the only
    rank-changing knob); full - (arms + body) measures the interference the
    buildup assumes to be zero; contrast-vs-baseline tests whether that
    interference varies with the genes. One snappyHexMesh per geometry,
    freestream far-field BCs so tilt is a velocity vector, simpleFoam k-omega
    SST with a forces function object; --solve runs Docker
    (opencfd/openfoam-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
2026-07-13 Report snapshot: frog-inspired 30-gen run in progress (gen 20) + CFD manifest
    docs/ mirror of run_20260713_230656 mid-flight -- first run entirely under
    the new physics (battery pack sag/power ceiling, saturation-as-clamp).
    cfd/manifest.json records the 12 drag-calibration cases and the component
    buildup's CdA predictions they will be measured against.
2026-07-13 Lazy-load 3D mesh payloads: index.html 66 MB -> 2.6 MB
    Mesh blobs are no longer inlined into the gallery page. Every candidate
    gets a JSONP-style frames/gen_XXXX/<hash>.mesh.js next to its .mesh.json,
    recorded in a small inline blob-src map; opening an overlay injects only
    the <script src> payloads that view needs (candidate, lineage root, replay
    chain). Script injection works over both file:// (where fetch() is
    CORS-blocked -- the reason blobs were inlined) and GitHub Pages. The 64 MB
    embed budget is gone: EVERY candidate is now viewable, and index.html
    stays ~3 MB no matter how long the run gets (GitHub's 100 MB blob limit
    made a 100-generation run unpushable before). publish_docs mirrors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
2026-07-13 cfd-calibrate --jobs N: concurrent case solves
    Each case is a serial container run; --jobs 3 turns the 12-case
    calibration from ~half a day sequential into an overnight ~3-4 h batch.
    Cases with forces already present (solved or currently in flight from
    another invocation) are skipped, so parallel invocations compose.
2026-07-13 Rebrand the report: framevo is now Airloom
    Airloom (heirloom + air): every frame inherits from its ancestors and the
    gallery is the family archive. Display rename only -- gallery/lineage/
    glossary titles, nav brand, README. Package, CLI and repo URL stay
    framevo until the full migration.
2026-07-13 Adds CFD calibration
2026-07-13 Apply CFD drag calibration; robustness verdict STABLE — milestone 1 closed
    The overnight OpenFOAM batch (cfd/calibration.md, 12 cases) measured the
    handbook buildup ~2x too pessimistic at cruise tilt, with -6/-27/-37%
    assembly interference at 0/20/40 deg, and near-identical ratios for a
    contrasting genome (systematic error, not gene-dependent). CAL_* tables
    in aero.py now correct per-class Cds vs tilt and apply the interference
    factor in drag_table_from_areas (calibrated=True default); round-trip
    unit-tested to +-3% of the measured CdAs. Post-calibration
    `framevo robustness`: STABLE (min Spearman 0.958, no champion flips) --
    the ranking is a frame property, so the per-candidate CFD pipelin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
2026-07-13 Add the calibration itself (aero.py) missed from d4e8415; fix storm test
    d4e8415 shipped the docs and round-trip test but a failed `git add` (an
    ignored path in the same command aborted staging) left aero.py and
    cfd/calibration.md out, and the chained command committed past a red
    test. This adds the CAL_* tables + calibrated drag_table_from_areas and
    the measured-CdA report, and pins the storm clamp-semantics test to the
    uncalibrated table -- under calibrated drag the baseline barely saturates
    in the storm at all, which is the calibration working as intended.
2026-07-13 Re-derive gallery benchmark lines under calibrated physics: 5.5 / 3.8
    Same methodology, updated multiplier: real-world calm-cruise anchors
    (2.9 Wh/km current practice, 2.0 record-class) x the portfolio's
    calm->aggregate ratio, now MEASURED under the CFD-calibrated model
    instead of assumed: 1.90 for both the real V6 and the evolved champion
    (frame-independent). 2.9x1.90 = 5.5 target, 2.0x1.90 = 3.8 record.
2026-07-13 Full Airloom rename: package, CLI, docs, everything
    src/framevo -> src/airloom, pyproject name + entry point (with `framevo`
    kept as a legacy CLI alias), all imports, Makefile, README, PLAN, config
    comments, glossary command examples. 85 tests green under the new name.
    Repo renames to akaalias/airloom in the same breath; the GitHub Pages
    path moves from /framevo/ to /airloom/ and the homepage featured link
    follows.
2026-07-14 Gallery: "the process" section — loop, physics, audit
    Three-column methodology block after the game board: how candidates come
    to exist (GA operators + Claude designer/narrator + patience pivots), how
    they are scored (measured prop tables, fixed-seed Dryden gusts, battery
    sag, CFD-calibrated drag with the interference finding), and why the
    numbers deserve trust (perturbation-sweep STABLE ordering, refined
    structural champion checks, bench print-and-test protocol). GA/designer
    parameters are read from the live config, not hardcoded.
2026-07-14 Flight tab: replay the scored flights in 3D
    simulate_scenario grows an optional decimated telemetry tap (trace_hz);
    flythrough.py re-simulates champion + best-so-far setters across all six
    scenarios (fixed gust seeds = exact replays) into lazy JSONP payloads,
    cached by existence so a gallery refresh only costs new setters.
    The overlay's new "flight" tab replays them: model posed from the
    recorded thrust vector (heading from motion), rotors spun at an
    RPM-proportional display rate with counter-rotating diagonals (blade
    clusters via farthest-point k-means, re-centered on the blade-root hub
    so they don't wobble), a live HUD (ground/air speed, tilt, RPM, pack
    watts + sagging volts, THRUST LIMIT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
2026-07-16 Gallery: evolution/performance overlays, trimmed retina stills, split replay
    - Detail cards get two stacked buttons under the thumbnail: "view
    candidate evolution" (the model overlay, flight tab removed) and
    "view candidate performance" (same overlay chrome with the weather
    scenarios as top-bar tabs driving the flight replay; disabled for
    candidates without telemetry)
    - Stills are auto-trimmed to content and re-rendered at retina
    resolution (1440x1080 top, 2400x2400 bottom) so thumbnails fill
    their frames; slight rounded corners on all candidate thumbnails
    - Flight tab gains a synced oldest-ancestor split replay; flights are
    now also curated for each setter's oldest ancestor
    C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
2026-07-16 3D viewer: default camera shows the nose (FPV camera) side
    Same tilt as before, yawed 180 degrees so the front of the candidate
    faces the viewer instead of the back.
2026-07-16 Anchor all comparison views to the baseline (gen-0 winner)
    - "vs oldest ancestor" becomes "vs baseline": the side-by-side, the
    net-change ghost, and the performance overlay's split replay all
    compare against the generation-0 winner (whose flight telemetry is
    always curated, since the gen-0 winner is a best-so-far setter)
    - The lineage trail draws the baseline as the oldest ghost and the
    replay starts from it as step 1 (timeline thumb labeled "base")
    - Chart x-axis pivot labels drop the circular-arrow glyph (green
    already marks them); legend swatch updated to match
2026-07-16 Deep links: shareable URLs for every overlay view
    #ovl-<hash>/<tab> reopens a candidate's evolution overlay on that tab;
    #perf-<hash>/<scenario> reopens the performance overlay on that weather
    scenario. The hash tracks tab/scenario switches live (replaceState, no
    history spam), so the address bar is always copy-to-share, and closing
    the overlay leaves the plain #d-<hash> card anchor behind. Unknown or
    disabled tabs in a link fall back to the default view.
2026-07-16 3D viewers: hover parallax invites interaction
    Until the first real drag, a hovered canvas leans a few degrees toward
    the cursor (eased, ~3.5deg yaw / 2deg pitch) -- a wordless hint that
    the view is live 3D. Grabbing folds the lean into the camera so drags
    start from the visible pose; one drag anywhere retires the effect for
    the page visit. Skipped under prefers-reduced-motion.
2026-07-16 Landing page: the result first; gallery becomes the research log
    - index.html is now a lean landing page (14KB): the champion spinning
    in live 3D, its energy score and % improvement over the baseline, a
    baseline-vs-champion comparison, and a "how we got here" section
    with the evolution replay, net change, and lineage trail -- the same
    interactive components the log uses. Old #ovl-/#perf-/#d- share
    links redirect to the log.
    - The full gallery moves to log.html ("research log"); nav on every
    page (glossary included) gains the new home.
    - The 3D engine (makeState/makeViewer/shaders/parallax/blob loading/
    chain math) plus the replay, trail-spec, and chain-frame components
    are ex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
2026-07-16 Landing intro: title, project description, and the champion's card
    The landing now opens with "The snuggle is real" + the project
    description for someone arriving cold, followed by the champion's full
    candidate card. The card is the SAME component the research log
    renders for every candidate -- extracted into
    gallery.candidate_card_html (+ CARD_CSS and the shared LAZY_IMG_JS
    loader) instead of copying markup. On the landing its thumbnail and
    buttons deep-link into the log's overlays, and parent links point at
    the log's detail cards.
2026-07-16 Landing polish: in-page overlay, stats up top, headline as one line
    - The full-screen 3D overlay (all tabs + flight replay) is extracted
    into shared OVERLAY_CSS / overlay_html() and embedded on the landing
    too: the champion card's thumbnail and buttons now open the overlay
    in place instead of navigating to the research log. Share links for
    other candidates still redirect there; the champion's own deep links
    work right on the landing.
    - Fix: opening the landing no longer auto-scrolls to "how we got here"
    (the replay component chased its active thumbnail into view on open;
    it now only does so on user-driven steps).
    - The headline is the single line requested; the stats strip move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
2026-07-16 Candidate cards go live 3D in place
    Each card's bottom-view still swaps for a real interactive viewer
    (drag / scroll-zoom / double-click reset, hover parallax included) as
    the card nears the viewport -- the same lazy pattern as the stills.
    AL.liveCards releases each GL context when its card scrolls away, so
    hundreds of cards never exceed the browser's context cap; the still
    stays as the loading placeholder, the no-webgl fallback, and the
    crossed-out face of failed designs. Clicking the preview no longer
    opens the overlay -- the two buttons are the way in.
2026-07-16 Landing: evolution replay + pinned family tree replace the tail sections
    Everything after the champion card is replaced by two sections: "the
    evolution" (the replay player stepping from baseline to champion) and
    "the family tree" -- the same two-lens tree as the dedicated page,
    with the champion's full ancestry highlighted on load.
    The tree is extracted from write_lineage_page into a reusable
    component (lineage.TREE_CSS + tree_section_html with an optional
    pre-pinned candidate, lit quietly without the hover card); the lineage
    page renders through it unchanged, keeping its auto-reload as a page
    concern guarded by the component's exposed pin state.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
2026-07-16 Tree flipped newest-first + champion pinned everywhere; landing polish
    - lineage.svg now puts the LATEST generation at the top: the champion
    leads and ancestry flows downward into the past. Edges attach
    parent-top -> child-bottom accordingly; the pivot rule separates a
    pivot row from the older generation below it.
    - The dedicated family tree page pre-highlights the run champion's
    lineage (same quiet pin the landing uses); its intro explains both.
    - Landing headlines now say what the sections are ("watch the champion
    evolve: N generations, replayed step by step" / "the family tree:
    where the champion's bloodline runs through the whole run") and the
    dead older/newer stepper butto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
2026-07-16 Landing: performance row + note alignment + bordered 3D canvases
    - New "performance" section at the bottom: the champion flying every
    weather scenario side by side, each mini view posed live from its
    own scored-flight telemetry (attitude + rotor rpm, 8x, looped). All
    boxes share ONE camera state, so orbiting any box orbits them all in
    unison. Full-bleed row, per-scenario Wh/km captions, parked (no
    work) while offscreen.
    - Fix: hypothesis/method/result notes on the landing were centered --
    the tree component's generic .note rule (the lineage page footnote)
    collided with the card's; renamed to .tree-note.
    - 3D canvases get a quiet gray border so it is clear where the scroll
    whe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
2026-07-16 Landing intro: double the headline, larger lead, champion header
    h1 60px, the intro paragraph gets a 19px lead style of its own, and a
    new section header introduces the champion (hash, score, generation
    count) between the intro and the stats strip.
2026-07-16 Landing: champion header in plain language
    "we evolved the champion candidate to 12% better than the baseline"
    (computed) instead of the hash-and-units mouthful.
2026-07-16 Landing: "the bottom line" header, tighter and concrete
    "the bottom line: we evolved the champion to fly 12% more efficiently
    (Wh/km) across six weather scenarios" -- percentage and scenario count
    computed from the run.
2026-07-16 Replay opens at the default three-quarter tilt
    The replay component's camera now starts at the standard nose-side
    tilt like every other viewer instead of the top-down plan view; pages
    can still pass pitch to override. Applies to the landing replay and
    the overlay's replay tab alike.
2026-07-16 Family tree: hover previews any lineage over the resting pin
    Hovering a node now lights its ancestry (with the hover card) even
    while a lineage is pinned; mouseleave falls back to the pin -- the
    champion's default highlight is the resting state, not a lock. Click
    still re-pins, esc still releases.
2026-07-16 Real CFD streamlines: OpenFOAM RANS flow over the champion
    The flight views' wind channel is now simulation truth. `airloom
    cfd-flow [hash] --solve` meshes a candidate's full assembly (props
    excluded -- rotors are not modeled), initializes with potentialFoam,
    and solves simpleFoam (k-omega SST) at each weather scenario's mean
    relative wind, rotated into the body frame with the replay's own
    attitude reconstruction. A streamLine function object traces 180
    upwind seeds; only lines that measurably interact with the body
    (bend, or carry >18% speed disturbance) ship as lazy-loaded
    <hash>.<scen>.flow.js payloads. One mesh serves all six directions
    (symmetric domain, freestream BCs); re-seeding cost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
2026-07-16 CFD flow anchors to the world, not the craft's every wobble
    The streamlines were posed with the instantaneous replay attitude, so
    pitching the craft tilted the whole atmosphere with it. The flow now
    anchors at the trace's MEAN attitude -- the pose the steady CFD
    solution is actually valid for -- so the wind stays world-fixed and
    the craft oscillates within it. (True re-wrapping would need an
    unsteady solve; around the mean this is the honest approximation.)
2026-07-16 Quasi-steady flow sweeps: the field re-wraps as the craft pitches
    A scenario's flow payload can now carry a SWEEP: the same mesh solved
    at several angles of attack around the mean (cfd.generate_flow_sweep /
    extract_flow_sweep, freestream rotated in the body x-z plane -- no
    re-meshing). The viewer computes the live relative-wind angle each
    frame from telemetry and cross-fades between the two nearest solved
    fields, posed WITH the craft: the near field genuinely re-wraps as the
    attitude changes, the far field stays world-consistent by
    construction, and the mean-anchor clipping artifact disappears
    (residual mismatch <= half the sweep spacing). Single-field payloads
    keep the mean-attitude anchor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
2026-07-16 calm_warm quasi-steady sweep live; two-tone mono; perf button
    - calm_warm ships its 5-attitude sweep payload (58-75 interacting
    lines per field): the viewer blends between the two nearest fields
    by the live angle of attack, so the flow re-wraps as the craft
    pitches and the mean-anchor clipping artifact is gone (for this
    scenario; the other five stay single-field until swept).
    - The wind-tunnel mono model is two-tone now: evolved parts (deck +
    arms) a shade darker than the fixed kit, baked per-part at decode
    time; the performance overlay swaps its part-color legend for a
    matching mono legend (+ airflow swatch).
    - "view candidate performance" button under the landing's scenario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
2026-07-16 Social cards: OG/Twitter tags + a generated share image
    The landing ships full Open Graph + Twitter Card metadata with copy
    computed from the run (title, improvement %, scenario framing), and
    write_share_card renders share.png (1200x630) fresh with every landing
    build: paper background, the title, the headline stat in accent, and
    the CURRENT champion's render -- so the card never goes stale when a
    new run crowns a new champion. Published via docs/ like every artifact.
2026-07-16 Share card: a Tufte small-multiples plate of the run
    share.png is now 84 real candidates on bare paper -- no boxes, no
    borders, whitespace as the only separator, whole frames at uniform
    scale so silhouettes compare. Data-ink marks only: a small dot beneath
    the special frames (ink = best-so-far setter, purple = claude-designed,
    rust = champion) and one italic caption line with the count, the
    improvement, and the URL. Rebuilt per run like every artifact.
2026-07-16 Landing stats: 50% lighter than baseline replaces candidate count
    The champion's 70.0 g frame is half the 139.9 g of the gen-0
    baseline (the same reference the efficiency stat uses), which says
    more than the raw number of candidates evaluated.
2026-07-16 Build it: the champion as five flat templates, bolt-ready
    A new card at the end of the landing page draws the champion's five
    parts as true-scale SVG outlines on one shared scale, with per-part
    STL/SVG downloads, quantities, dimensions, and the material +
    thickness build spec (parts.json + README ride along in the .parts
    folder).
    The templates are now genuinely assemblable: the sweep genes rotate
    the arms away from the stock clamp pattern, so the export re-cuts the
    arm-clamp bolt holes into the main and mid plates where the placed
    tongues actually sit (verified 0.00 mm on all eight main-plate bolts),
    dropping stale stock holes that would overlap and skipping holes that
    would break out of a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
    [arm_front.stl, arm_rear.stl, frame_assembled.stl, plate_main.stl, plate_mid.stl, plate_top.stl]
2026-07-16 3D viewer models carry the re-cut arm-clamp holes too
    build_frame now applies the same clamp-hole re-cut the parts export
    ships to everything it builds -- viewer mesh payloads, renders, STLs,
    mass -- so the models no longer show the plate holes sitting over
    solid arm material once the sweep genes move the arms off the stock
    pattern. Verified: all eight bolt channels probe clear through main
    plate + arm on the champion's built mesh.
    The constraint checks deliberately still see the scaled stock pattern:
    feeding them the re-cut plates would retroactively flip validity on
    178 of 562 scored candidates (the plate-web check is very sensitive
    to the extra holes). Scored DB values are untouched; all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
    [frame_assembled.stl]
2026-07-16 Storm quasi-steady sweep lands — all six scenarios re-wrap live
    Final four-attitude CFD sweep extracted and folded in; every weather
    scenario now blends OpenFOAM streamline fields by live angle of attack.
2026-07-24 Search-quality fixes + two new geometry genes (tapered thickness, lightening cutouts)
    A 40-generation run plateaued mostly because of the search harness, not the
    genome: fitness was ~98% explained by frame mass, and 43% of all
    evaluations were invalid (immigrant 90%, pivot 60%) from pure geometry
    failures a flight simulation wasn't needed to catch. Four fixes address
    that: widen four gene bounds that were pinned at their own artificial
    floor rather than the real structural limit; give crossover/mutation/pivot
    the same cheap geometry pre-screen the Claude designer already used,
    bisecting infeasible children back toward a valid parent instead of
    wasting the slot; replace blind immigrant/seed s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
    [arm_front.stl, arm_rear.stl, frame_assembled.stl, plate_main.stl, plate_mid.stl, plate_top.stl]
2026-07-24 Real CFD streamlines for the new champion; cfd-flow gains --run-id
    The champion changed today (14-gene search, 16.3% better than baseline
    now vs. the prior run's number), so its real OpenFOAM RANS streamlines
    were re-solved and re-published across all six scenarios.
    Along the way, cfd-flow's champion auto-lookup used the most recently
    CREATED run rather than the one actually being worked on -- it doesn't
    take a candidate hash into account when resolving which run to search,
    so an abandoned/superseded run with a later timestamp could shadow the
    real one silently. Added --run-id, matching the pattern gallery and
    verify-champions already use, and used it explicitly here rather than
    relying on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
2026-07-25 Mobile fixes for the gallery viewer; reorder the champion evolution section
    - Candidate detail cards (viewer | metrics | parents) now stack instead
    of forcing horizontal scroll on narrow screens.
    - Two-finger pinch now zooms the 3D viewer on touch devices; the pointer
    handling was single-pointer only, so a second finger down previously
    did nothing (touch-action:none blocks the browser's native pinch too).
    - Landing page: the lineage trail (every ancestor superimposed) now
    shows full-width before the step-by-step replay, each with its own
    intro paragraph, instead of only the replay being embedded standalone.
    Also rolls the standing run back to generation 79 (champion 4553a646ccc2):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
    [arm_front.stl, arm_rear.stl, plate_main.stl, plate_mid.stl, plate_top.stl]
2026-07-25 Fix mobile viewport bugs: missing meta tag, nav overflow, pinch reliability
    - log.html (research log) was missing <meta name="viewport">, unlike the
    landing page -- without it mobile browsers laid the page out at a fake
    desktop width and shrunk the whole render to fit, which also silently
    disabled every max-width media query on that page and made native
    pinch-zoom rasterize an already-downscaled bitmap instead of the
    browser re-rendering canvases at full resolution. Very likely the main
    cause of the reported "chunkier on mobile" 3D views.
    - Top nav (5 links + brand, no wrap) mathematically couldn't fit a phone
    width and forced a horizontal scrollbar on every page that includes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
2026-07-29 Add surface-pressure visualization, restyle streamline colors, combine performance section
    New surface-pressure (Pa) tile row alongside the existing streamline tiles, both
    now sharing one intro section (one paragraph, two 6-tile rows) instead of two
    separate headings. Streamlines switch from a diverging red-blue speed colormap
    to a sequential viridis one, since velocity magnitude has no meaningful
    zero-crossing to diverge around -- pressure keeps its diverging blue-white-red
    scale since it does have one (freestream/gauge zero). Dropped the redundant
    "view candidate performance" button between the two rows (the candidate card
    above already has one). A wake-turbulence visualization was also pr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
2026-07-30 Fix mobile 3D loading: per-tile lazy mount/unmount, real failure fallback
    The two 6-tile performance/pressure rows and the lineage trail/replay
    mounted their WebGL contexts once and never released them, and the
    champion's full ancestor chain (dozens of mesh files, tens of MB on a
    long run) fetched eagerly on page load before anything else -- both
    starve mobile browsers' small WebGL context budget and stall loading.
    - Every lazy-mounted section (6-tile rows, trail, replay) now destroys
    its GL contexts when scrolled well off-screen and recreates them on
    return, via new AL.lazySection/AL.freshCanvas helpers.
    - The lineage chain fetch is deferred until the trail/replay panels are
    actually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
2026-07-30 Fix sudden 180-degree model flip during telemetry replay
    The out-and-back mission (fly north, then south) reverses ground-track
    heading by exactly 180 degrees at the turnaround, and again at the loop
    restart. The body-frame basis was reconstructed from the raw position-
    derivative heading each frame, so that reversal copied straight through
    as an instant snap to the model's displayed attitude -- indistinguishable
    from a bug, especially since it could land while a user was mid-drag or
    hovering a tile, making it look input-related. Slew-limit the heading
    ANGLE (with proper shortest-path wraparound) instead of copying the raw
    vector, so a reversal now reads as a fast continuous turn. Fixed in b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
2026-07-30 Fix scenario-row tiles racing the champion mesh fetch, add GL context-loss handling
    Root cause of tiles staying permanently blank on mobile: the two 6-tile
    scenario rows called w.v.load() as soon as their OWN flight telemetry
    resolved, but never actually waited for the champion's mesh blob itself --
    they silently relied on the hero card's unrelated fetch having already
    finished it first. Decoupling the rows from the (slow) lineage-chain
    fetch earlier this session made them mount much faster, which made this
    race far more likely to be lost: decodeBlob() would find nothing yet,
    models stayed empty, and the tile simply never drew again. No exception,
    so it was invisible in the console. Now each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
2026-07-30 Show one large tile per scenario row on mobile instead of six
    Even with context-loss handling and antialiasing off, six live WebGL
    contexts per row is still real GPU budget pressure on a phone, and six
    tiny tiles read poorly on a small screen regardless. Below 600px, show
    only cold_headwind (large) in each row; the other five are never even
    requested (contexts, not just DOM, are skipped on the JS side, matching
    the CSS that hides them). Desktop is unaffected -- still six per row.
    Claude-Session: https://claude.ai/code/session_01KCv4BHZJgKrQz3KKfjrjoy
2026-07-30 Slow the heading turn-rate cap, fix mobile copy for hidden UI
    The turn-rate cap on the telemetry heading fix (from this session) was
    still fast enough (10 rad/s, ~0.3s per 180-degree turn) that a dropped
    frame -- common on a device already under GPU/memory pressure -- could
    render most of the turn in a single gap with nothing in between, which
    looks exactly like an instant snap even though the underlying angle is
    mathematically continuous. Slowed to 2.5 rad/s (~1.3s) so it reads as a
    turn even across a stutter. This is very likely the "auto-rotating bug"
    users hit with zero interaction, ~20s in -- right where the out-and-back
    mission's real turnaround lands at 8x replay speed.
    Also: the par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
2026-07-30 Remove telemetry-driven model rotation entirely -- camera orbit only
    Smoothing the turnaround flip (previous commits) was the wrong fix for
    the actual complaint: any auto-rotation of the model at all -- sudden or
    smooth -- fights a user's own drag-to-orbit and reads as broken, since
    their input appears to get randomly overridden. The model's displayed
    orientation is now ALWAYS just the camera-orbit matrix, full stop; the
    craft's live flight attitude (heading, thrust tilt) is no longer applied
    to the render at all, for the mesh or for the wind-channel streamlines
    (kept visually consistent with the mesh, so neither looks unmoored from
    the other). The attitude computation itself is kept, rename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
2026-07-30 Include docs/viewer.js in the no-auto-rotation fix (missed in c063827)
    The shared engine file itself carries the actual telemetryR rename and
    render-rotation removal; the previous commit only staged the pages that
    embed a copy of it inline. Same change, no new behavior.
    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
2026-07-30 Share one camera across both scenario rows, not just within each
    The streamline row and the pressure row each got their own independent
    camera state, so orbiting a tile in one row never moved the other --
    inconsistent with "drag any box and everything orbits together" and
    confusing once the two rows visually read as one section. Both rows now
    lazily share a single camera state (created by whichever mounts first),
    so dragging any tile in either row orbits every tile on the page.
    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
